johonkanen/ac_psu_zynq_kicad/REUSE_LOG.md

# Changes to the reused DDR3 block

Source: juliancoy/zynqPCB, commit `5cb7c703` (NOTICE). The block is everything inside the `User.1` outline (PLAN.md §4.1).
Any change to its parts or copper goes here, with the reason and how it was checked. **Planned** entries are made
after the import (PLAN.md §4.2). **Done** entries name the commit.

| # | Status | Change | Why | Check |
|---|---|---|---|---|
| E1 | **done 2026-10-29** (`tools/block_e1.py`, run by `build_pcb.sh --rebuild` after the import) | **CK trunk (SoC → U16, In2 `SIGNAL1`):** add a coupled meander to the pair, plus extra length on CK_P only. Targets: **CK_P +4.30 mm (+28.5 ps), CK_N +3.23 mm (+21.4 ps)**, i.e. CK = DQS0 + 25 ps and CK P/N matched. Room: the straight runs at x = 165.2, y 125.6–130.5 (≈ 0.6 mm free per side) and y 117.9–120.4 (≈ 1 mm free per side), in source coordinates | UG933: CK ≥ DQS for every byte (write levelling). On JLC081611-7628 byte 0 is at **CK − DQS0 = 0.0 ps**. CK P/N is 7.1 ps (N leg 1.5 mm longer, which over-compensates the 2.9 ps package difference) | `tools/ddr3_review.py` on both DRAMs: byte 0 CK − DQS ≥ +20 ps, CK P/N ≤ 1 ps; A/C − CK stays inside ±123 ps (expected −24…+7 ps); DRC with our rules |
| E2 | planned, optional | DQS3_N +1.34 mm (+8.9 ps) on In2 | DQS3 P/N 8.9 ps, the largest pair skew in the block | as E1 |
| E3 | done in the schematic (`tools/sheets/01_ddr3.py`, 067ab9f); **copper done at the import** | U8 (TPS51200) EN: the global label `DDR3_VTT_EN` becomes a hierarchical label (sheet port, input), to be driven by our power sequencing (sheet 4). R25 (20 k to 3V3, on juliancoy's DDR3 sheet) stays as the EN pull-up; PS_MIO14 is no longer on the net | keeps bank 500 free and at 1.8 V (the 20 k pull-up to 3V3 would back-drive a 1.8 V MIO) | `tools/check_block_netlist.py`: U8.7 + R25.2 form one net, as in the source minus U20.B6; ERC (the port is undriven until sheet 4 exists) |
| E4 | done in the schematic (`tools/sheets/01_ddr3.py`, 067ab9f) | U15/U16 value MT41K256M16HA-125:E → MT41K256M16TW-107:P (same land); MPN = MT41K256M16TW-107:P, LCSC = C253882; the SnapEDA fields Field4–Field8 (they name HA-125:E) and the Digikey SPN dropped | HA-125 has 0 stock at JLC | footprint unchanged (`DFTcustom:FBGA-96-DDR3-SDRAM`, checked by `tools/check_block_netlist.py`); courtyard for the 8 × 14 mm body still to check at the copper import |
| E5 | done in the schematic (`tools/sheets/05_soc_power.py`, 957524d); copper: H10 cut from +1V8 at the import, **planelet + via planned (phase 4)** | **VCCPLL (U20 H10)** is cut from +1V8 and fed from 1V8 through FB501 (BLM18SG121TN1D, 0603) + C528 10 µF 0603 + C529 0.47 µF 0402: net `VCCPLL`. **FB1** (juliancoy's bead on VCCAUX) stays on its land as a **0 Ω jumper**, so VCCAUX is on 1V8. Copper: isolate the H10 via from the +1V8 pour and run a planelet (≥ 2 mm, < 76 mm) to C528; C529 within 5.1 mm of the H10/GND vias | UG933 Ch. 5: when VCCPLL comes from VCCPAUX it **must** go through a 120 Ω bead + ≥ 10 µF 0603. juliancoy has the bead on VCCAUX and VCCPLL straight on +1V8. With FB1 = 0 Ω the 1V8 caps count for VCCAUX (UG933 Table 3-1); as a bead, VCCAUX would need its own 47/4.7/0.47 µF (user, 2026-10-27) | `tools/check_block_netlist.py`: U20.H10 listed as an expected difference, FB1 pads keep the source nets; ERC (PWR_FLAG on VCCPLL) |
| E6 | done in the schematic (`tools/sheets/05_soc_power.py`, 957524d); **copper done at the import** | **C59 (ball E12, MIO1) and C122 (ball C6, MIO0)**, +3V3 on juliancoy, are on 1V8 | both MIO banks are 1.8 V (decided 2026-10-26); juliancoy runs them at 3.3 V | `tools/check_block_netlist.py`: C59.1 / C122.1 expected differences |
| E7 | done in the schematic (VCCO_MIO: `tools/sheets/06_soc_config.py`; VCCO_34/35: `tools/sheets/11_soc_pl.py`); copper: VCCO_MIO done at the import, **12 VCCO_34/35 balls to connect (phase 4)** | **U20 VCCO balls whose rail changes:** VCCO_MIO0 B3, C6 and VCCO_MIO1 A10, B13, D9, E12 go from +3V3 to **1V8**; VCCO_34 K17, L20, N16, P19, R22, T15 and VCCO_35 A20, C16, D19, E22, F15, G18, H21 go from **GND** (banks unused on juliancoy) to **3V3**. Their fan-out vias must not be imported with the source net; map them by ball | MIO banks at 1.8 V; banks 34/35 carry our PL I/O at 3.3 V. The schematic side comes with the bank units (sheets 6 and 11), which the check then compares | `tools/check_block_netlist.py` expected differences (sheet 6 for VCCO_MIO, sheet 11 for VCCO_34/35); DRC after the import |
| E8 | done in the schematic (`tools/sheets/06_soc_config.py`, 9c5470b); **copper done at the import** | **RSVDGND (U20 G10) left open**: juliancoy ties it to GND. Drop its GND via/connection at the copper import | UG865 v1.9 Table 1-5: "Reserved pins—do not connect" (revised in v1.8) (user, 2026-10-27) | `tools/check_block_netlist.py`: U20.G10 expected difference |
| E9 | done in the schematic (`tools/sheets/11_soc_pl.py`); **copper done at the import** (the J3 balls are routed in phase 4) | **Banks 34/35 I/O balls off GND:** juliancoy ties all 50 I/O balls of each unused bank (34, 35) to GND, with their VCCO. Here bank 34 carries the 32 J3 signals and PUDC_B (K16) goes to VCCO_34 = 3V3; the other bank 34 balls and all of bank 35 (spare) are left open. At the import, drop the GND vias/connections of these 100 balls and map them by ball, as for E7 | UG933 *Unconnected VCCO Pins*: an unused bank's VCCO and I/O balls all on one potential (GND on juliancoy). With VCCO at 3V3 (E7), an I/O ball on GND would be a short as soon as the PL drives it, and K16 must be high (STATUS.md, J3 safe state) | `tools/check_block_netlist.py`: the 100 balls are expected differences (one line per bank); DRC after the import |
| E10 | **copper done at the import** (2026-10-28, `ESCAPES` in `tools/import_block.py`) | **QSPI escapes copied:** for U20 A1 (`qspi_cs_n`), A2 (`qspi_io0`), A3 (`qspi_io3`), A4 (`qspi_sclk`), E4 (`qspi_io2`), F6 (`qspi_io1`), juliancoy's F.Cu fan-out from the ball to its first via (0.102 mm, 0.57–2.91 mm; one 0.48/0.25 via each, inside the block outline) is copied on our net. 8 segments + 6 vias. Phase 4 routes on from the vias | These balls face the DDR (bank 500, row A) and are walled in by byte-0 copper (DM0, DQ0/2/4/6, DQS0, DRST#): the router reports them `boxed_in_static` at every pose. juliancoy uses the same MIO1-6 for his boot flash and escapes them this way | the import asserts each escape is one F.Cu run to exactly one via with no other pad, on the expected net; with the escapes, 3 of the 6 nets route U20 → U801 on a trial board (the rest stop at U801's inner CSP balls, a flash fan-out question) |
| E11 | done in the schematic (`tools/set_lcsc.py`, run by `tools/build_schematic.sh`; 2026-10-29) | **JLC part numbers:** every block part gets an `LCSC` field. juliancoy's Murata/Yageo/Taiyo Yuden passives that JLC has as a basic part of the same value, size and dielectric (voltage at least the source's) are bought as that part: MPN changed, the Digi-Key fields MFR/SPN/SPR/SPURL dropped (CC0402KRX5R5BB474, GRM155R60G475ME47D, GRM188R61A106KE69J, JMK325ABJ107MM-P, GRM155R71H103KA88J, CC0402KRX7R6BB104, RC0402FR-0710KL, RC0402JR-074K7L, RC0402FR-07100KL, RC0402FR-07150RL). The rest keep their MPN (R25 0.1 %, the 40.2/80.6/240 R). FB1 (the E5 0 R) gets 0603WAF0000T5E / C21189: its MPN field still named the bead, so the BOM listed it as BLM18AG121SN1D. U20 = XC7Z020-2CLG484I / C157624 | JLC assembly; basic parts have no extended-part fee | values and footprints unchanged: `tools/check_block_netlist.py` 0 failures, DRC parity 0 |
| E12 | done (2026-10-29): schematic `tools/sheets/05_soc_power.py`, footprint swap `FP_SWAP` in `tools/check_block_netlist.py` (used by `make_board.py` and `import_block.py`) | **C67** (3V3 bulk, B.Cu) 100 µF 1210 → **22 µF 1206** CL31A226KAHNNNE (C12891, 25 V, 1.6 ± 0.2 mm) on the library C_1206 land at juliancoy's position and orientation; his via-in-pad copper unchanged (the 1206 pads sit 0.075 mm further out, the vias stay inside them) | the 1210 (2.7 mm max) over baseboard U17 (SOIC-16W, 2.65 mm) left −0.05 mm of the 5.3 mm gap; every 100 µF and 22 µF 1210 is 2.5 mm nominal. 22 µF is enough (user, 2026-10-29) | `check_heights.py` 0.85 mm left; `check_block_netlist.py` reports the footprint as expected; `import_block.py` pad check within 0.1 mm; both pads connected to their vias (pcbnew connectivity); DRC parity 0 |
| E13 | done (2026-10-30): `tools/block_e13.py`, run by `build_pcb.sh --rebuild` after `block_e1.py` | **C99** (1V35 bulk, 100 µF 1210, F.Cu) moved **2.2 mm north** (towards U15), to (156.9, 72.6) at pose A. Its GND via-in-pad stays at juliancoy's place (156.9, 76.2) and a 0.3 mm F.Cu GND track joins the moved pad 2 to it: under the moved pad the inner layers carry DDR3 copper everywhere (DQS3_N on 3.Sig among others), so no 0.48 mm via fits there. Pad 1 stays on the F.Cu 1V35 pour | its body (2.7 mm max) reached 1.2–1.4 mm inside the heatsink base (24 × 23.5 mm on U20, POWER_BUDGET.md §Heatsink), where nothing may be taller than the package (≈ 1.5 mm); found on the phase 3 renders. The body now ends at y 74.3, 0.7 mm clear of the base | DRC unchanged (0 parity, no clearance or courtyard errors, unconnected count unchanged, so both pads connect); `check_block_copper.py` 0 failures (rails are not compared item by item); a `--rebuild` reproduces the board (tracks and footprints identical) |

**E1 as built (`tools/block_e1.py`, 2026-10-29).** The room named above (source x 165.2, y 125.6–130.5 and 117.9–120.4)
is, in our frame, the trunk's straight runs at U20 + (−0.80/−0.60, −16.4…−11.5) and (−0.80, −24…−21.6), around
juliancoy's own small CK meander:
- a **coupled serpentine** of the pair in the 4.7 mm window y 70.65–75.35: rungs at 0.5 mm pitch, amplitude 0.299 mm,
  45° corner cuts; P and N are the centreline's ±0.102 mm offsets, so the 0.102 mm gap holds. Both legs +3.230 mm;
- a **P-only bump** 0.711 mm west of CK_P at y 63.3–64.9 (the free side; N stays straight): CK_P +1.070 mm.
- Totals: **CK_P +4.300 mm, CK_N +3.230 mm.** Nearest other net 0.208 mm (BA1). The script checks clearance before it
  writes, against In2 copper and every via.
- `tools/ddr3_review.py`, both DRAMs: **byte 0 CK − DQS +27.5 ps** (was +2.6), **CK P/N 0.0 ps (U16) / 0.1 ps (U15)**
  (was 7.1), addr/cmd − CK −24.3…−0.6 ps (U16) and −21.1…+1.8 ps (U15): all PASS at the derated limits. KiCad DRC: no
  new errors. `tools/check_block_copper.py` lists DDR3_CK_P/N as the expected E1 difference. The import makes the copper side of E3 and E5–E9 itself:
it detaches every ball whose net changed, then handles its fan-out (the copper serving only that ball):

| Balls / pads | What the import did |
|---|---|
| E7 VCCO_MIO (B3, C6, A10, B13, D9, E12), E6 (C59.1, C122.1), E7 C16 (VCCO_35) | fan-out kept, moved to the ball's new net (1V8; 3V3 for C16) |
| E3 B6 | the PS_MIO14 branch removed: the F.Cu dog-bone and 21 items of the In6 trace back to R25/U8 (pruned); R25–U8.7 stays |
| E8 G10, B15 (bank 35, now open) | fan-out dropped |
| E5 H10 | its fan-out also served neighbouring +1V8 balls, so the items on H10 were dropped and H10 has no via yet. **Phase 4:** a via and the VCCPLL planelet to C528, as in E5 |
| E9: the 100 bank 34/35 I/O balls (except B15); E7: the other 12 VCCO_34/35 balls; PUDC_B K16 | **no copper of their own in the source** (they reached GND through the F.Cu pour only). The copied pour now clears them. **Phase 4:** connect VCCO_34/35 to 3V3 and route the J3 balls |

Check: `tools/check_block_copper.py`. All 82 signal nets of the block match the source item by item; the only
difference is E3 (23 items). `tools/ddr3_review.py` on both DRAMs gives the source's lengths, layers and vias; the
delays differ by up to 5 ps, because the via barrels are now computed on the real stack-up (the source file has none).

**Bank 0 stays at 1.8 V, as on juliancoy** (user, 2026-10-27): VCCO_0, RSVDVCC1–3, CFGBVS (to GND) and the
PROGRAM_B/INIT_B pull-ups R9/R10 keep the source's nets and copper. So no entry is needed for them.

**SoC decaps in the block** (sheet 5, source refs), from juliancoy's power.sch: C4, C5, C8, C9, C11, C14, C15, C17–C20,
C23, C24, C26, C28–C31, C33, C34 and FB1. The rule is a footprint centre within 4 mm of the U20 body. The 3V3 caps
under U20 that juliancoy drew on other sheets are in the block too: C46, C47, C50, C55, C57, C59, C61, C65, C67, C114,
C116–C119, C121, C122. Not in the block: the bulk caps among juliancoy's regulators (C6, C12, C22, C25, C27, C32,
15–22 mm from the centre).
