johonkanen/ac_psu_zynq_kicad/ZYNQ_PCB_NOTES.md

# XC7Z020-CLG484 PCB design notes

Device rules for the schematic and the layout of the Zynq control card. The board-level decisions (which signal goes
where, part choices) are in `PLAN.md`; the review of the reused DDR3 block is in `DDR3_REVIEW.md`. This file covers
what the Zynq-7000 itself requires.

Written 2026-10-26, from:
- UG933 (PCB design guide) v1.13.1;
- DS187 (data sheet) v1.21;
- UG865 (packaging and pinout) v1.9;
- UG585 (TRM), the HTML edition on docs.amd.com.

The PDFs are not in git; `reference/vendor/README.md` lists them and how to fetch them. Items marked **[verify]**
still need checking against a primary source or the Vivado pin planner.

---

## 1. Package

- **XC7Z020-2CLG484I** (LCSC C157624). User decision 2026-10-29: speed grade −2 or −3, any temperature grade JLC
  stocks; not −1 (was 2026-10-26: −1 or −2). Same balls and package delays.
- CLG484: 19 × 19 mm, 0.8 mm pitch, wire-bond, 22 × 22 array.
- **200 PL SelectIO** (all HR, in banks 13, 33, 34, 35) and **128 PS I/O** (UG865 Table 1-2).
- The -1 and -2 grades share the footprint and pinout; -2 runs the CPUs faster (766 vs 667 MHz).

| Bank | Type | Contents | VCCO on this card |
|---|---|---|---|
| 0 | config | PROGRAM_B, INIT_B, DONE, CFGBVS, JTAG, XADC, DXP/DXN, VCCBATT | **1.8 V**, as on juliancoy (user, 2026-10-27): the block's copper for VCCO_0, RSVDVCC and R9/R10 stays as it is |
| 13, 33, 34, 35 | PL HR (1.2–3.3 V) | user I/O; PUDC_B is ball **K16**, IO_L3P_T0_DQS_PUDC_B_34 | **3.3 V** (J3, J5, ADC, LEDs directly; no translators) |
| 500 | PS MIO0 | MIO[15:0], PS_CLK, PS_POR_B | **1.8 V** (QSPI IS25WP128; decided 2026-10-26) |
| 501 | PS MIO1 | MIO[53:16], PS_MIO_VREF, PS_SRST_B | **1.8 V** (eMMC VCCQ, RGMII) |
| 502 | PS DDR | DDR3L x32 (2 × MT41K256M16TW-107, the juliancoy block), dedicated balls | 1.35 V |

The 7Z020 has no HP banks, so the PL I/O cannot use DCI or anything above 3.3 V.

## 2. Supplies

DS187 Table 2 (recommended operating conditions) and the plan for this card. PS and PL rails may be merged as UG933
allows, as on the source boards.

| Rail on the card | V | Zynq pins | Range (DS187) | Notes |
|---|---|---|---|---|
| `1V0` | 1.00 | VCCPINT, VCCINT, VCCBRAM | 0.95–1.05 | VCCPINT "can be combined with VCCINT" when the PL never powers down alone (UG933 Ch. 5). VCCINT and VCCBRAM must share a supply (DS187 note 5) |
| `1V8` | 1.80 | VCCPAUX, VCCAUX, VCCO_MIO0, VCCO_MIO1, VCCO_0, RSVDVCC[3:1] | 1.71–1.89 | both MIO banks and bank 0 at 1.8 V; VCCAUX through FB1, now a 0 Ω jumper (REUSE_LOG E5) |
| `VCCPLL` | 1.80 | VCCPLL | 1.71–1.89 | from 1V8 through a 120 Ω @ 100 MHz 0603 bead + 10 µF 0603. A 0.47–4.7 µF 0402 cap goes ≤ 5.1 mm of trace from the VCCPLL/GND vias. A planelet ≥ 2 mm wide and < 76 mm long, or a trace ≤ 40 Ω and < 50.8 mm (UG933 Ch. 5; parts BLM18SG121TN1, GRM188R60G106ME47, GRM155R60J474KE19) |
| `1V35` | 1.35 | VCCO_DDR | 1.14–1.89 | DDR3L; also the DRAM VDD/VDDQ |
| `0V675` | VCCO_DDR / 2 | PS_DDR_VREF0/1, DRAM VREFCA/VREFDQ, VTT if used | – | divider or tracking regulator (§6.3) |
| `3V3` | 3.30 | VCCO_13/33/34/35 | 1.14–3.465 (HR VCCO) | |
| `VCCADC` | 1.80 | VCCADC_0 / GNDADC_0 | 1.71–1.89 | XADC unused: VCCADC to VCCAUX through a bead, GNDADC to GND **[verify against UG480]**. The source has VCCADC (K11) straight on +1V8, inside the block copper |
| – | – | VCCBATT_0 | 1.0–1.89 | no bitstream encryption: tie to GND or VCCAUX (DS187 note 10). The source ties it (G9) to GND, and so do we (block copper) |

**Decoupling** (UG933 Tables 3-1 and 3-2, CLG484 Z-7020; capacitor specs in Table 3-3):

| Supply | 330 µF | 100 µF | 47 µF | 4.7 µF | 0.47 µF |
|---|---|---|---|---|---|
| VCCINT | 1 | – | – | 2 | 4 |
| VCCBRAM | – | 1 | – | 1 | 1 |
| VCCAUX | – | – | 1 | 1 | 2 |
| VCCO per HR bank | – | 1 (47 or 100; one per four HR banks, note 3) | | 2 | 4 |
| VCCO_0 | – | – | 1 | – | – |
| VCCPINT | – | 1 | – | 1 | 3 |
| VCCPAUX | – | 1 | – | 1 | 1 |
| VCCO_DDR | – | 1 | – | 1 | 4 |
| VCCO_MIO0 / MIO1 | – | 1 each | – | 1 each | 1 each |
| VCCPLL | 10 µF + 0.47–4.7 µF (above) | | | | |

UG933 allows consolidating bulk capacitors when rails are merged (*Bulk Capacitor Consolidation Rules*, Ch. 3).
Sheet 5 (`tools/sheets/05_soc_power.py`) counts the block's caps per merged rail and adds the rest (C501–C529).
0.47 µF parts go under the BGA on B.Cu, as on the earlier cards.

## 3. Power sequencing and reset (DS187, UG585)

- **PS order (recommended):** VCCPINT → VCCPAUX + VCCPLL → VCCO_MIO0/MIO1 + VCCO_DDR. Reverse it at power-off.
  Supplies with the same voltage may share a regulator and ramp together.
- **PL order (recommended):** VCCINT + VCCBRAM → VCCAUX → VCCO.
- PS and PL are independent: either may come up first.
- **Ramp time:** 0.2–50 ms for every rail (DS187 Table 7).
- **VCCO_MIO / VCCO – VCCAUX/VCCPAUX ≤ 2.625 V,** except for at most T_VCCO2VCCAUX per power cycle: 800 ms at
  Tj 85 °C, 500 ms at 100 °C (DS187 Table 7). A 3.3 V bank rising before 1V8 counts against that time. So bring 1V8
  up no later than 3V3, which the enable chain below does.
- **PS_POR_B:**
  - Low until VCCPINT, VCCPAUX and VCCO_MIO0 are at their minimum, then at least **T_PSPOR = 100 µs** more
    (DS187 Table 22).
  - Do not release it inside the secure lockdown window relative to the last PL supply ramp (DS187 Figure 1).
    DS187 Table 23 gives T_SLW = t(last of VCCINT/VCCBRAM/VCCAUX/VCCO_0 at 250 mV) − t(PS_POR_B release); at 33.33 MHz
    the forbidden ranges are 12…40 ms (default), −16…12 ms (eFUSE CRC), −27…13 ms (PLL bypass) and −746…−705 ms
    (both). Here the last of those supplies is 1V8 (VCCAUX, VCCO_0), and PS_POR_B is released 180–425 ms after it
    (TPS3808 CT = VDD, 300 ms typ.), outside every range. CT open (12–28 ms) would not be.
  - At power-off, before VCCPINT falls below 0.80 V, assert PS_POR_B (or stop PS_CLK, or let VCCPAUX < 0.70 V or
    VCCO_MIO0 < 0.90 V) until VCCPINT < 0.40 V. This protects the eFUSEs.

  → A supervisor on the last rail's power-good, open-drain onto PS_POR_B, delay 300 ms (lockdown window above). It is
  the same scheme as the Ti135 card's TPS3808 into CRESET_N. Its SENSE watches 1V0 (0.895 V) for the power-off rule.
- **PS_SRST_B:**
  - pull up to VCCO_MIO1;
  - must be High to boot;
  - must not be asserted while the BootROM runs, or it locks down until the next POR (UG585 *External Reset Signal
    Pins*);
  - the minimum pulse is 3 PS_CLK cycles. A reset button belongs on PS_SRST_B, not on PS_POR_B (NASR-M ERRATA).
- **Enable chain (drawn, sheets 3–4):** 5V0 → `1V0` → PG → `1V8` (+ VCCPLL, VCCADC) → PG → `3V3` and `1V35` together →
  PG(3V3) & PG(1V35) = `DDR3_VTT_EN` (TPS51200 VTT) and the supervisor's ~MR → 300 ms → PS_POR_B. It meets both
  recommended orders and the VCCO – VCCAUX rule (3V3 starts only after 1V8 is at 95 %). Every TLV62585 ramps in
  0.9 ms (0.2–50 ms).

## 4. PS clock, boot mode and MIO

### 4.1 PS_CLK

- 30–60 MHz, single-ended LVCMOS at the **VCCO_MIO0 level**;
- duty cycle 40–60 %, ≤ ±0.5 % RMS jitter, rise/fall ≤ 6 ns (DS187 Table 20);
- the usual choice is a 33.333 MHz oscillator, as on pinguz97 and the ZedBoard; **here a 1.8 V part**, since bank 500 is
  at 1.8 V.

### 4.2 Boot mode straps (UG585 *Boot Mode Pin Settings*)

MIO[8:2] are sampled at PS_POR_B release. Every one needs **its own 20 kΩ** pull-up (1) or pull-down (0):
- **pull-ups go to VCCO_MIO0 only** (UG933 caution);
- no resistor trees: use one resistor plus a jumper if the strap must be changeable;
- the stub on MIO8 stays < 10 mm (it is also the QSPI feedback clock).

| Pin | Function | Setting on this card |
|---|---|---|
| MIO2 | BOOT_MODE[3]: JTAG chain | 0: cascaded (PS DAP + PL TAP on one JTAG) |
| MIO5 / MIO4 / MIO3 | BOOT_MODE[0] / [2] / [1]: boot device | **1 / 0 / 0 = Quad-SPI**. JTAG 000, NOR 001 (MIO3), NAND 010 (MIO4), SD 110 (MIO5 + MIO4) |
| MIO6 | BOOT_MODE[4]: PLLs | 0: PLLs enabled |
| MIO7 | VMODE[0]: bank 500 | **1 (pull-up) = 1.8 V**; 0 = 2.5/3.3 V. **Must match VCCO_MIO0, or I/O damage is possible** |
| MIO8 | VMODE[1]: bank 501 | **1 (pull-up) = 1.8 V** (the pull-up still goes to VCCO_MIO0, UG933 Table 5-3; both are 1V8 here) |

**The Zynq-7000 BootROM cannot boot from eMMC.** Its boot devices are QSPI, NOR, NAND, SD and JTAG. So:
- QSPI holds the FSBL, the bitstream and U-Boot;
- Linux and the rootfs go on the eMMC;
- JTAG boot is the recovery path, since the card has no SD socket.

### 4.3 MIO allocation (Vivado pin plan, 2026-10-27)

Checked in Vivado 2024.2 by `vivado/pinplan/pinplan.py`. The full table with every strap and pull is
`vivado/pinplan/mio.csv`; the I/O settings Vivado applied are in `vivado/pinplan/ps7_mio.csv`.

| Interface | MIO | Bank | Settings / notes |
|---|---|---|---|
| QSPI0 (single, x4): **ISSI IS25WP128-RHLE** (C1349419, 1.8 V, 128 Mbit, shared with the Agilex/Ti135 cards) | 1 CS#, 2–5 IO0–3, 6 SCLK, **8 feedback clock** | 500 | LVCMOS 1.8 V, fast slew. Ref clock 200 MHz → SCLK ≤ 100 MHz (feedback mode; MIO8 carries only its strap resistor). UG933: IO0–3 and SS matched to SCLK within ±50 ps; minimum trace delay from T_QSPICKD < T_CKO,flash + 2·T_pd |
| GEM0 RGMII → RTL8211F(DI) | 16 TXC, 17–20 TXD0–3, 21 TX_CTL, 22 RXC, 23–26 RXD0–3, 27 RX_CTL | 501 | **HSTL 1.8 V**, no pull-ups, fast slew. Receivers use **PS_MIO_VREF (F8) = 0.9 V**: 10 k/10 k divider + 10 nF. PHY internal delays (`rgmii-id`): DATA/CTL to CLK ≤ ±50 ps including package (UG933) |
| MDIO0 | 52 MDC, 53 MDIO | 501 | pull-up on MDIO to 1V8 |
| SD0 → eMMC (4-bit) | 40 CLK, 41 CMD, 42–45 DAT0–3 | 501 | LVCMOS 1.8 V, fast slew, 50 MHz. **0 Ω (40–60 Ω) series on CLK at the MIO pin**; DAT/CMD to CLK skew 50–200 ps (UG933 *SDIO*). Zynq-7000 SDIO is 4-bit, SD 2.0 high speed ≤ 50 MHz: no HS200/HS400, so DAT4–7 and DS stay unused (pull-ups only). No card detect: `non-removable` in the device tree |
| UART1 (console) | 48 TX, 49 RX | 501 | **decided 2026-10-27:** PS UART on 1.8 V MIO + a translator to the 3.3 V J2 header. TX and RX go opposite ways, so it needs per-bit direction: **not** an SN74LVC2T45 (one DIR for both bits); e.g. an SN74AVC4T774 as on J1, or 2 × SN74LVC1T45. The FSBL and U-Boot can print before the PL is configured, which an EMIO/PL UART could not |
| I2C0 | 50 SCL, 51 SDA | 501 | for an optional MAC-address EEPROM; 4.7 k to 1V8 at the far end; RC glitch filters (UG933 *IIC*) |
| GPIO | 7 `emmc_rst_n` (output-only pin), 9 `eth_rst_n`, 10 `eth_int_n` | 500 | `eth_rst_n` drives the PHY's 3.3 V PHYRSTB through an open-drain buffer (as on the Ti135 card); `eth_int_n` pulled up to 1V8: INTB is open drain, 3.3 V tolerant (RTL8211F Rev. 1.7 Table 4), Vol 0.4 V < MIO VIL 0.63 V (closed 2026-10-27, sheet 9). The `eth_rst_n` pull-down is 1 k to beat the MIO reset pull-up (IRPU ≤ 220 µA) |
| spare | 0, 11–15, 28–39, 46, 47 | | MIO14 was juliancoy's VTT enable (REUSE_LOG E3). 28–39 would be USB0 (unused) |

### 4.4 PL pin plan (Vivado, 2026-10-27)

**Result:** `vivado/pinplan/zynq_pinplan.csv` (signal → ball, bank, pin function), all LVCMOS33.
- **Banks:** bank 34 has the 32 J3 signals (7 user I/O left). Bank 33 has the ADC (6), the LCD/touch (12) and the 2
  LEDs (20 left). Banks 13 and 35 are untouched (40 each).
- **Why bank 34 for J3:** on the CLG484 grid (top view), the DDR (bank 502) is on the left edge and the MIO banks are
  top left. Banks 35/34/33 run down the right edge, and bank 13 is along the bottom. With the DDR side facing away
  from J3, the right edge faces J3, and bank 34 is in the middle of it.
- **Copper:** juliancoy has banks 34/35 unused, with VCCO and every I/O ball on GND. Here they are at 3V3 and their I/O
  balls carry our nets or stay open (REUSE_LOG E7, E9).
- **Kept free inside the banks:** the clock-capable pins (MRCC/SRCC) and the VREF pins, for later clocks.
  **PUDC_B (K16) is never used as I/O.**
- **Ball order:** a first pass from the package edge inwards. Re-order it once the parts are placed (pin swaps inside
  a bank are free, and the flow re-checks them).
- **Vivado check:** PS7 + all PL pins, synthesised and placed: **DRC 0, no critical warnings**. CFGBVS = GND,
  CONFIG_VOLTAGE 1.8 (bank 0 at 1.8 V since 2026-10-27; re-run then).
- **ADC:** the ADS7056 DVDD goes to 3.3 V on this card, so its SPI runs on the 3.3 V bank directly. The Ti135 card had
  DVDD at 1.8 V.

**PS7 DDR settings** (`vivado/pinplan/ps7.tcl`):
- MT41K256M16 RE-125 preset (the closest 4 Gb x16 DDR3L preset to our TW-107), 32-bit, 533.333 MHz, all three
  training steps on.
- Write-levelling start (DQS_TO_CLK) per byte, die to die with REUSE_LOG E1: 0.025 / 0.111 / 0.181 / 0.164 ns.
- Board delay: 0.305 / 0.262 / 0.313 / 0.321 ns.
- These go straight into `ps7_init` (write-levelling initial ratios 0x3 / 0xf / 0x18 / 0x16). Vivado's own
  package-inclusive calculation from the lengths agrees (0.031 / 0.117 / 0.187 / 0.164 ns).

Bank voltages (decided 2026-10-26):
- **Bank 501 at 1.8 V**, fixed by the eMMC VCCQ and the 1.8 V RGMII.
- **Bank 500 at 1.8 V** with the **IS25WP128-RHLE**, the flash part shared with the other cards. PS_CLK is a 1.8 V
  oscillator, and MIO7 is pulled up.

QSPI notes:
- 128 Mbit = 16 MB is the most the BootROM reaches with 3-byte addressing in single-flash mode. It holds BOOT.bin (FSBL +
  bitstream + U-Boot; the 7Z020 bitstream is about 4 MB uncompressed **[verify size]**), with room for a fallback image.
  Linux and the rootfs live on the eMMC.
- RESET# (ball A4): on `ps_por_n` (sheet 8), so the flash resets together with the PS.
- Check that Vivado/Vitis `program_flash` and U-Boot (`spi-nor`) list the IS25WP128 **[verify]**; it has SFDP. Drop-in
  fallback on the same footprint, as on the other cards: Micron MT25QU256ABA8E12-1SIT (1.8 V). Note that above 16 MB
  the BootROM only maps the first 16 MB.

## 5. PL configuration and JTAG (bank 0)

| Pin | Connection | Source |
|---|---|---|
| CFGBVS_0 | **to GND** (VCCO_0 = 1.8 V, as on juliancoy); to VCCO_0 only when VCCO_0 is 2.5/3.3 V. Wrong = damage. Vivado: `CFGBVS GND`, `CONFIG_VOLTAGE 1.8` | UG865 Table 1-5 |
| PROGRAM_B_0 | 4.7 kΩ pull-up to VCCO_0 (not floating); R9 in the block | UG933, UG470 **[verify value]** |
| INIT_B_0 | 4.7 kΩ pull-up to VCCO_0 (open drain); R10 in the block | UG470 **[verify value]** |
| DONE_0 | 330 Ω pull-up to VCCO_0, optional LED (unconnected on juliancoy) | UG470 **[verify value]** |
| PUDC_B (ball K16, IO_L3P_T0_DQS_PUDC_B_34) | **tie to VCCO_34 (High) directly or through ≤ 1 kΩ** → no internal pull-ups during configuration. Never float | UG865 Table 1-5 |
| TCK, TMS, TDI | pull-ups (UG933 *Boot Mode Pins* note); JTAG at VCCO_0 = **1.8 V**; J1 is 3.3 V (FTDI mini-modules, no VREF) through an SN74AVC4T774RSVR shifter, the Agilex 3 card's circuit (sheet 6). One header serves PS and PL (cascaded, MIO2 = 0) | UG933 |
| DXP_0 / DXN_0 | tie to GND when unused | UG865, UG933 |
| VP/VN, VREFP/VREFN | XADC unused: tie to GNDADC; VREFP/VREFN to GND selects the internal reference | UG480 **[verify]** |
| RSVDVCC[3:1] | **tie to VCCO_0** | UG865 Table 1-5 |
| RSVDGND | **do not connect** (UG865 v1.9; juliancoy ties G10 to GND, REUSE_LOG E8) | UG865 Table 1-5 |
| VCCBATT_0 | GND or VCCAUX (no encryption) | DS187 |

**PUDC_B High plus the 10 kΩ pull-downs on every J3 pin** keep the PWM/gate outputs low until the bitstream drives them.
This is the Zynq equivalent of the Ti135 card's gated translator OE (Ti135 `MIGRATION_PLAN.md` §3.2).

## 6. DDR3/DDR3L

### 6.1 Memory types, and why not DDR4

**The Zynq-7000 PS DDR controller supports DDR3, DDR3L, DDR2 and LPDDR2 only** (UG933 Table 5-1, UG585 *DDR Memory
Types*). There is no DDR4 option:
- not in the PS;
- not in the PL either: the 7-series MIG has no DDR4 support, and the 7Z020 has only HR banks anyway.

DDR4 begins with Zynq UltraScale+ (MPSoC). So "DDR4 routing" does not apply to this card; the rules below are the
DDR3/DDR3L ones.

**Controller limits** (UG585 *Connectivity Limitations*):
- 1 GB total;
- 16- or 32-bit data width (ECC only as 16 + 10 bits);
- 1 rank;
- 15 row bits and 3 bank bits: one x16 4 Gb chip (MT41K256M16) is the most a 16-bit bus can hold, so 512 MB;
- **16-bit mode uses PS_DDR_DQ[15:0], i.e. byte lanes 0 and 1** (UG585 *DDR I/O Signals*). Lanes 2/3 are left
  unconnected (UG933 Table 5-5).

Data rate: **DDR3/DDR3L ≤ 1066 Mb/s on every speed grade** (DS187 Table 18). Run 1066, with 800 as the fallback.

### 6.2 Connections (UG933 Ch. 5)

| Item | DDR3/DDR3L value |
|---|---|
| VCCO_DDR | 1.5 V (DDR3) / **1.35 V (DDR3L)** |
| PS_DDR_VREF0/1 | VCCO_DDR / 2: a divider or tracking regulator plus 0.01–0.47 µF. A separate divider and HF cap per IC if dividers are used. Floating when the internal VREF is used, which limits the rate to 800 Mb/s |
| VTT (only with parallel termination) | VCCO_DDR / 2 from a DDR termination regulator (e.g. TPS51200) |
| **PS_DDR_VRP → GND, PS_DDR_VRN → VCCO_DDR** | each through **2 × the trace impedance**: **80 Ω** for 40 Ω traces (UG933 Table 5-2). pinguz97 has these swapped (`DDR3_REVIEW.md` F2) |
| Rterm (addr/cmd/ctrl, to VTT, near the last DRAM) | **40 Ω** |
| Rclk (across CK_P/CK_N at the DRAM) | **80 Ω** |
| DRST_B | not terminated; **4.7 kΩ pull-down** |
| ZQ (DRAM) | **240 Ω 1 %** to GND per DRAM |
| DM | connect (DDR3 data mask) |
| TDQS_P/N (x8 parts) | not supported: leave floating |
| Single-ended DQS | DQS → DQS_P, DQS_N to the DRAM DQS# or a VCCO/2 divider |
| Unused pins (x16, no ECC) | lane 2/3 DQ/DQS/DM unconnected (software pull-ups) |

### 6.3 Routing (UG933 Ch. 5 and Appendix A)

- **Impedance:** 40 Ω single-ended and 80 Ω differential, ±10 %. Every DDR signal except DRST_B is controlled; for
  DDR3, CKE is controlled too.
- **Max length:** 8.55" (217 mm) for data and for addr/cmd.
- **Topology** (Table 5-12):
  - one DRAM: point to point for data, clock and addr/cmd;
  - two DRAMs: data point to point; clock fly-by; addr/cmd fly-by (or balanced T).
  - **Fly-by:** TL0 0–5.3", TL1 between DRAMs 0.35–0.75" (8.9–19 mm), TL2 to Rterm 0–1.0", total ≤ 8.55".
  - **Balanced T:** TL0 ≤ 3", equal branches on one layer, Rterm at the split.
  - Fly-by and point to point are recommended.
- **Delay matching, package delays included** (Table 5-9):
  - DQ/DM to DQS_P/N in the byte ±10 ps;
  - addr/cmd/ctrl to CK_P/N ±10 ps.

  These limits hold only at the SoC's rated speed with memory of the same rating. Appendix A relaxes them:

  | DDR3L, SoC rated 1066 | memory 1866 | memory 1600 | memory 1333 | memory 1066 |
  |---|---|---|---|---|
  | DQ/DM–DQS at 1066 | ±91 ps | ±50 ps | ±45 ps | ±10 ps |
  | addr–CK at 1066 | ±123 ps | ±103 ps | ±83 ps | ±10 ps |
  | both at 800 | ±150 ps | ±150 ps | ±150 ps | ±150 ps |

  (DDR3 at 1.5 V: DQ–DQS 104/91/73/45 ps at 1066; Table A-1.) With MT41K256M16TW-107 (1866) at 1066 MT/s the budget is
  **±91 / ±123 ps**.
- **CK ≥ DQS for every byte.** Write levelling can only delay DQS to meet CK. Read levelling is per byte, so
  bit-to-bit skew inside a byte matters. **Addr/cmd has no training**, only a fixed programmable offset, so keep
  CK–addr skew small.
- **Differential pairs:** match P/N so the crossing falls in the linear part of the edges (a few ps).
- **Swaps:** bit and byte swapping are allowed for DDR3 (Table 5-12 text), but bits stay inside their byte group. On
  a x16 part, "byte swap" means DRAM lower/upper byte ↔ controller lane 0/1, not a move to lanes 2/3.
- Keep each byte (DQ, DM, DQS) on one layer, over a solid GND reference. Change layers only next to a GND return via.
- **Place the DRAM as close as possible** (UG933).
- **Delays in KiCad:**
  - store the Xilinx package delays on the CLG484 pads: pad die length = mean delay / 6 ps/mm, as pinguz97's
    `footprint_add_die_lengths.py` does. KiCad 10 also takes pad-to-die *delays* directly, as the Ti135 repo's
    `tools/pad_to_die.py` writes;
  - measure die to die with `tools/ddr3_review.py` (`--pkg` takes the Vivado package CSV);
  - the per-layer speeds come from `tools/zsolve_cases.py` for the chosen stack-up.

### 6.4 Stack-up: JLC081611-7628 (decided 2026-10-26)

The copied block (juliancoy/zynqPCB) routes every DDR trace at **0.102 mm**, and pairs at 0.102/0.102 mm. Its file has
no stack-up, so the stack-up was chosen to put 0.102 mm on UG933's 40 Ω / 80 Ω.
- **Method:** `tools/stackup_scan.py` field-solved all 49 JLC 8-layer templates (KiCad files generated from JLC's API by
  gsuberland/jlcpcb_autogenerated_stackups), with juliancoy's layer roles: GND on In1/In3/In5, signals on
  F/In2/In4/In6.
- **Full table:** `reference/stackup_scan_0p102mm.txt`.
- **Layer use in the source:** CK and part of addr/cmd on In2 (`SIGNAL1`); all data on In4 (`SIGNAL2`); addr/cmd on
  In6 (`SIGNAL4`); 1 mm fan-out stubs only on F.

| Template | Thickness | Inner Cu | In2/In4 SE / diff | In6 SE / diff (no B plane) | F SE | Note |
|---|---|---|---|---|---|---|
| **JLC081611-7628** | 1.593 mm | 1 oz | **39.5 / 71.4 Ω** | **45.5 / 74.6** (47.4 / 74.9) | 111 Ω | **chosen** |
| JLC081611-2116B | 1.572 | 1 oz | 45.7 / 77.2 | 49.3 / 78.4 (53.3 / 79.2) | 103 | runner-up |
| JLC081211-1080C | 1.222 | 1 oz | 46.2 / 78.7 | 47.9 / 80.4 (63.8 / 88.4) | 78.5 | In6 depends on B |
| JLC081211-1080B | 1.282 | 1 oz | 47.3 / 79.3 | 49.1 / 81.0 | 78.5 | |
| JLC08121H-3313 | 1.193 | 0.5 oz | 51.2 / 86.7 | 47.9 / 83.3 (80.2 / 102.6) | 62.3 | cheapest near 50 Ω; In6 depends on B |
| JLC08081H-1080 | 0.772 | 0.5 oz | 41.1 / 76.2 | 36.1 / 69.1 | 55.5 | too thin for the sockets and the RJ45 |
| JLC08121H-1080A (pinguz97's) | 1.220 | 0.5 oz | 57.3 / 92.9 | 42.7 / 76.8 | 55.5 | |
| JLC08161H-3313 (Agilex/Ti135 cards) | 1.6 | 0.5 oz | > 60 on L5 | | | not suitable |

Build of JLC081611-7628:

```
F 35 um | 7628 prepreg 0.421 er 4.4 | In1 30 um | core 0.075 er 3.99 | In2 | prepreg 0.138 er 3.91 | In3 |
core 0.075 | In4 | prepreg 0.138 | In5 | core 0.075 | In6 | 7628 prepreg 0.421 er 4.4 | B
```

Why it was chosen:
- **1.6 mm**, so J3/J6/J9 stay as on the other cards.
- **In2/In4 (CK, data) are inside UG933's 40 Ω ±10 %.** The pairs are 71.4 Ω, 0.6 Ω under the 72 Ω lower limit:
  accepted.
- **In6 (addr/cmd) is 45.5 Ω and nearly independent of B.Cu** (47.4 Ω with no B plane). B is 0.42 mm away, so bottom-side
  regulators and pours under the block do not change it. On the thin-prepreg templates In6 jumps to 64–80 Ω where B is
  not solid.
- No re-width of the copied block is needed. Termination stays as UG933 has it (40.2 Ω, 80.6 Ω CK, 80.6 Ω VRP/VRN).

**Consequences for the rest of the board:**
- **F.Cu and B.Cu are poor impedance layers:** 0.102 mm is 111 Ω, and 50 Ω would take about 0.8 mm. Use them for
  fan-out, pours, power and slow signals. The exception is the **MDI pairs: 0.35/0.20 mm on F.Cu = 102 Ω**, which also
  follows NASR-M's erratum to keep MDI on an outer layer. The inner layers cannot reach 100 Ω differential at
  practical widths (0.10/0.40 mm gives 79 Ω).
- **Other single-ended nets on the inner layers** (RGMII, eMMC, QSPI): 0.09–0.102 mm gives 41–40 Ω, and 0.07 mm gives
  46 Ω. Fine for these interfaces, which have no impedance requirement in UG933, only skew limits.
- **Propagation for `ddr3_review.py`:** inner 6.63 ps/mm (In2/In4) and 6.80 (In6), outer 5.86. Pass `--ps-inner 6.65`
  (`--ps-outer 5.86`).
- **[verify at quote time]:**
  - JLC's minimum trace/space with 1 oz inner copper (the block needs 0.102/0.102 mm = 4/4 mil);
  - the surcharge for 1 oz inner and the 7628 template;
  - the via sizes against JLC's 8-layer rules.

### 6.5 PS7 configuration (Vivado)

- *DDR Configuration*:
  - memory part MT41K256M16 RE-125 (or the closest), DDR3 (low voltage), **32-bit** (2 × x16, 1 GB), 533.333 MHz,
    no ECC;
  - **Board delay** and **DQS to Clock delay** per byte, computed from `ddr3_review.py --json`: the trace delay of
    each byte's DQS and of CK, in ns;
  - write levelling, read gate and read DQS training: **on**.
- Run the FSBL's DDR init, then the Vitis `zynq_dram_test` (bring-up step 3) before anything else.

## 7. Required resistors at a glance

| Net | Part | Value |
|---|---|---|
| MIO2–MIO8 | one resistor each, to VCCO_MIO0 or GND | 20 kΩ (§4.2) |
| PS_POR_B | supervisor output, open drain, + pull-up to VCCO_MIO0 | 4.7–10 kΩ |
| PS_SRST_B | pull-up to VCCO_MIO1 | 4.7–10 kΩ |
| PS_MIO_VREF | divider VCCO_MIO1/2 + 10 nF | 2 × 10 kΩ (as on pinguz97) |
| CFGBVS_0 | to GND (VCCO_0 = 1.8 V) | direct |
| PUDC_B | to VCCO_34 | ≤ 1 kΩ |
| PROGRAM_B / INIT_B / DONE | pull-ups to VCCO_0 | 4.7 k / 4.7 k / 330 Ω **[verify UG470]** |
| TCK/TMS/TDI | on the 3.3 V side of the JTAG shifter: TCK 1 k down, TMS/TDI 10 k up; TDO 10 k up to 1V8 | 1 k / 10 kΩ |
| PS_DDR_VRP / VRN | to GND / to VCCO_DDR | 2 × Z0 (80 Ω for 40 Ω) |
| DRAM ZQ | to GND | 240 Ω 1 % |
| DDR_DRST_B | to GND | 4.7 kΩ |
| SD0 CLK | series, at the MIO pin | 0 Ω placeholder (40–60 Ω) |
| eMMC CMD / DAT0–3 | pull-ups to VCCQ (1V8) | 10–47 kΩ (KIOXIA: CMD 4.7–100 k, DAT 10–100 k) |
| I2C SCL/SDA | pull-ups at the far end | 4.7 kΩ |

## 8. Open items **[verify]**

- [ ] UG470 values for PROGRAM_B / INIT_B / DONE.
- [ ] XADC tie-off if it stays unused (UG480).
- [x] ~~The PS_POR_B secure-lockdown window~~ (DS187 v1.21 Table 23): closed with a 300 ms supervisor delay (§3, sheet 4).
- [ ] IS25WP128 support in Vivado `program_flash` and U-Boot; the 7Z020 bitstream size (§4.3).
- [x] ~~The full MIO and PL pin plan in Vivado~~ done 2026-10-27 (§4.3, §4.4).
- [x] ~~The UART path~~ PS UART1 on MIO48/49 + translator (§4.3).
- [x] ~~The RTL8211F INTB output level~~ open drain, 3.3 V tolerant: 4k7 to 1V8 is fine (2026-10-27, sheet 9).
- [ ] IS25WP128 reset recovery time after RESET# (on `ps_por_n`, sheet 8) vs the BootROM's first QSPI access.

## Sources

- UG933 *Zynq-7000 SoC PCB Design Guide* v1.13.1 (2019): Ch. 3 (decoupling), Ch. 5 (PS power and signalling, DDR),
  Appendix A (derating).
- DS187 *Zynq-7000 SoC (Z-7007S … Z-7020) Data Sheet: DC and AC Switching Characteristics* v1.21 (2020): Table 2,
  power sequencing, Table 7, Tables 18/20/22, Figure 1.
- UG865 *Zynq-7000 SoC Packaging and Pinout* v1.9 (2021): Tables 1-2 and 1-5.
- UG585 *Zynq-7000 SoC Technical Reference Manual* (docs.amd.com, map `27MqOpdJbAciY4iKGTycVA`): *Boot Mode Pin
  Settings*, *External Reset Signal Pins*, *DDR Memory Types, Densities, and Data Widths*, *DDR I/O Signals*.
- Package delays: `scripts/xc7z020clg484_delays.csv` in pinguz97/Zynq-SoM (a Vivado package file export).
