johonkanen/ac_psu_zynq_kicad/reference/baseboard_j11_pinout.csv

baseboard_pin | signal | direction_from_control_card | ti60_j11_pin(bottom-mounted) | agilex5_j3_pin_old(top-header numbering | before 2026-10-24)
1 | ISOADA3 | analog | 2 | 38
2 | ISOGND | gnd | 1 | 37
3 | ISOADA2 | analog | 4 | 36
4 | ISOADA1 | analog | 3 | 35
5 | ISOGND | gnd | 6 | 34
6 | MDATA_ISO | in | 5 | 33
7 | ADCLK_ISO | out | 8 | 32
8 | GPIO_BYPASS_RLY_ISOLATED | out | 7 | 31
9 | ADASEL2_ISO | out | 10 | 30
10 | ADASEL1_ISO | out | 9 | 29
11 | ADASEL0_ISO | out | 12 | 28
12 | SDATA1_ISO | in | 11 | 27
13 | CS1_ISO | out | 14 | 26
14 | CLK1_ISO | out | 13 | 25
15 | PWM_TRANS1_ISO | out | 16 | 24
16 | PWM_TRANS2_ISO | out | 15 | 23
17 | PWM_TRANS3_ISO | out | 18 | 22
18 | PWM_G4_ISO | out | 17 | 21
19 | PWM_G2_ISO | out | 20 | 20
20 | PWM_G1_ISO | out | 19 | 19
21 | PWM_G3_ISO | out | 22 | 18
22 | DAB_PWM_PRI_HI_ISO | out | 21 | 17
23 | DAB_PWM_PRI_LO_ISO | out | 24 | 16
24 | ADCLK_DAB | out | 23 | 15
25 | PWM_TRANS4 | out | 26 | 14
26 | MDATA_DAB | in | 25 | 13
27 | DAB_PWM_HI_SEC | out | 28 | 12
28 | PWM_TRANS6 | out | 27 | 11
29 | DAB_PWM_LO_SEC | out | 30 | 10
30 | PWM_Q5 | out | 29 | 9
31 | PWM_Q6 | out | 32 | 8
32 | INU_ADCLK | out | 31 | 7
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
