johonkanen/ac_psu_zynq_kicad/kicad/zynq_card.kicad_pcb

## KiCad design kicad/zynq_card.kicad_pcb (2026-10-30)

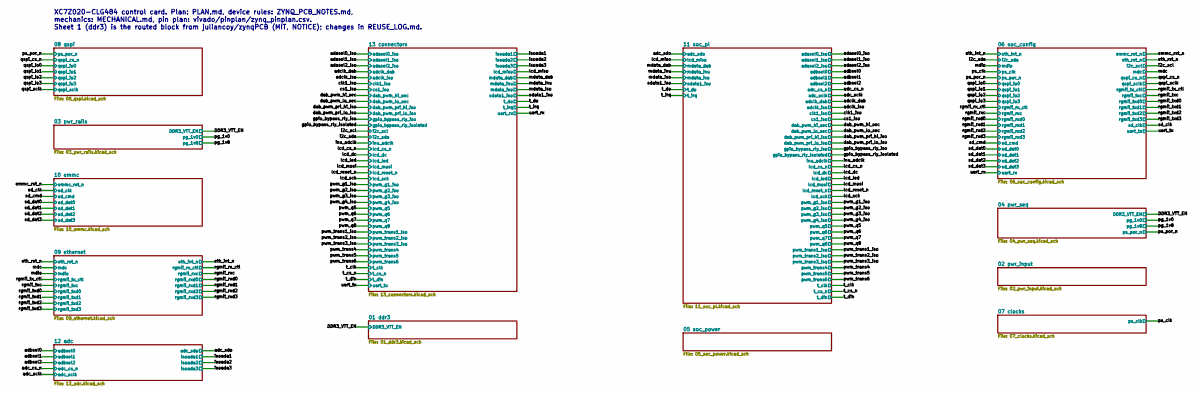
[picture p1: schematic zynq_card.kicad_sch, Zynq-7000 control card]

Notes on the sheet:
XC7Z020-CLG484 control card. Plan: PLAN.md, device rules: ZYNQ_PCB_NOTES.md, mechanics: MECHANICAL.md, pin plan: vivado/pinplan/zynq_pinplan.csv. Sheet 1 (ddr3) is the routed block from juliancoy/zynqPCB (MIT, NOTICE); changes in REUSE_LOG.md.

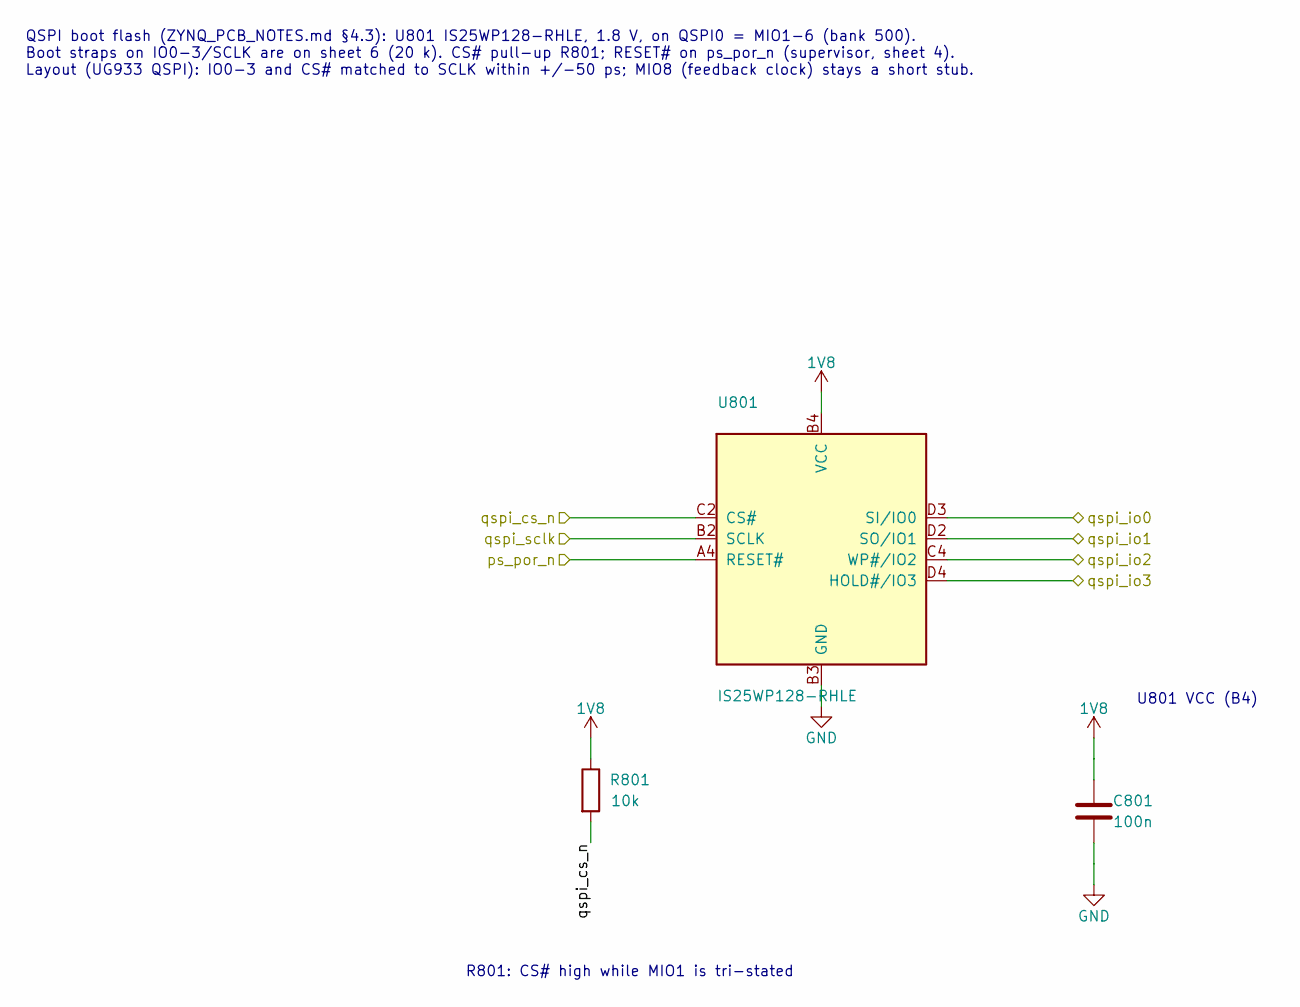
[picture p2: schematic 08_qspi.kicad_sch, Zynq-7000 control card - qspi]

Parts:
C801: 100n; C_0402_1005Metric; LCSC C1525
R801: 10k; R_0402_1005Metric; LCSC C25744
U801: IS25WP128-RHLE; MX25U25645G_CSP24_6x8mm_P1.0mm; LCSC C1349419

Connections:
1V8: C801.1, R801.1, U801.B4 (VCC); also elsewhere on the board
/ps_por_n: U801.A4 (RESET#); also elsewhere on the board
/qspi_cs_n: R801.2, U801.C2 (CS#); also elsewhere on the board
/qspi_io0: U801.D3 (SI/IO0); also elsewhere on the board
/qspi_io1: U801.D2 (SO/IO1); also elsewhere on the board
/qspi_io2: U801.C4 (WP#/IO2); also elsewhere on the board
/qspi_io3: U801.D4 (HOLD#/IO3); also elsewhere on the board
/qspi_sclk: U801.B2 (SCLK); also elsewhere on the board
GND: C801.2, U801.B3 (GND); also elsewhere on the board

Notes on the sheet:
QSPI boot flash (ZYNQ_PCB_NOTES.md §4.3): U801 IS25WP128-RHLE, 1.8 V, on QSPI0 = MIO1-6 (bank 500). Boot straps on IO0-3/SCLK are on sheet 6 (20 k). CS# pull-up R801; RESET# on ps_por_n (supervisor, sheet 4). Layout (UG933 QSPI): IO0-3 and CS# matched to SCLK within +/-50 ps; MIO8 (feedback clock) 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
R801: CS# high while MIO1 is tri-stated
U801 VCC (B4)

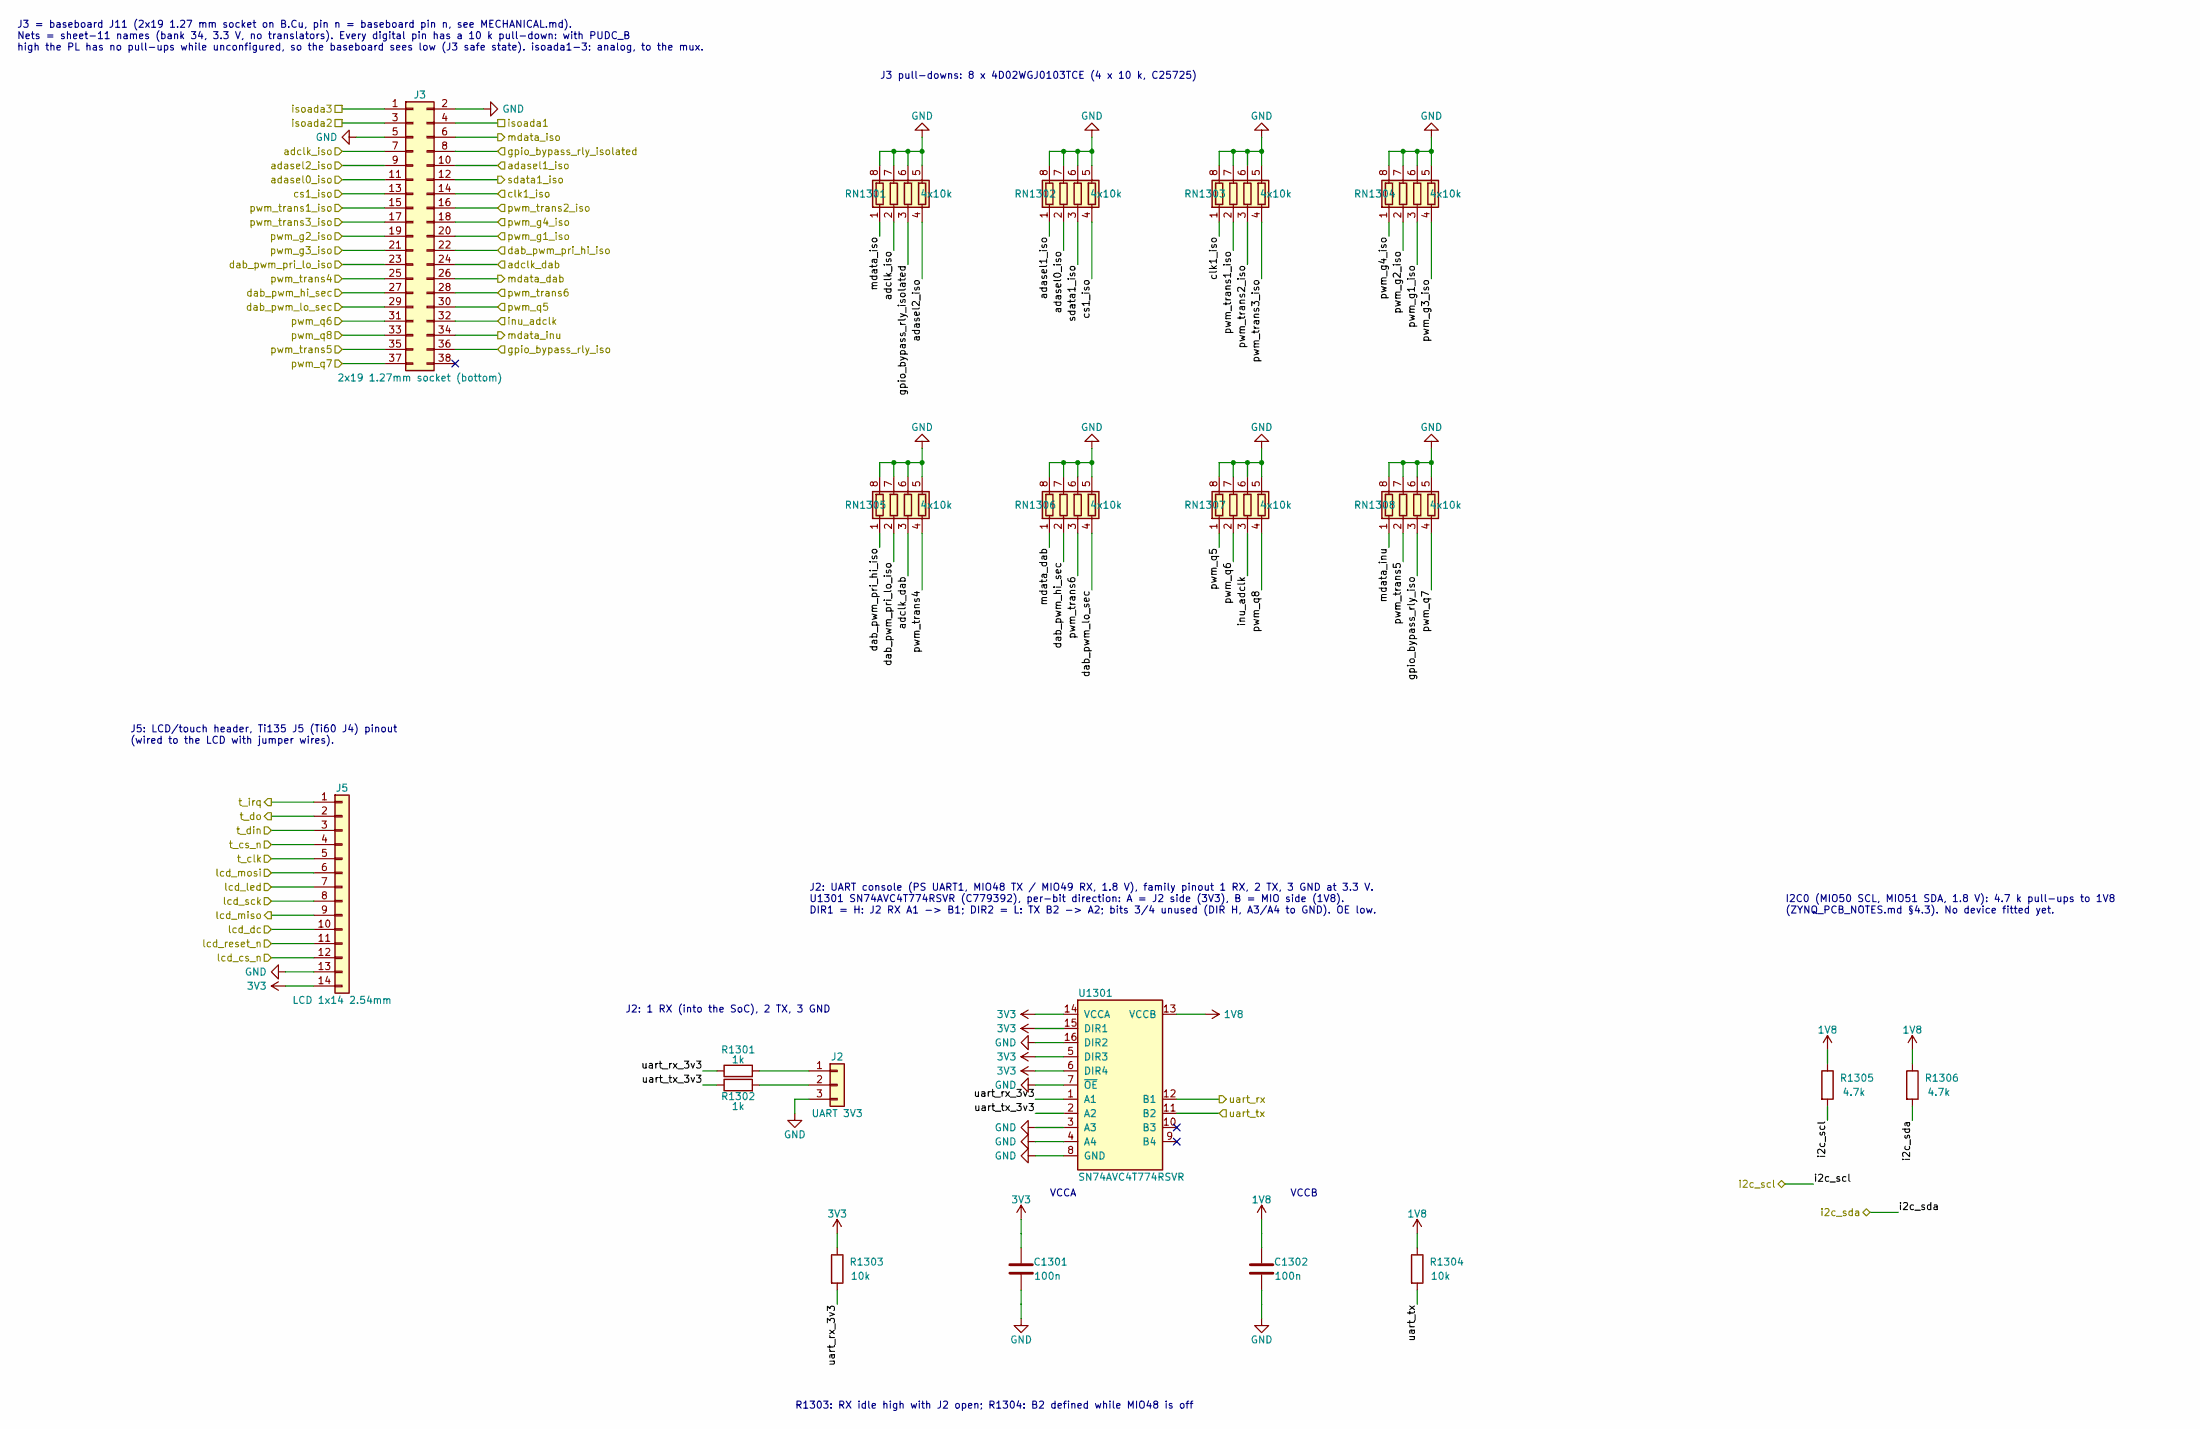
[picture p3: schematic 13_connectors.kicad_sch, Zynq-7000 control card - connectors]

Parts:
C1301, C1302: 100n; C_0402_1005Metric; LCSC C1525
J2: UART 3V3; PinHeader_1x03_P2.54mm_Vertical
J3: 2x19 1.27mm socket (bottom); PinSocket_2x19_P1.27mm_Vertical
J5: LCD 1x14 2.54mm; PinHeader_1x14_P2.54mm_Vertical
R1301, R1302: 1k; R_0402_1005Metric; LCSC C11702
R1303, R1304: 10k; R_0402_1005Metric; LCSC C25744
R1305, R1306: 4.7k; R_0402_1005Metric; LCSC C25900
RN1301, RN1302, RN1303, RN1304, RN1305, RN1306, RN1307, RN1308: 4x10k; R_Array_Convex_4x0402; MPN 4D02WGJ0103TCE; LCSC C25725
U1301: SN74AVC4T774RSVR; UQFN-16_1.8x2.6mm_P0.4mm; MPN SN74AVC4T774RSVR; LCSC C779392

Connections:
1V8: C1302.1, R1304.1, R1305.1, R1306.1, U1301.13 (VCCB); also elsewhere on the board
3V3: C1301.1, J5.14, R1303.1, U1301.5 (DIR3), U1301.6 (DIR4), U1301.14 (VCCA), U1301.15 (DIR1); also elsewhere on the board
/13 connectors/uart_rx_3v3: R1301.1, R1303.2, U1301.1 (A1)
/13 connectors/uart_tx_3v3: R1302.1, U1301.2 (A2)
/adasel0_iso: J3.11, RN1302.2 (R2.1); also elsewhere on the board
/adasel1_iso: J3.10, RN1302.1 (R1.1); also elsewhere on the board
/adasel2_iso: J3.9, RN1301.4 (R4.1); also elsewhere on the board
/adclk_dab: J3.24, RN1305.3 (R3.1); also elsewhere on the board
/adclk_iso: J3.7, RN1301.2 (R2.1); also elsewhere on the board
/clk1_iso: J3.14, RN1303.1 (R1.1); also elsewhere on the board
/cs1_iso: J3.13, RN1302.4 (R4.1); also elsewhere on the board
/dab_pwm_hi_sec: J3.27, RN1306.2 (R2.1); also elsewhere on the board
/dab_pwm_lo_sec: J3.29, RN1306.4 (R4.1); also elsewhere on the board
/dab_pwm_pri_hi_iso: J3.22, RN1305.1 (R1.1); also elsewhere on the board
/dab_pwm_pri_lo_iso: J3.23, RN1305.2 (R2.1); also elsewhere on the board
/gpio_bypass_rly_iso: J3.36, RN1308.3 (R3.1); also elsewhere on the board
/gpio_bypass_rly_isolated: J3.8, RN1301.3 (R3.1); also elsewhere on the board
/i2c_scl: R1305.2; also elsewhere on the board
/i2c_sda: R1306.2; also elsewhere on the board
/inu_adclk: J3.32, RN1307.3 (R3.1); also elsewhere on the board
/isoada1: J3.4; also elsewhere on the board
/isoada2: J3.3; also elsewhere on the board
/isoada3: J3.1; also elsewhere on the board
/lcd_cs_n: J5.12; also elsewhere on the board
/lcd_dc: J5.10; also elsewhere on the board
/lcd_led: J5.7; also elsewhere on the board
/lcd_miso: J5.9; also elsewhere on the board
/lcd_mosi: J5.6; also elsewhere on the board
/lcd_reset_n: J5.11; also elsewhere on the board
/lcd_sck: J5.8; also elsewhere on the board
/mdata_dab: J3.26, RN1306.1 (R1.1); also elsewhere on the board
/mdata_inu: J3.34, RN1308.1 (R1.1); also elsewhere on the board
/mdata_iso: J3.6, RN1301.1 (R1.1); also elsewhere on the board
/pwm_g1_iso: J3.20, RN1304.3 (R3.1); also elsewhere on the board
/pwm_g2_iso: J3.19, RN1304.2 (R2.1); also elsewhere on the board
/pwm_g3_iso: J3.21, RN1304.4 (R4.1); also elsewhere on the board
/pwm_g4_iso: J3.18, RN1304.1 (R1.1); also elsewhere on the board
/pwm_q5: J3.30, RN1307.1 (R1.1); also elsewhere on the board
/pwm_q6: J3.31, RN1307.2 (R2.1); also elsewhere on the board
/pwm_q7: J3.37, RN1308.4 (R4.1); also elsewhere on the board
/pwm_q8: J3.33, RN1307.4 (R4.1); also elsewhere on the board
/pwm_trans1_iso: J3.15, RN1303.2 (R2.1); also elsewhere on the board
/pwm_trans2_iso: J3.16, RN1303.3 (R3.1); also elsewhere on the board
/pwm_trans3_iso: J3.17, RN1303.4 (R4.1); also elsewhere on the board
/pwm_trans4: J3.25, RN1305.4 (R4.1); also elsewhere on the board
/pwm_trans5: J3.35, RN1308.2 (R2.1); also elsewhere on the board
/pwm_trans6: J3.28, RN1306.3 (R3.1); also elsewhere on the board
/sdata1_iso: J3.12, RN1302.3 (R3.1); also elsewhere on the board
/t_clk: J5.5; also elsewhere on the board
/t_cs_n: J5.4; also elsewhere on the board
/t_din: J5.3; also elsewhere on the board
/t_do: J5.2; also elsewhere on the board
/t_irq: J5.1; also elsewhere on the board
/uart_rx: U1301.12 (B1); also elsewhere on the board
/uart_tx: R1304.2, U1301.11 (B2); also elsewhere on the board
GND: C1301.2, C1302.2, J2.3, J3.2, J3.5, J5.13, RN1301.5 (R4.2), RN1301.6 (R3.2), RN1301.7 (R2.2), RN1301.8 (R1.2), RN1302.5 (R4.2), RN1302.6 (R3.2), RN1302.7 (R2.2), RN1302.8 (R1.2), RN1303.5 (R4.2), RN1303.6 (R3.2), RN1303.7 (R2.2), RN1303.8 (R1.2), RN1304.5 (R4.2), RN1304.6 (R3.2), RN1304.7 (R2.2), RN1304.8 (R1.2), RN1305.5 (R4.2), RN1305.6 (R3.2), RN1305.7 (R2.2), RN1305.8 (R1.2), RN1306.5 (R4.2), RN1306.6 (R3.2), RN1306.7 (R2.2), RN1306.8 (R1.2), RN1307.5 (R4.2), RN1307.6 (R3.2), RN1307.7 (R2.2), RN1307.8 (R1.2), RN1308.5 (R4.2), RN1308.6 (R3.2), RN1308.7 (R2.2), RN1308.8 (R1.2), U1301.3 (A3), U1301.4 (A4), U1301.7 (~OE), U1301.8 (GND), U1301.16 (DIR2); also elsewhere on the board
unnamed: J2.1, R1301.2
unnamed: J2.2, R1302.2

Notes on the sheet:
J3 = baseboard J11 (2x19 1.27 mm socket on B.Cu, pin n = baseboard pin n, see MECHANICAL.md). Nets = sheet-11 names (bank 34, 3.3 V, no translators). Every digital pin has a 10 k pull-down: with PUDC_B high the PL has no pull-ups while unconfigured, so the baseboard sees low (J3 safe state). isoada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
J3 pull-downs: 8 x 4D02WGJ0103TCE (4 x 10 k, C25725)
J5: LCD/touch header, Ti135 J5 (Ti60 J4) pinout (wired to the LCD with jumper wires).
J2: UART console (PS UART1, MIO48 TX / MIO49 RX, 1.8 V), family pinout 1 RX, 2 TX, 3 GND at 3.3 V. U1301 SN74AVC4T774RSVR (C779392), per-bit direction: A = J2 side (3V3), B = MIO side (1V8). DIR1 = H: J2 RX A1 -> B1; DIR2 = L: TX B2 -> A2; bits 3/4 unused (DIR H, A3/A4 to GND). OE low.
VCCA
VCCB
J2: 1 RX (into the SoC), 2 TX, 3 GND
R1303: RX idle high with J2 open; R1304: B2 defined while MIO48 is off
I2C0 (MIO50 SCL, MIO51 SDA, 1.8 V): 4.7 k pull-ups to 1V8 (ZYNQ_PCB_NOTES.md §4.3). No device fitted yet.

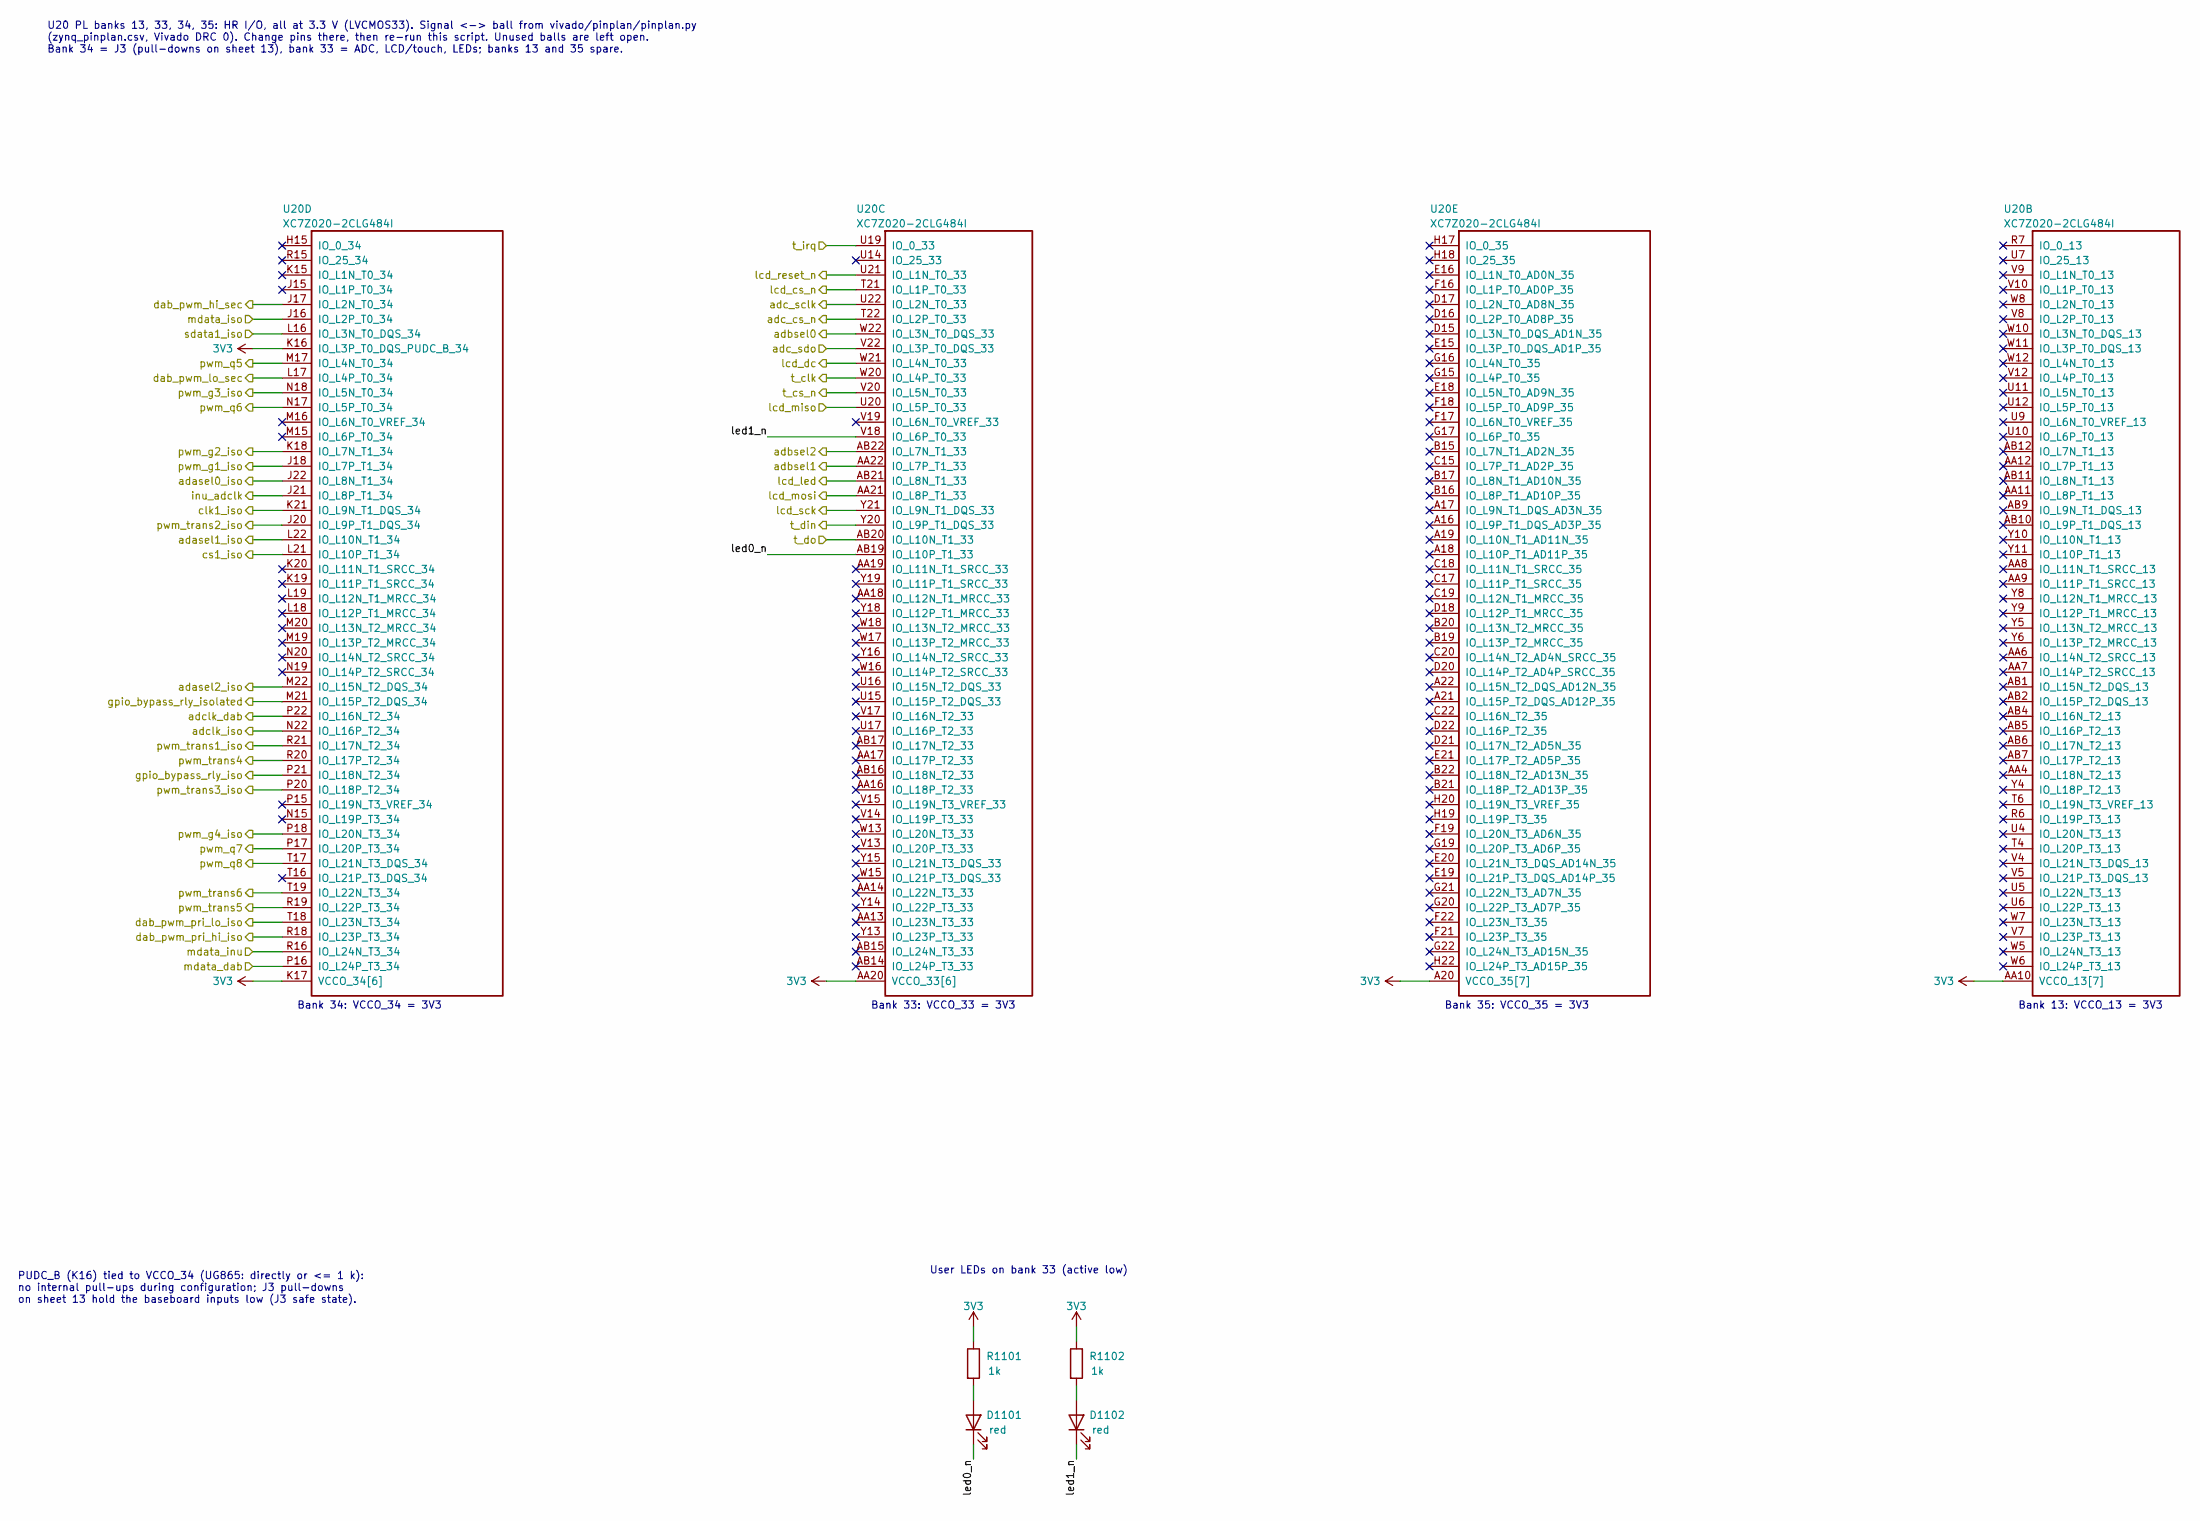
[picture p4: schematic 11_soc_pl.kicad_sch, Zynq-7000 control card - soc_pl]

Parts:
D1101, D1102: red; LED_0603_1608Metric; MPN KT-0603R; LCSC C2286
R1101, R1102: 1k; R_0402_1005Metric; LCSC C11702
U20: XC7Z020-2CLG484I; BGA-484_19.0x19.0mm_Layout22x22_P0.80mm_dia0.40mm; MPN XC7Z020-2CLG484I; LCSC C157624

Connections:
3V3: R1101.1, R1102.1, U20.A20 (VCCO_35[7]), U20.AA10 (VCCO_13[7]), U20.AA20 (VCCO_33[6]), U20.AB3 (VCCO_13[7]), U20.AB13 (VCCO_33[6]), U20.C16 (VCCO_35[7]), U20.D19 (VCCO_35[7]), U20.E22 (VCCO_35[7]), U20.F15 (VCCO_35[7]), U20.G18 (VCCO_35[7]), U20.H21 (VCCO_35[7]), U20.K16 (IO_L3P_T0_DQS_PUDC_B_34), U20.K17 (VCCO_34[6]), U20.L20 (VCCO_34[6]), U20.N16 (VCCO_34[6]), U20.P19 (VCCO_34[6]), U20.R22 (VCCO_34[6]), U20.T5 (VCCO_13[7]), U20.T15 (VCCO_34[6]), U20.U8 (VCCO_13[7]), U20.U18 (VCCO_33[6]), U20.V11 (VCCO_13[7]), U20.V21 (VCCO_33[6]), U20.W4 (VCCO_13[7]), U20.W14 (VCCO_33[6]), U20.Y7 (VCCO_13[7]), U20.Y17 (VCCO_33[6]); also elsewhere on the board
/11 soc_pl/led0_n: D1101.1 (K), U20.AB19 (IO_L10P_T1_33)
/11 soc_pl/led1_n: D1102.1 (K), U20.V18 (IO_L6P_T0_33)
/adasel0_iso: U20.J22 (IO_L8N_T1_34); also elsewhere on the board
/adasel1_iso: U20.L22 (IO_L10N_T1_34); also elsewhere on the board
/adasel2_iso: U20.M22 (IO_L15N_T2_DQS_34); also elsewhere on the board
/adbsel0: U20.W22 (IO_L3N_T0_DQS_33); also elsewhere on the board
/adbsel1: U20.AA22 (IO_L7P_T1_33); also elsewhere on the board
/adbsel2: U20.AB22 (IO_L7N_T1_33); also elsewhere on the board
/adc_cs_n: U20.T22 (IO_L2P_T0_33); also elsewhere on the board
/adc_sclk: U20.U22 (IO_L2N_T0_33); also elsewhere on the board
/adc_sdo: U20.V22 (IO_L3P_T0_DQS_33); also elsewhere on the board
/adclk_dab: U20.P22 (IO_L16N_T2_34); also elsewhere on the board
/adclk_iso: U20.N22 (IO_L16P_T2_34); also elsewhere on the board
/clk1_iso: U20.K21 (IO_L9N_T1_DQS_34); also elsewhere on the board
/cs1_iso: U20.L21 (IO_L10P_T1_34); also elsewhere on the board
/dab_pwm_hi_sec: U20.J17 (IO_L2N_T0_34); also elsewhere on the board
/dab_pwm_lo_sec: U20.L17 (IO_L4P_T0_34); also elsewhere on the board
/dab_pwm_pri_hi_iso: U20.R18 (IO_L23P_T3_34); also elsewhere on the board
/dab_pwm_pri_lo_iso: U20.T18 (IO_L23N_T3_34); also elsewhere on the board
/gpio_bypass_rly_iso: U20.P21 (IO_L18N_T2_34); also elsewhere on the board
/gpio_bypass_rly_isolated: U20.M21 (IO_L15P_T2_DQS_34); also elsewhere on the board
/inu_adclk: U20.J21 (IO_L8P_T1_34); also elsewhere on the board
/lcd_cs_n: U20.T21 (IO_L1P_T0_33); also elsewhere on the board
/lcd_dc: U20.W21 (IO_L4N_T0_33); also elsewhere on the board
/lcd_led: U20.AB21 (IO_L8N_T1_33); also elsewhere on the board
/lcd_miso: U20.U20 (IO_L5P_T0_33); also elsewhere on the board
/lcd_mosi: U20.AA21 (IO_L8P_T1_33); also elsewhere on the board
/lcd_reset_n: U20.U21 (IO_L1N_T0_33); also elsewhere on the board
/lcd_sck: U20.Y21 (IO_L9N_T1_DQS_33); also elsewhere on the board
/mdata_dab: U20.P16 (IO_L24P_T3_34); also elsewhere on the board
/mdata_inu: U20.R16 (IO_L24N_T3_34); also elsewhere on the board
/mdata_iso: U20.J16 (IO_L2P_T0_34); also elsewhere on the board
/pwm_g1_iso: U20.J18 (IO_L7P_T1_34); also elsewhere on the board
/pwm_g2_iso: U20.K18 (IO_L7N_T1_34); also elsewhere on the board
/pwm_g3_iso: U20.N18 (IO_L5N_T0_34); also elsewhere on the board
/pwm_g4_iso: U20.P18 (IO_L20N_T3_34); also elsewhere on the board
/pwm_q5: U20.M17 (IO_L4N_T0_34); also elsewhere on the board
/pwm_q6: U20.N17 (IO_L5P_T0_34); also elsewhere on the board
/pwm_q7: U20.P17 (IO_L20P_T3_34); also elsewhere on the board
/pwm_q8: U20.T17 (IO_L21N_T3_DQS_34); also elsewhere on the board
/pwm_trans1_iso: U20.R21 (IO_L17N_T2_34); also elsewhere on the board
/pwm_trans2_iso: U20.J20 (IO_L9P_T1_DQS_34); also elsewhere on the board
/pwm_trans3_iso: U20.P20 (IO_L18P_T2_34); also elsewhere on the board
/pwm_trans4: U20.R20 (IO_L17P_T2_34); also elsewhere on the board
/pwm_trans5: U20.R19 (IO_L22P_T3_34); also elsewhere on the board
/pwm_trans6: U20.T19 (IO_L22N_T3_34); also elsewhere on the board
/sdata1_iso: U20.L16 (IO_L3N_T0_DQS_34); also elsewhere on the board
/t_clk: U20.W20 (IO_L4P_T0_33); also elsewhere on the board
/t_cs_n: U20.V20 (IO_L5N_T0_33); also elsewhere on the board
/t_din: U20.Y20 (IO_L9P_T1_DQS_33); also elsewhere on the board
/t_do: U20.AB20 (IO_L10N_T1_33); also elsewhere on the board
/t_irq: U20.U19 (IO_0_33); also elsewhere on the board
unnamed: D1101.2 (A), R1101.2
unnamed: D1102.2 (A), R1102.2

Notes on the sheet:
U20 PL banks 13, 33, 34, 35: HR I/O, all at 3.3 V (LVCMOS33). Signal <-> ball from vivado/pinplan/pinplan.py (zynq_pinplan.csv, Vivado DRC 0). Change pins there, then re-run this script. Unused balls are left open. Bank 34 = J3 (pull-downs on sheet 13), bank 33 = ADC, LCD/touch, LEDs; banks 13 and 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
Bank 34: VCCO_34 = 3V3
Bank 33: VCCO_33 = 3V3
Bank 35: VCCO_35 = 3V3
Bank 13: VCCO_13 = 3V3
PUDC_B (K16) tied to VCCO_34 (UG865: directly or <= 1 k): no internal pull-ups during configuration; J3 pull-downs on sheet 13 hold the baseboard inputs low (J3 safe state).
User LEDs on bank 33 (active low)

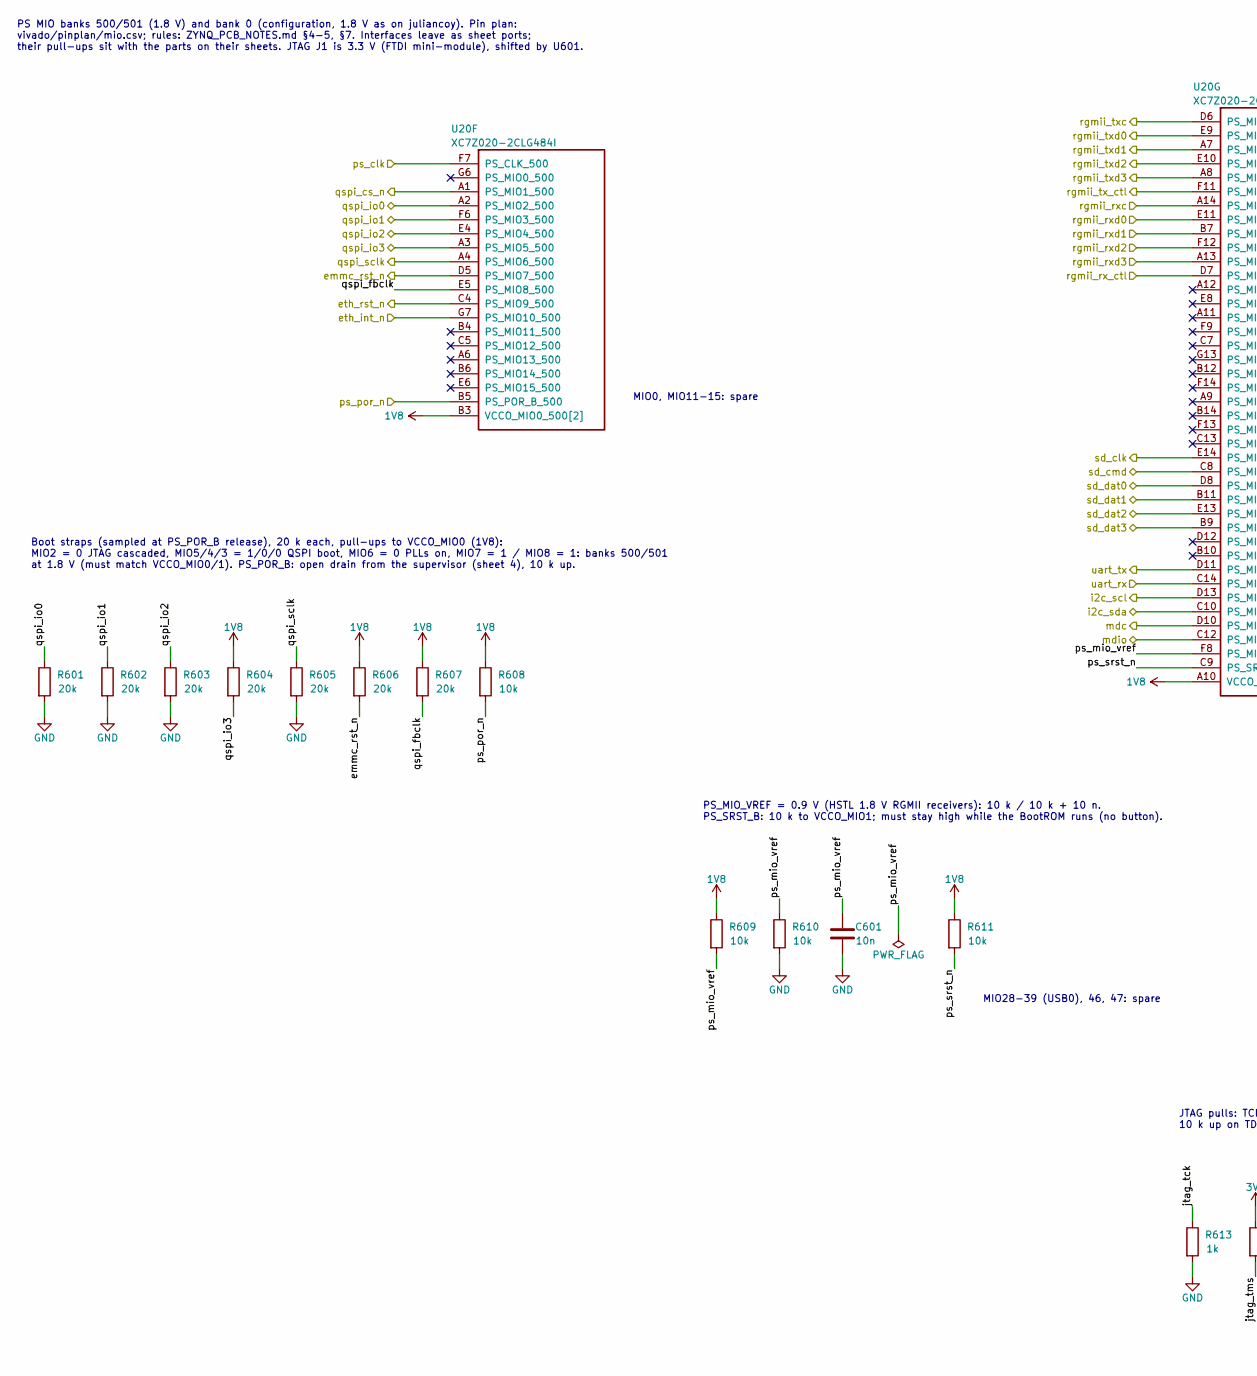
[picture p5: schematic 06_soc_config.kicad_sch, Zynq-7000 control card - soc_config, part in row 1, column 1]

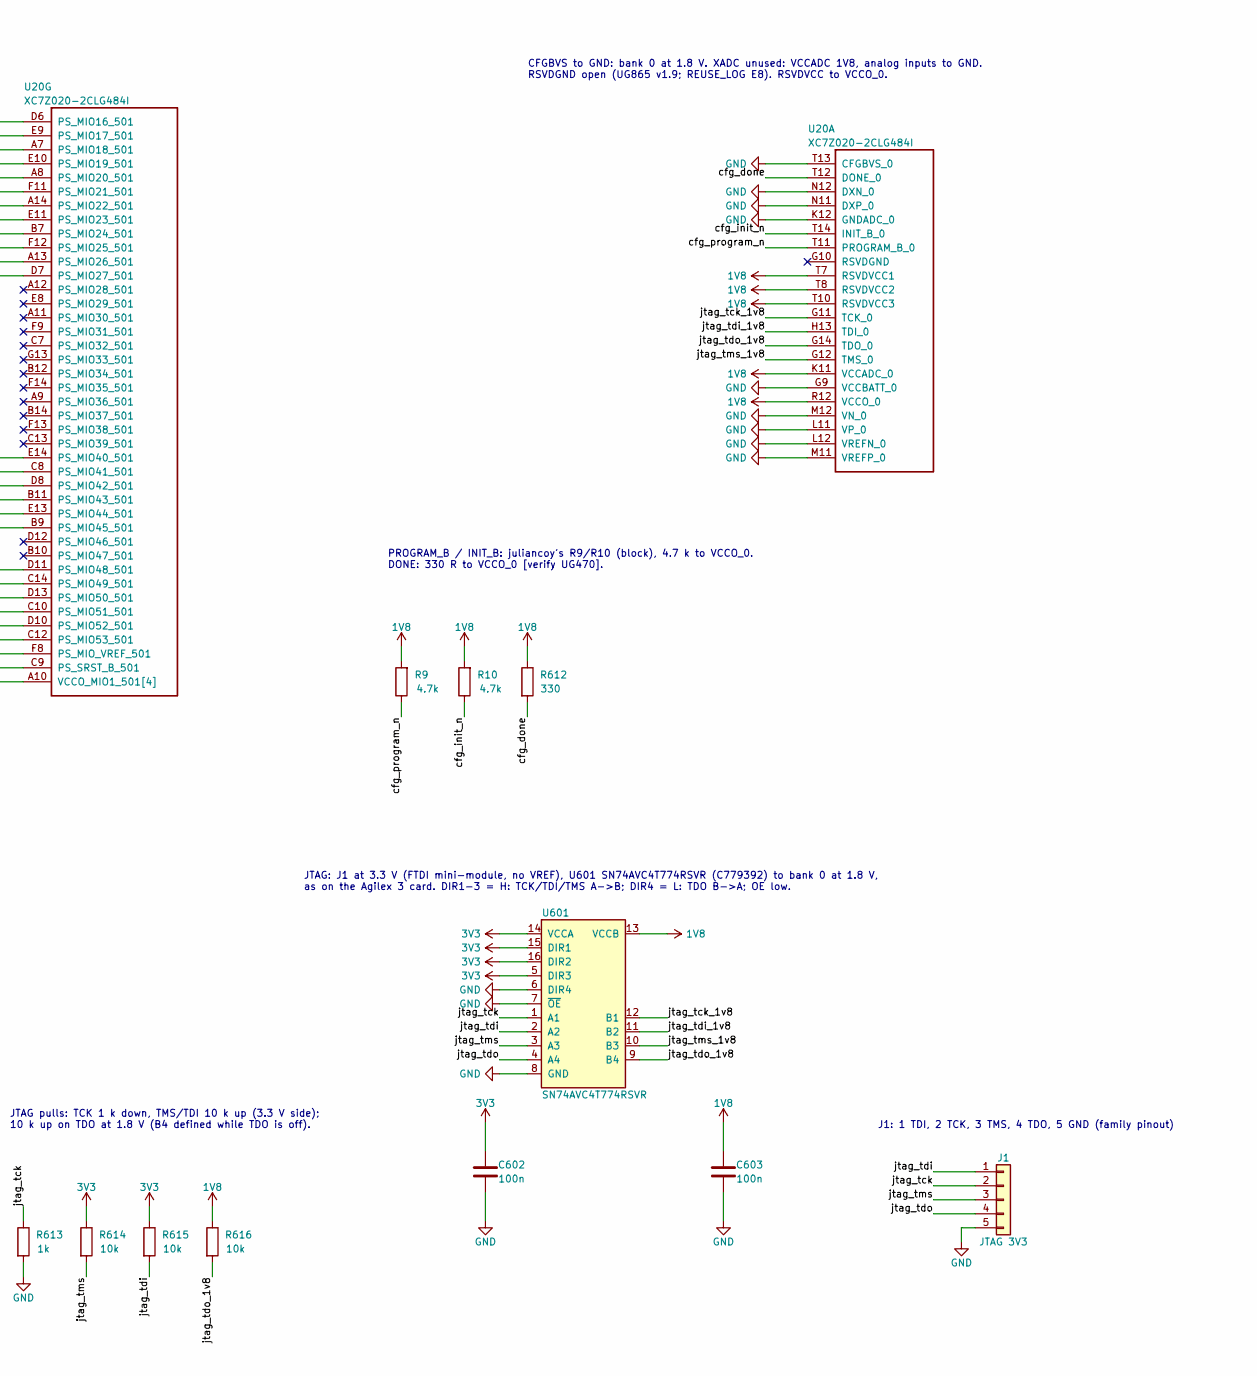
[picture p6: schematic 06_soc_config.kicad_sch, Zynq-7000 control card - soc_config, part in row 1, column 2]

Parts:
C601: 10n; C_0402_1005Metric; LCSC C15195
C602, C603: 100n; C_0402_1005Metric; LCSC C1525
J1: JTAG 3V3; PinHeader_1x05_P2.54mm_Vertical
R9, R10: 4.7k; R_0402_1005Metric; LCSC C25900
R601, R602, R603, R604, R605, R606, R607: 20k; R_0402_1005Metric; LCSC C25765
R608, R609, R610, R611, R614, R615, R616: 10k; R_0402_1005Metric; LCSC C25744
R612: 330; R_0402_1005Metric; LCSC C25104
R613: 1k; R_0402_1005Metric; LCSC C11702
U20: XC7Z020-2CLG484I
U601: SN74AVC4T774RSVR; UQFN-16_1.8x2.6mm_P0.4mm; MPN SN74AVC4T774RSVR; LCSC C779392

Connections:
1V8: C603.1, R9.2, R10.2, R604.1, R606.1, R607.1, R608.1, R609.1, R611.1, R612.1, R616.1, U20.A10 (VCCO_MIO1_501[4]), U20.B3 (VCCO_MIO0_500[2]), U20.B13 (VCCO_MIO1_501[4]), U20.C6 (VCCO_MIO0_500[2]), U20.D9 (VCCO_MIO1_501[4]), U20.E12 (VCCO_MIO1_501[4]), U20.K11 (VCCADC_0), U20.R12 (VCCO_0), U20.T7 (RSVDVCC1), U20.T8 (RSVDVCC2), U20.T10 (RSVDVCC3), U601.13 (VCCB); also elsewhere on the board
3V3: C602.1, R614.1, R615.1, U601.5 (DIR3), U601.14 (VCCA), U601.15 (DIR1), U601.16 (DIR2); also elsewhere on the board
/06 soc_config/cfg_done: R612.2, U20.T12 (DONE_0)
/06 soc_config/cfg_init_n: R10.1, U20.T14 (INIT_B_0)
/06 soc_config/cfg_program_n: R9.1, U20.T11 (PROGRAM_B_0)
/06 soc_config/jtag_tck: J1.2, R613.1, U601.1 (A1)
/06 soc_config/jtag_tck_1v8: U20.G11 (TCK_0), U601.12 (B1)
/06 soc_config/jtag_tdi: J1.1, R615.2, U601.2 (A2)
/06 soc_config/jtag_tdi_1v8: U20.H13 (TDI_0), U601.11 (B2)
/06 soc_config/jtag_tdo: J1.4, U601.4 (A4)
/06 soc_config/jtag_tdo_1v8: R616.2, U20.G14 (TDO_0), U601.9 (B4)
/06 soc_config/jtag_tms: J1.3, R614.2, U601.3 (A3)
/06 soc_config/jtag_tms_1v8: U20.G12 (TMS_0), U601.10 (B3)
/06 soc_config/ps_mio_vref: C601.1, R609.2, R610.1, U20.F8 (PS_MIO_VREF_501)
/06 soc_config/ps_srst_n: R611.2, U20.C9 (PS_SRST_B_501)
/06 soc_config/qspi_fbclk: R607.2, U20.E5 (PS_MIO8_500)
/emmc_rst_n: R606.2, U20.D5 (PS_MIO7_500); also elsewhere on the board
/eth_int_n: U20.G7 (PS_MIO10_500); also elsewhere on the board
/eth_rst_n: U20.C4 (PS_MIO9_500); also elsewhere on the board
/i2c_scl: U20.D13 (PS_MIO50_501); also elsewhere on the board
/i2c_sda: U20.C10 (PS_MIO51_501); also elsewhere on the board
/mdc: U20.D10 (PS_MIO52_501); also elsewhere on the board
/mdio: U20.C12 (PS_MIO53_501); also elsewhere on the board
/ps_clk: U20.F7 (PS_CLK_500); also elsewhere on the board
/ps_por_n: R608.2, U20.B5 (PS_POR_B_500); also elsewhere on the board
/qspi_cs_n: U20.A1 (PS_MIO1_500); also elsewhere on the board
/qspi_io0: R601.1, U20.A2 (PS_MIO2_500); also elsewhere on the board
/qspi_io1: R602.1, U20.F6 (PS_MIO3_500); also elsewhere on the board
/qspi_io2: R603.1, U20.E4 (PS_MIO4_500); also elsewhere on the board
/qspi_io3: R604.2, U20.A3 (PS_MIO5_500); also elsewhere on the board
/qspi_sclk: R605.1, U20.A4 (PS_MIO6_500); also elsewhere on the board
/rgmii_rx_ctl: U20.D7 (PS_MIO27_501); also elsewhere on the board
/rgmii_rxc: U20.A14 (PS_MIO22_501); also elsewhere on the board
/rgmii_rxd0: U20.E11 (PS_MIO23_501); also elsewhere on the board
/rgmii_rxd1: U20.B7 (PS_MIO24_501); also elsewhere on the board
/rgmii_rxd2: U20.F12 (PS_MIO25_501); also elsewhere on the board
/rgmii_rxd3: U20.A13 (PS_MIO26_501); also elsewhere on the board
/rgmii_tx_ctl: U20.F11 (PS_MIO21_501); also elsewhere on the board
/rgmii_txc: U20.D6 (PS_MIO16_501); also elsewhere on the board
/rgmii_txd0: U20.E9 (PS_MIO17_501); also elsewhere on the board
/rgmii_txd1: U20.A7 (PS_MIO18_501); also elsewhere on the board
/rgmii_txd2: U20.E10 (PS_MIO19_501); also elsewhere on the board
/rgmii_txd3: U20.A8 (PS_MIO20_501); also elsewhere on the board
/sd_clk: U20.E14 (PS_MIO40_501); also elsewhere on the board
/sd_cmd: U20.C8 (PS_MIO41_501); also elsewhere on the board
/sd_dat0: U20.D8 (PS_MIO42_501); also elsewhere on the board
/sd_dat1: U20.B11 (PS_MIO43_501); also elsewhere on the board
/sd_dat2: U20.E13 (PS_MIO44_501); also elsewhere on the board
/sd_dat3: U20.B9 (PS_MIO45_501); also elsewhere on the board
/uart_rx: U20.C14 (PS_MIO49_501); also elsewhere on the board
/uart_tx: U20.D11 (PS_MIO48_501); also elsewhere on the board
GND: C601.2, C602.2, C603.2, J1.5, R601.2, R602.2, R603.2, R605.2, R610.2, R613.2, U20.G9 (VCCBATT_0), U20.K12 (GNDADC_0), U20.L11 (VP_0), U20.L12 (VREFN_0), U20.M11 (VREFP_0), U20.M12 (VN_0), U20.N11 (DXP_0), U20.N12 (DXN_0), U20.T13 (CFGBVS_0), U601.6 (DIR4), U601.7 (~OE), U601.8 (GND); also elsewhere on the board

Notes on the sheet:
PS MIO banks 500/501 (1.8 V) and bank 0 (configuration, 1.8 V as on juliancoy). Pin plan: vivado/pinplan/mio.csv; rules: ZYNQ_PCB_NOTES.md §4-5, §7. Interfaces leave as sheet ports; their pull-ups sit with the parts on their sheets. JTAG J1 is 3.3 V (FTDI mini-module), shifted by U601.
MIO0, MIO11-15: spare
Boot straps (sampled at PS_POR_B release), 20 k each, pull-ups to VCCO_MIO0 (1V8): MIO2 = 0 JTAG cascaded, MIO5/4/3 = 1/0/0 QSPI boot, MIO6 = 0 PLLs on, MIO7 = 1 / MIO8 = 1: banks 500/501 at 1.8 V (must match VCCO_MIO0/1). PS_POR_B: open drain from the supervisor (sheet 4), 10 k up.
MIO28-39 (USB0), 46, 47: spare
PS_MIO_VREF = 0.9 V (HSTL 1.8 V RGMII receivers): 10 k / 10 k + 10 n. PS_SRST_B: 10 k to VCCO_MIO1; must stay high while the BootROM runs (no button).
CFGBVS to GND: bank 0 at 1.8 V. XADC unused: VCCADC 1V8, analog inputs to GND. RSVDGND open (UG865 v1.9; REUSE_LOG E8). RSVDVCC to VCCO_0.
PROGRAM_B / INIT_B: juliancoy's R9/R10 (block), 4.7 k to VCCO_0. DONE: 330 R to VCCO_0 [verify UG470].
JTAG: J1 at 3.3 V (FTDI mini-module, no VREF), U601 SN74AVC4T774RSVR (C779392) to bank 0 at 1.8 V, as on the Agilex 3 card. DIR1-3 = H: TCK/TDI/TMS A->B; DIR4 = L: TDO B->A; OE low.
JTAG pulls: TCK 1 k down, TMS/TDI 10 k up (3.3 V side); 10 k up on TDO at 1.8 V (B4 defined while TDO is off).
J1: 1 TDI, 2 TCK, 3 TMS, 4 TDO, 5 GND (family pinout)
