johonkanen/ac_psu_zynq_kicad/kicad/zynq_card.kicad_pcb

## KiCad design kicad/zynq_card.kicad_pcb (continued)

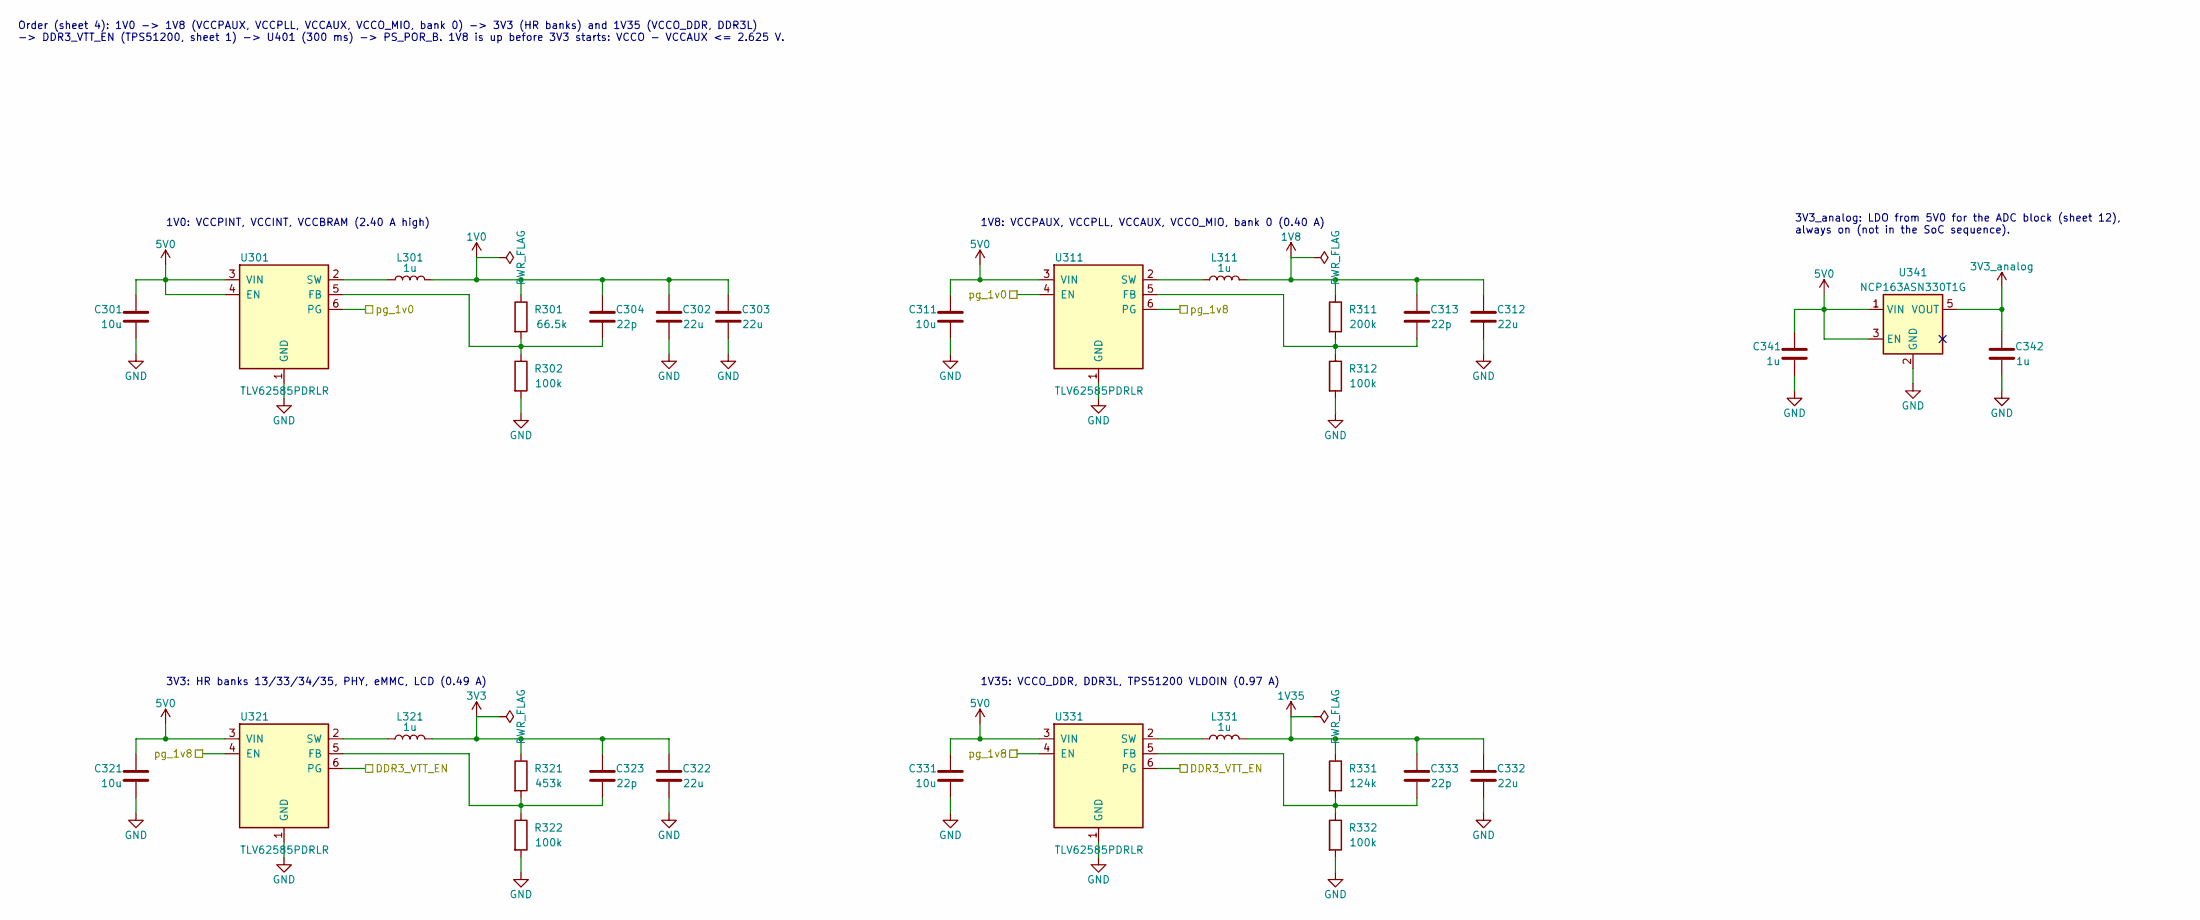
[picture p7: schematic 03_pwr_rails.kicad_sch, Zynq-7000 control card - pwr_rails]

Parts:
C301, C311, C321, C331: 10u; C_0805_2012Metric; LCSC C15850
C302, C303, C312, C322, C332: 22u; C_0805_2012Metric; LCSC C45783
C304, C313, C323, C333: 22p; C_0402_1005Metric; LCSC C1555
C341, C342: 1u; C_0402_1005Metric; LCSC C52923
L301, L311, L321, L331: 1u; L_Coilcraft_XxL4020; MPN WPN4020H1R0MT; LCSC C98359
R301: 66.5k; R_0402_1005Metric; LCSC C2998095
R302, R312, R322, R332: 100k; R_0402_1005Metric; LCSC C25741
R311: 200k; R_0402_1005Metric; LCSC C25764
R321: 453k; R_0402_1005Metric; LCSC C27009
R331: 124k; R_0402_1005Metric; LCSC C2933070
U301, U311, U321, U331: TLV62585PDRLR; SOT-563; LCSC C485118
U341: NCP163ASN330T1G; SOT-23-5; LCSC C603656

Connections:
1V0: C302.1, C303.1, C304.1, L301.2, R301.1; also elsewhere on the board
1V8: C312.1, C313.1, L311.2, R311.1; also elsewhere on the board
1V35: C332.1, C333.1, L331.2, R331.1; also elsewhere on the board
3V3: C322.1, C323.1, L321.2, R321.1; also elsewhere on the board
3V3_analog: C342.1, U341.5 (VOUT); also elsewhere on the board
5V0: C301.1, C311.1, C321.1, C331.1, C341.1, U301.3 (VIN), U301.4 (EN), U311.3 (VIN), U321.3 (VIN), U331.3 (VIN), U341.1 (VIN), U341.3 (EN); also elsewhere on the board
/DDR3_VTT_EN: U321.6 (PG), U331.6 (PG); also elsewhere on the board
/pg_1v0: U301.6 (PG), U311.4 (EN); also elsewhere on the board
/pg_1v8: U311.6 (PG), U321.4 (EN), U331.4 (EN); also elsewhere on the board
GND: C301.2, C302.2, C303.2, C311.2, C312.2, C321.2, C322.2, C331.2, C332.2, C341.2, C342.2, R302.2, R312.2, R322.2, R332.2, U301.1 (GND), U311.1 (GND), U321.1 (GND), U331.1 (GND), U341.2 (GND); also elsewhere on the board
unnamed: C304.2, R301.2, R302.1, U301.5 (FB)
unnamed: L301.1, U301.2 (SW)
unnamed: C313.2, R311.2, R312.1, U311.5 (FB)
unnamed: L311.1, U311.2 (SW)
unnamed: C323.2, R321.2, R322.1, U321.5 (FB)
unnamed: L321.1, U321.2 (SW)
unnamed: C333.2, R331.2, R332.1, U331.5 (FB)
unnamed: L331.1, U331.2 (SW)

Notes on the sheet:
Order (sheet 4): 1V0 -> 1V8 (VCCPAUX, VCCPLL, VCCAUX, VCCO_MIO, bank 0) -> 3V3 (HR banks) and 1V35 (VCCO_DDR, DDR3L) -> DDR3_VTT_EN (TPS51200, sheet 1) -> U401 (300 ms) -> PS_POR_B. 1V8 is up before 3V3 starts: VCCO - VCCAUX <= 2.625 V.
1V0: VCCPINT, VCCINT, VCCBRAM (2.40 A high)
1V8: VCCPAUX, VCCPLL, VCCAUX, VCCO_MIO, bank 0 (0.40 A)
3V3: HR banks 13/33/34/35, PHY, eMMC, LCD (0.49 A)
1V35: VCCO_DDR, DDR3L, TPS51200 VLDOIN (0.97 A)
3V3_analog: LDO from 5V0 for the ADC block (sheet 12), always on (not in the SoC sequence).

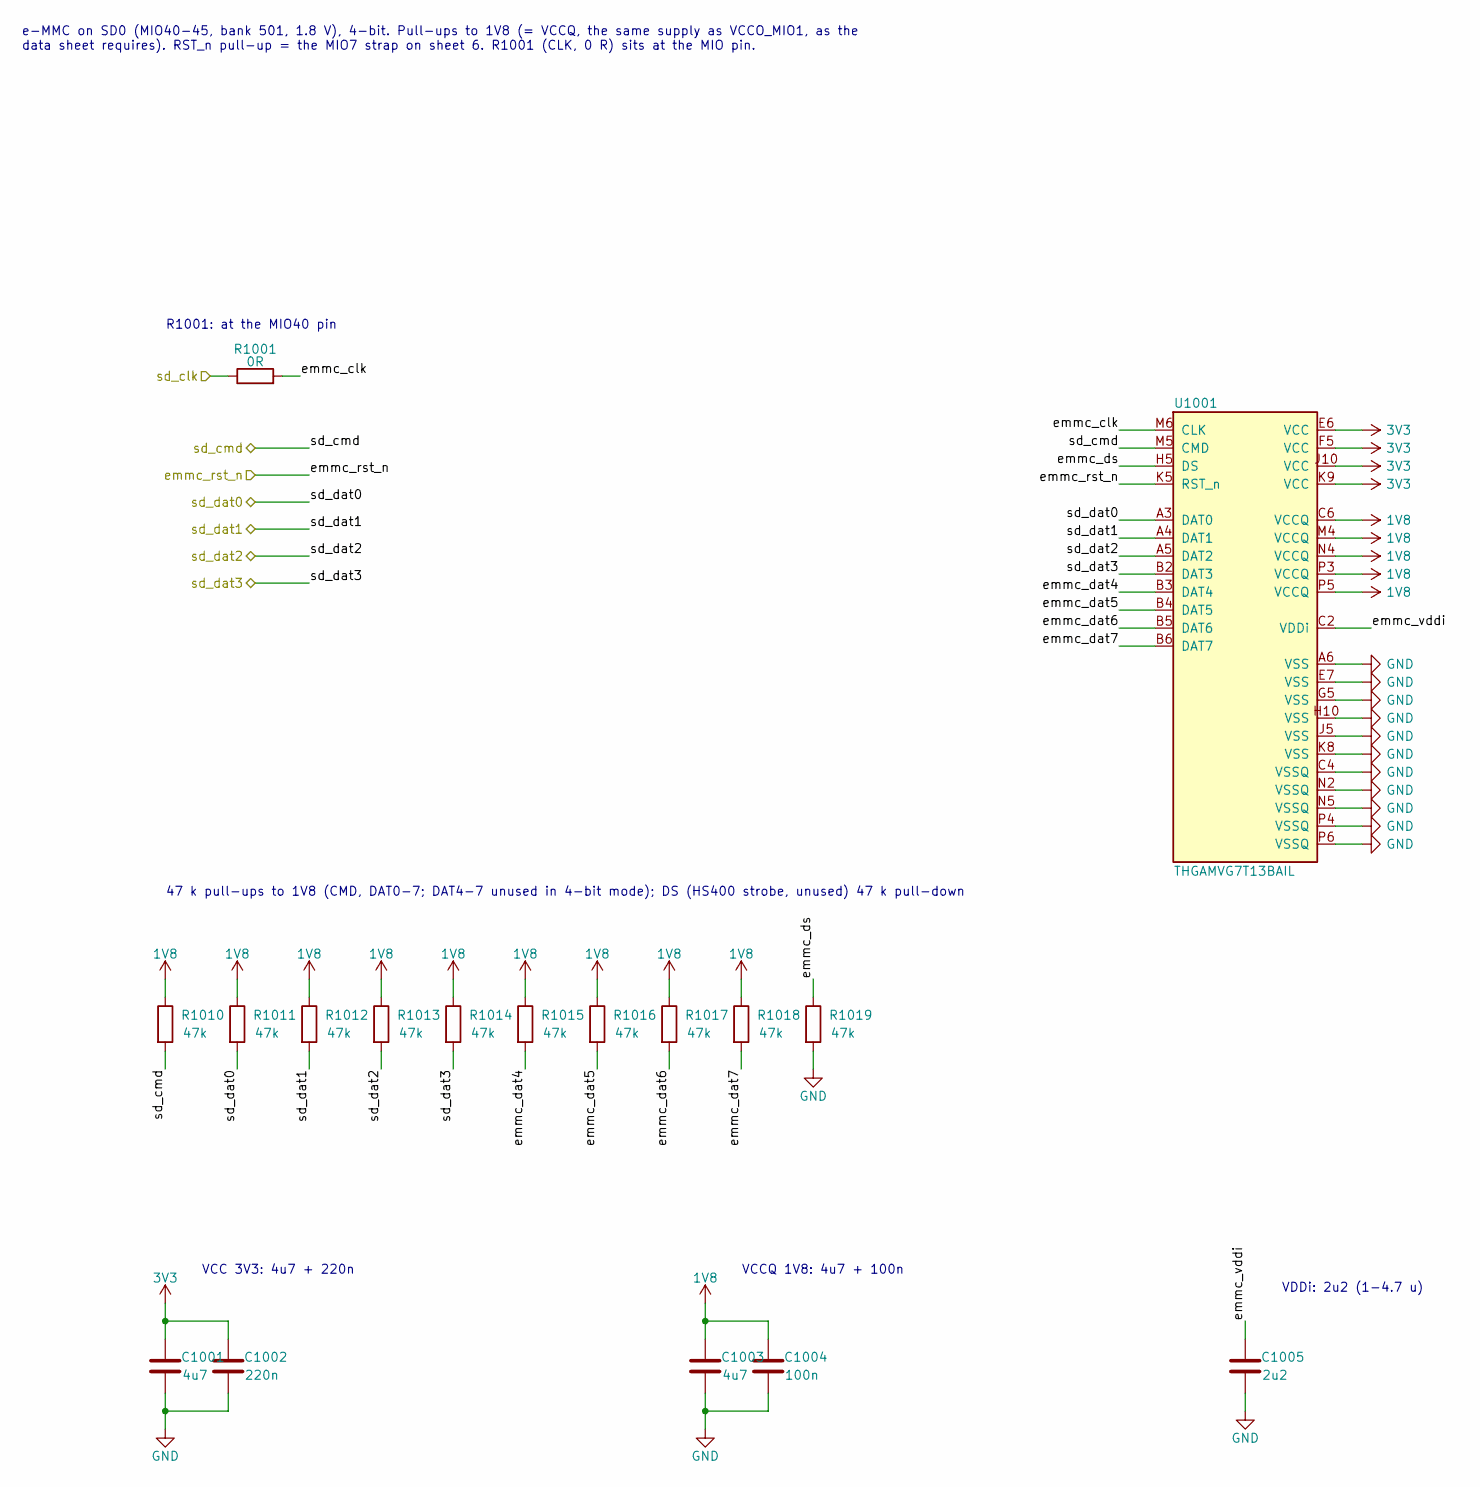
[picture p8: schematic 10_emmc.kicad_sch, Zynq-7000 control card - emmc]

Parts:
C1001, C1003: 4u7; C_0402_1005Metric; LCSC C23733
C1002: 220n; C_0402_1005Metric; LCSC C16772
C1004: 100n; C_0402_1005Metric; LCSC C1525
C1005: 2u2; C_0402_1005Metric; LCSC C12530
R1001: 0R; R_0402_1005Metric; LCSC C17168
R1010, R1011, R1012, R1013, R1014, R1015, R1016, R1017, R1018, R1019: 47k; R_0402_1005Metric; LCSC C25792
U1001: THGAMVG7T13BAIL; LFBGA-153_11.5x13mm_Layout14x14_P0.5mm; LCSC C7599693

Connections:
1V8: C1003.1, C1004.1, R1010.1, R1011.1, R1012.1, R1013.1, R1014.1, R1015.1, R1016.1, R1017.1, R1018.1, U1001.C6 (VCCQ), U1001.M4 (VCCQ), U1001.N4 (VCCQ), U1001.P3 (VCCQ), U1001.P5 (VCCQ); also elsewhere on the board
3V3: C1001.1, C1002.1, U1001.E6 (VCC), U1001.F5 (VCC), U1001.J10 (VCC), U1001.K9 (VCC); also elsewhere on the board
/10 emmc/emmc_clk: R1001.2, U1001.M6 (CLK)
/10 emmc/emmc_dat4: R1015.2, U1001.B3 (DAT4)
/10 emmc/emmc_dat5: R1016.2, U1001.B4 (DAT5)
/10 emmc/emmc_dat6: R1017.2, U1001.B5 (DAT6)
/10 emmc/emmc_dat7: R1018.2, U1001.B6 (DAT7)
/10 emmc/emmc_ds: R1019.1, U1001.H5 (DS)
/10 emmc/emmc_vddi: C1005.1, U1001.C2 (VDDi)
/emmc_rst_n: U1001.K5 (RST_n); also elsewhere on the board
/sd_clk: R1001.1; also elsewhere on the board
/sd_cmd: R1010.2, U1001.M5 (CMD); also elsewhere on the board
/sd_dat0: R1011.2, U1001.A3 (DAT0); also elsewhere on the board
/sd_dat1: R1012.2, U1001.A4 (DAT1); also elsewhere on the board
/sd_dat2: R1013.2, U1001.A5 (DAT2); also elsewhere on the board
/sd_dat3: R1014.2, U1001.B2 (DAT3); also elsewhere on the board
GND: C1001.2, C1002.2, C1003.2, C1004.2, C1005.2, R1019.2, U1001.A6 (VSS), U1001.C4 (VSSQ), U1001.E7 (VSS), U1001.G5 (VSS), U1001.H10 (VSS), U1001.J5 (VSS), U1001.K8 (VSS), U1001.N2 (VSSQ), U1001.N5 (VSSQ), U1001.P4 (VSSQ), U1001.P6 (VSSQ); also elsewhere on the board

Notes on the sheet:
e-MMC on SD0 (MIO40-45, bank 501, 1.8 V), 4-bit. Pull-ups to 1V8 (= VCCQ, the same supply as VCCO_MIO1, as the data sheet requires). RST_n pull-up = the MIO7 strap on sheet 6. R1001 (CLK, 0 R) sits at the MIO pin.
R1001: at the MIO40 pin
47 k pull-ups to 1V8 (CMD, DAT0-7; DAT4-7 unused in 4-bit mode); DS (HS400 strobe, unused) 47 k pull-down
VCC 3V3: 4u7 + 220n
VCCQ 1V8: 4u7 + 100n
VDDi: 2u2 (1-4.7 u)

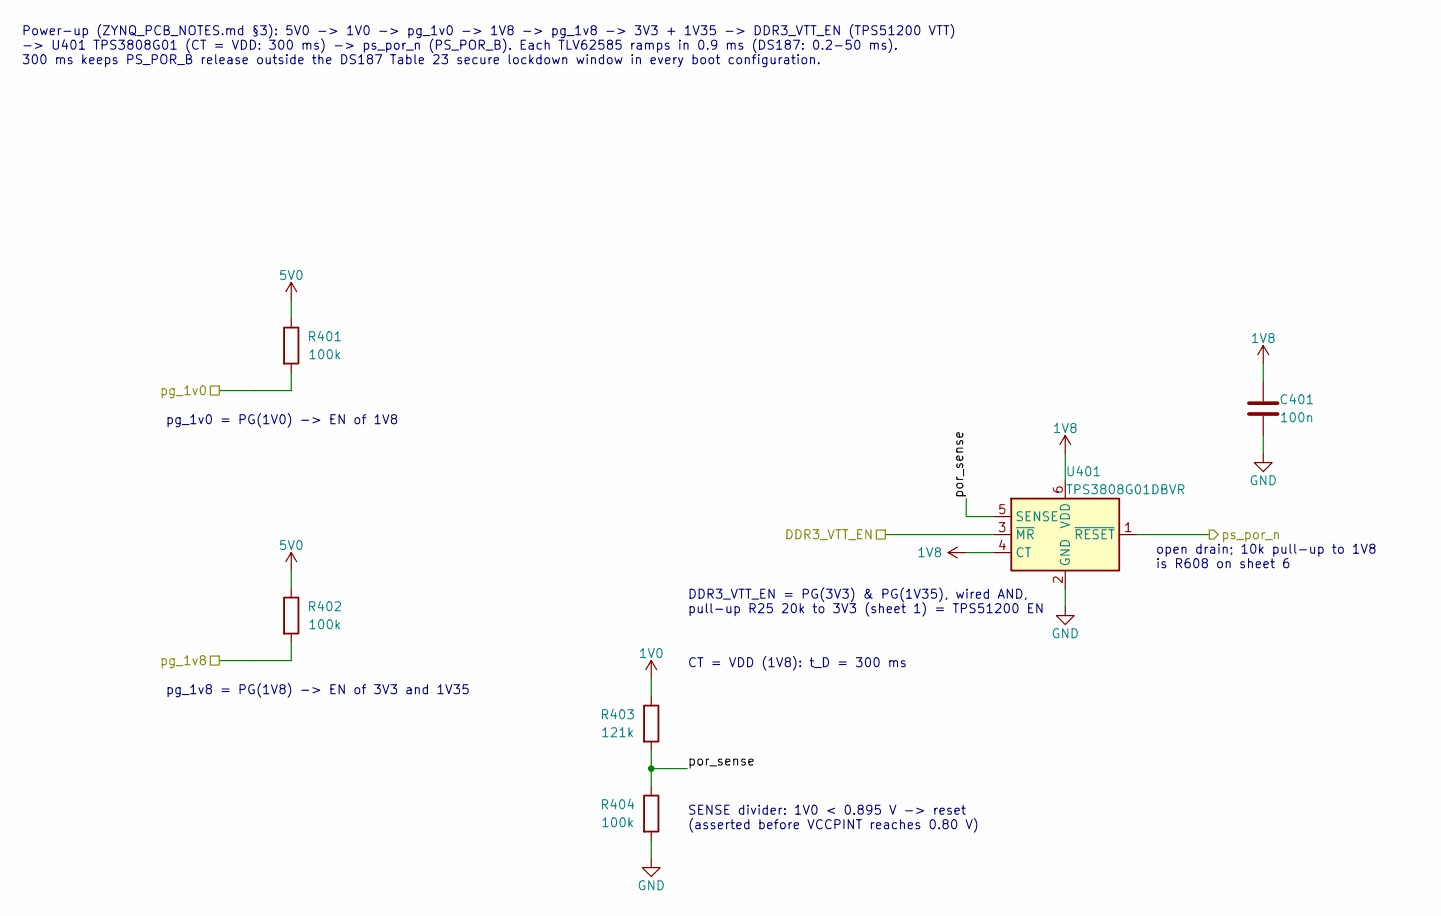
[picture p9: schematic 04_pwr_seq.kicad_sch, Zynq-7000 control card - pwr_seq]

Parts:
C401: 100n; C_0402_1005Metric; LCSC C1525
R401, R402, R404: 100k; R_0402_1005Metric; LCSC C25741
R403: 121k; R_0402_1005Metric; LCSC C11693
U401: TPS3808G01DBVR; SOT-23-6; MPN TPS3808G01DBVR; LCSC C19653

Connections:
1V0: R403.1; also elsewhere on the board
1V8: C401.1, U401.4 (CT), U401.6 (VDD); also elsewhere on the board
5V0: R401.1, R402.1; also elsewhere on the board
/04 pwr_seq/por_sense: R403.2, R404.1, U401.5 (SENSE)
/DDR3_VTT_EN: U401.3 (~MR); also elsewhere on the board
/pg_1v0: R401.2; also elsewhere on the board
/pg_1v8: R402.2; also elsewhere on the board
/ps_por_n: U401.1 (~RESET); also elsewhere on the board
GND: C401.2, R404.2, U401.2 (GND); also elsewhere on the board

Notes on the sheet:
Power-up (ZYNQ_PCB_NOTES.md §3): 5V0 -> 1V0 -> pg_1v0 -> 1V8 -> pg_1v8 -> 3V3 + 1V35 -> DDR3_VTT_EN (TPS51200 VTT) -> U401 TPS3808G01 (CT = VDD: 300 ms) -> ps_por_n (PS_POR_B). Each TLV62585 ramps in 0.9 ms (DS187: 0.2-50 ms). 300 ms keeps PS_POR_B release outside the DS187 Table 23 secure lockdown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
pg_1v0 = PG(1V0) -> EN of 1V8
pg_1v8 = PG(1V8) -> EN of 3V3 and 1V35
DDR3_VTT_EN = PG(3V3) & PG(1V35), wired AND, pull-up R25 20k to 3V3 (sheet 1) = TPS51200 EN
CT = VDD (1V8): t_D = 300 ms
SENSE divider: 1V0 < 0.895 V -> reset (asserted before VCCPINT reaches 0.80 V)
open drain; 10k pull-up to 1V8 is R608 on sheet 6

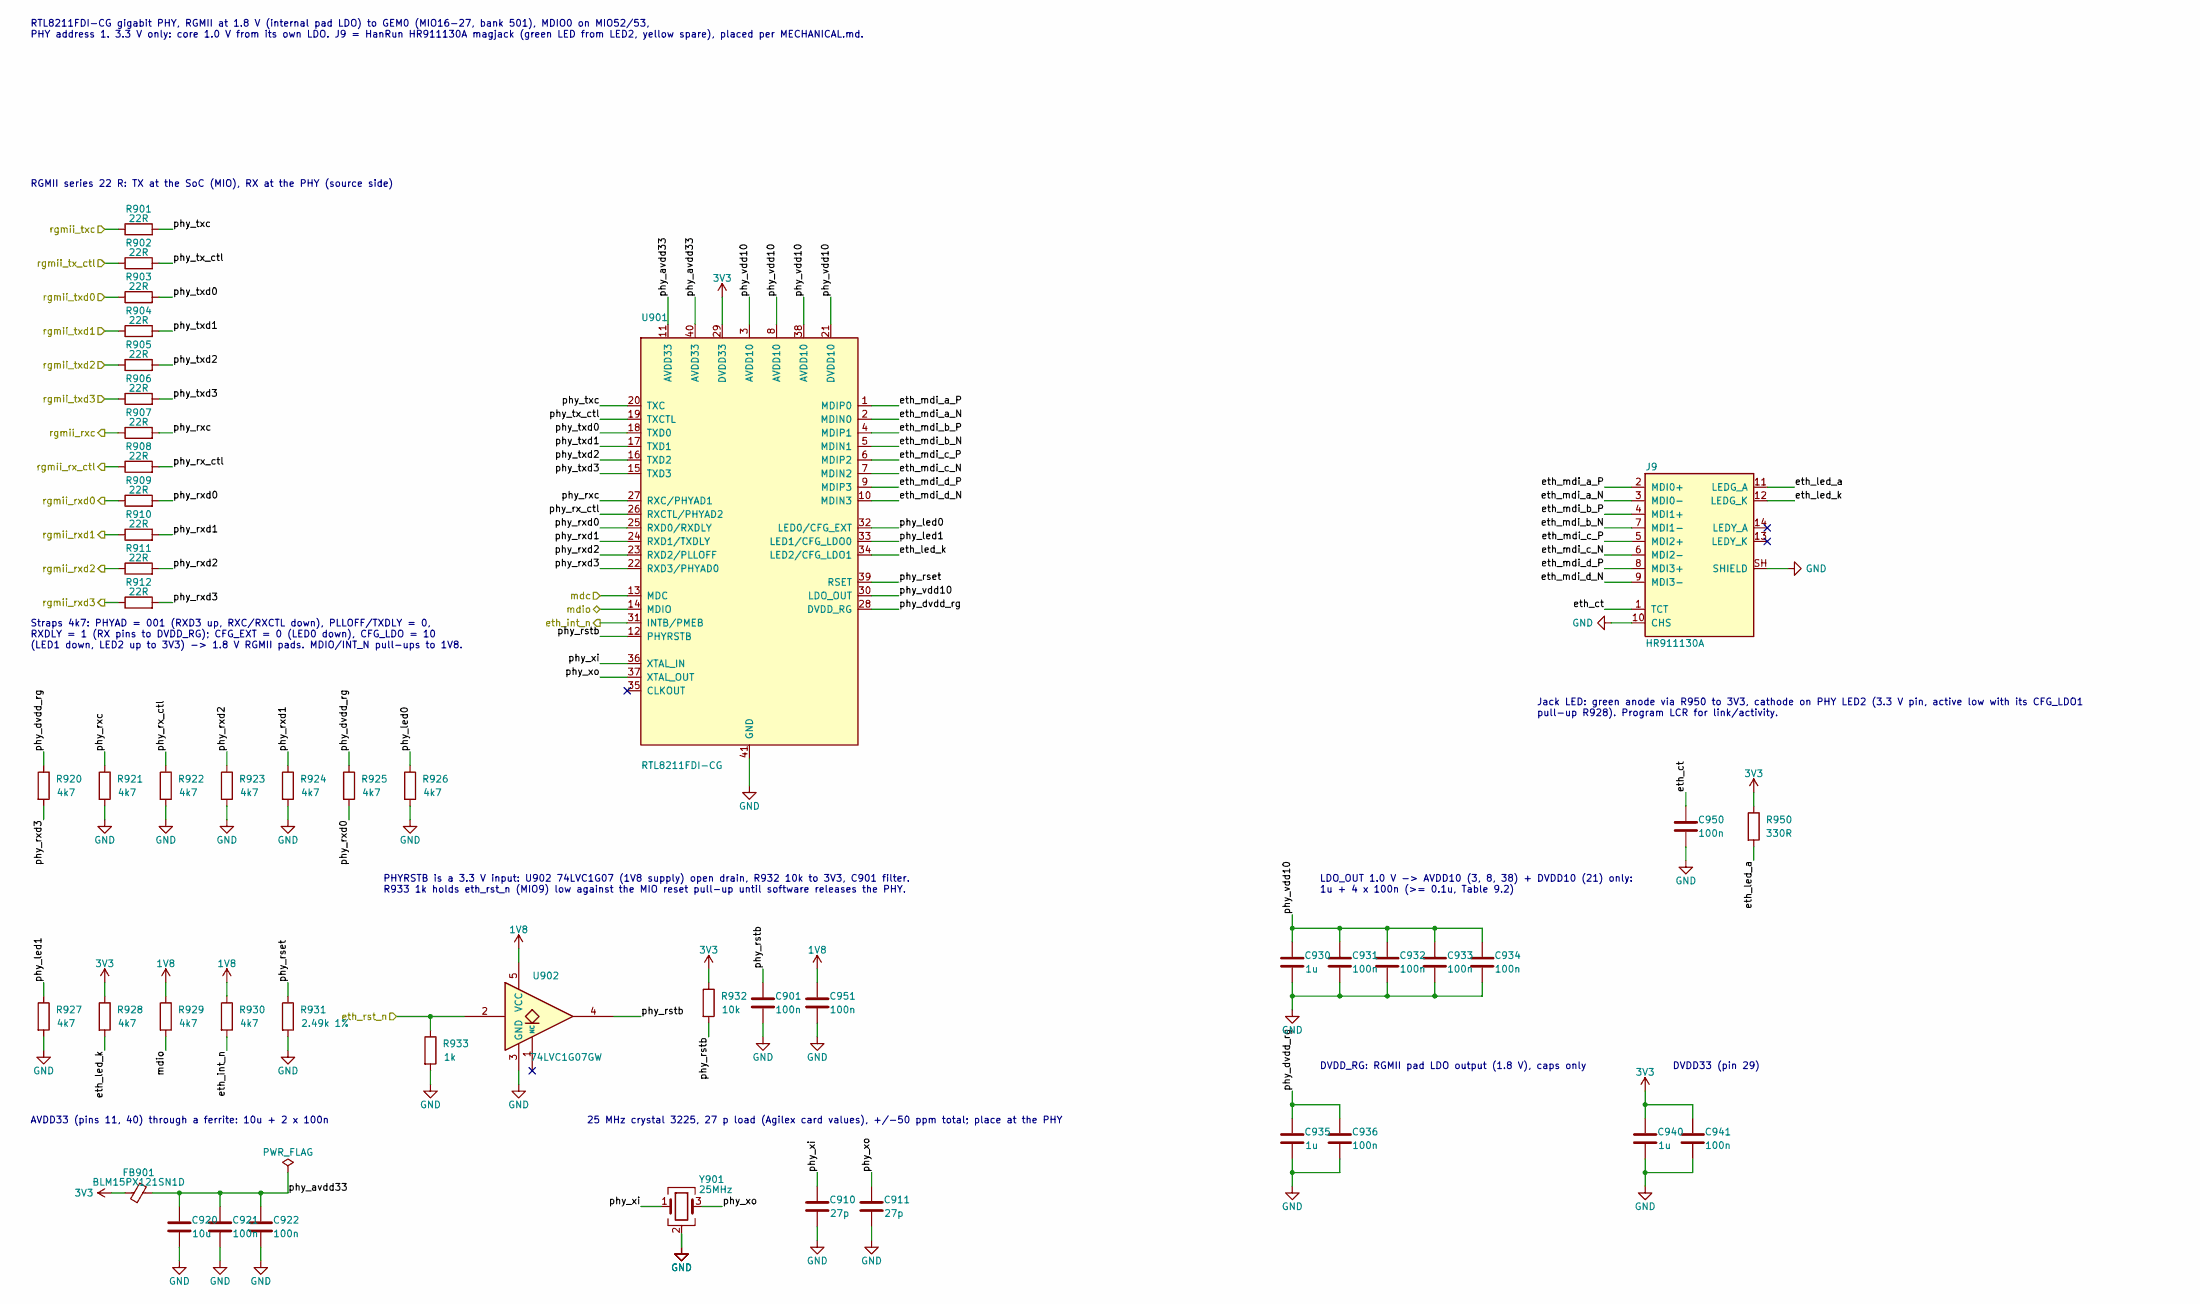
[picture p10: schematic 09_ethernet.kicad_sch, Zynq-7000 control card - ethernet]

Parts:
C901, C921, C922, C931, C932, C933, C934, C936, C941, C950, C951: 100n; C_0402_1005Metric; LCSC C1525
C910, C911: 27p; C_0402_1005Metric; LCSC C107002
C920: 10u; C_0805_2012Metric; LCSC C15850
C930, C935, C940: 1u; C_0402_1005Metric; LCSC C52923
FB901: BLM15PX121SN1D; L_0402_1005Metric; LCSC C88970
J9: HR911130A; RJ45_Hanrun_HR911130A_Horizontal; LCSC C54408
R901, R902, R903, R904, R905, R906, R907, R908, R909, R910, R911, R912: 22R; R_0402_1005Metric; LCSC C25092
R920, R921, R922, R923, R924, R925, R926, R927, R928, R929, R930: 4k7; R_0402_1005Metric; LCSC C25900
R931: 2.49k 1%; R_0402_1005Metric; LCSC C25884
R932: 10k; R_0402_1005Metric; LCSC C25744
R933: 1k; R_0402_1005Metric; LCSC C11702
R950: 330R; R_0402_1005Metric; LCSC C25104
U901: RTL8211FDI-CG; QFN-40-1EP_5x5mm_P0.4mm_EP3.6x3.6mm_ThermalVias; LCSC C692886
U902: 74LVC1G07GW; SOT-353_SC-70-5; LCSC C282345
Y901: 25MHz; Crystal_SMD_3225-4Pin_3.2x2.5mm; MPN X322525MRB4SI; LCSC C70593

Connections:
1V8: C951.1, R929.1, R930.1, U902.5 (VCC); also elsewhere on the board
3V3: C940.1, C941.1, FB901.1, R928.1, R932.1, R950.1, U901.29 (DVDD33); also elsewhere on the board
/09 ethernet/eth_ct: C950.1, J9.1 (TCT)
/09 ethernet/eth_led_a: J9.11 (LEDG_A), R950.2
/09 ethernet/eth_led_k: J9.12 (LEDG_K), R928.2, U901.34 (LED2/CFG_LDO1)
/09 ethernet/eth_mdi_a_N: J9.3 (MDI0-), U901.2 (MDIN0)
/09 ethernet/eth_mdi_a_P: J9.2 (MDI0+), U901.1 (MDIP0)
/09 ethernet/eth_mdi_b_N: J9.7 (MDI1-), U901.5 (MDIN1)
/09 ethernet/eth_mdi_b_P: J9.4 (MDI1+), U901.4 (MDIP1)
/09 ethernet/eth_mdi_c_N: J9.6 (MDI2-), U901.7 (MDIN2)
/09 ethernet/eth_mdi_c_P: J9.5 (MDI2+), U901.6 (MDIP2)
/09 ethernet/eth_mdi_d_N: J9.9 (MDI3-), U901.10 (MDIN3)
/09 ethernet/eth_mdi_d_P: J9.8 (MDI3+), U901.9 (MDIP3)
/09 ethernet/phy_avdd33: C920.1, C921.1, C922.1, FB901.2, U901.11 (AVDD33), U901.40 (AVDD33)
/09 ethernet/phy_dvdd_rg: C935.1, C936.1, R920.1, R925.1, U901.28 (DVDD_RG)
/09 ethernet/phy_led0: R926.1, U901.32 (LED0/CFG_EXT)
/09 ethernet/phy_led1: R927.1, U901.33 (LED1/CFG_LDO0)
/09 ethernet/phy_rset: R931.1, U901.39 (RSET)
/09 ethernet/phy_rstb: C901.1, R932.2, U901.12 (PHYRSTB), U902.4
/09 ethernet/phy_rx_ctl: R908.2, R922.1, U901.26 (RXCTL/PHYAD2)
/09 ethernet/phy_rxc: R907.2, R921.1, U901.27 (RXC/PHYAD1)
/09 ethernet/phy_rxd0: R909.2, R925.2, U901.25 (RXD0/RXDLY)
/09 ethernet/phy_rxd1: R910.2, R924.1, U901.24 (RXD1/TXDLY)
/09 ethernet/phy_rxd2: R911.2, R923.1, U901.23 (RXD2/PLLOFF)
/09 ethernet/phy_rxd3: R912.2, R920.2, U901.22 (RXD3/PHYAD0)
/09 ethernet/phy_tx_ctl: R902.2, U901.19 (TXCTL)
/09 ethernet/phy_txc: R901.2, U901.20 (TXC)
/09 ethernet/phy_txd0: R903.2, U901.18 (TXD0)
/09 ethernet/phy_txd1: R904.2, U901.17 (TXD1)
/09 ethernet/phy_txd2: R905.2, U901.16 (TXD2)
/09 ethernet/phy_txd3: R906.2, U901.15 (TXD3)
/09 ethernet/phy_vdd10: C930.1, C931.1, C932.1, C933.1, C934.1, U901.3 (AVDD10), U901.8 (AVDD10), U901.21 (DVDD10), U901.30 (LDO_OUT), U901.38 (AVDD10)
/09 ethernet/phy_xi: C910.1, U901.36 (XTAL_IN), Y901.1
/09 ethernet/phy_xo: C911.1, U901.37 (XTAL_OUT), Y901.3
/eth_int_n: R930.2, U901.31 (INTB/PMEB); also elsewhere on the board
/eth_rst_n: R933.1, U902.2; also elsewhere on the board
/mdc: U901.13 (MDC); also elsewhere on the board
/mdio: R929.2, U901.14 (MDIO); also elsewhere on the board
/rgmii_rx_ctl: R908.1; also elsewhere on the board
/rgmii_rxc: R907.1; also elsewhere on the board
/rgmii_rxd0: R909.1; also elsewhere on the board
/rgmii_rxd1: R910.1; also elsewhere on the board
/rgmii_rxd2: R911.1; also elsewhere on the board
/rgmii_rxd3: R912.1; also elsewhere on the board
/rgmii_tx_ctl: R902.1; also elsewhere on the board
/rgmii_txc: R901.1; also elsewhere on the board
/rgmii_txd0: R903.1; also elsewhere on the board
/rgmii_txd1: R904.1; also elsewhere on the board
/rgmii_txd2: R905.1; also elsewhere on the board
/rgmii_txd3: R906.1; also elsewhere on the board
GND: C901.2, C910.2, C911.2, C920.2, C921.2, C922.2, C930.2, C931.2, C932.2, C933.2, C934.2, C935.2, C936.2, C940.2, C941.2, C950.2, C951.2, J9.10 (CHS), J9.SH (SHIELD), R921.2, R922.2, R923.2, R924.2, R926.2, R927.2, R931.2, R933.2, U901.41 (GND), U902.3 (GND), Y901.2 (G), Y901.4 (G); also elsewhere on the board

Notes on the sheet:
RTL8211FDI-CG gigabit PHY, RGMII at 1.8 V (internal pad LDO) to GEM0 (MIO16-27, bank 501), MDIO0 on MIO52/53, PHY address 1. 3.3 V only: core 1.0 V from its own LDO. J9 = HanRun HR911130A magjack (green LED from LED2, yellow spare), placed per MECHANICAL.md.
RGMII series 22 R: TX at the SoC (MIO), RX at the PHY (source side)
Straps 4k7: PHYAD = 001 (RXD3 up, RXC/RXCTL down), PLLOFF/TXDLY = 0, RXDLY = 1 (RX pins to DVDD_RG); CFG_EXT = 0 (LED0 down), CFG_LDO = 10 (LED1 down, LED2 up to 3V3) -> 1.8 V RGMII pads. MDIO/INT_N pull-ups to 1V8.
PHYRSTB is a 3.3 V input: U902 74LVC1G07 (1V8 supply) open drain, R932 10k to 3V3, C901 filter. R933 1k holds eth_rst_n (MIO9) low against the MIO reset pull-up until software releases the PHY.
25 MHz crystal 3225, 27 p load (Agilex card values), +/-50 ppm total; place at the PHY
AVDD33 (pins 11, 40) through a ferrite: 10u + 2 x 100n
LDO_OUT 1.0 V -> AVDD10 (3, 8, 38) + DVDD10 (21) only: 1u + 4 x 100n (>= 0.1u, Table 9.2)
DVDD_RG: RGMII pad LDO output (1.8 V), caps only
DVDD33 (pin 29)
Jack LED: green anode via R950 to 3V3, cathode on PHY LED2 (3.3 V pin, active low with its CFG_LDO1 pull-up R928). Program LCR for link/activity.

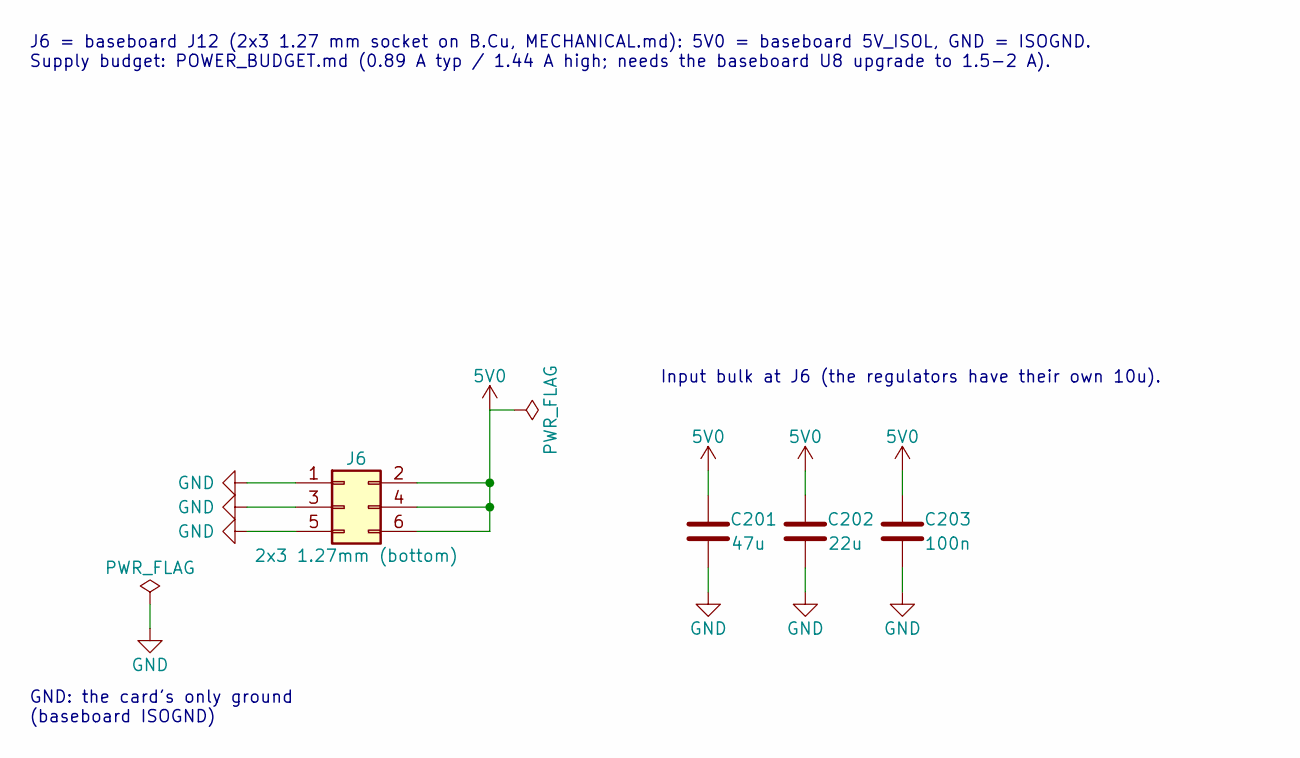
[picture p11: schematic 02_pwr_input.kicad_sch, Zynq-7000 control card - pwr_input]

Parts:
C201: 47u; C_1206_3216Metric; LCSC C96123
C202: 22u; C_0805_2012Metric; LCSC C45783
C203: 100n; C_0402_1005Metric; LCSC C1525
J6: 2x3 1.27mm (bottom); PinSocket_2x03_P1.27mm_Vertical

Connections:
5V0: C201.1, C202.1, C203.1, J6.2, J6.4, J6.6; also elsewhere on the board
GND: C201.2, C202.2, C203.2, J6.1, J6.3, J6.5; also elsewhere on the board

Notes on the sheet:
J6 = baseboard J12 (2x3 1.27 mm socket on B.Cu, MECHANICAL.md): 5V0 = baseboard 5V_ISOL, GND = ISOGND. Supply budget: POWER_BUDGET.md (0.89 A typ / 1.44 A high; needs the baseboard U8 upgrade to 1.5-2 A).
GND: the card's only ground (baseboard ISOGND)
Input bulk at J6 (the regulators have their own 10u).

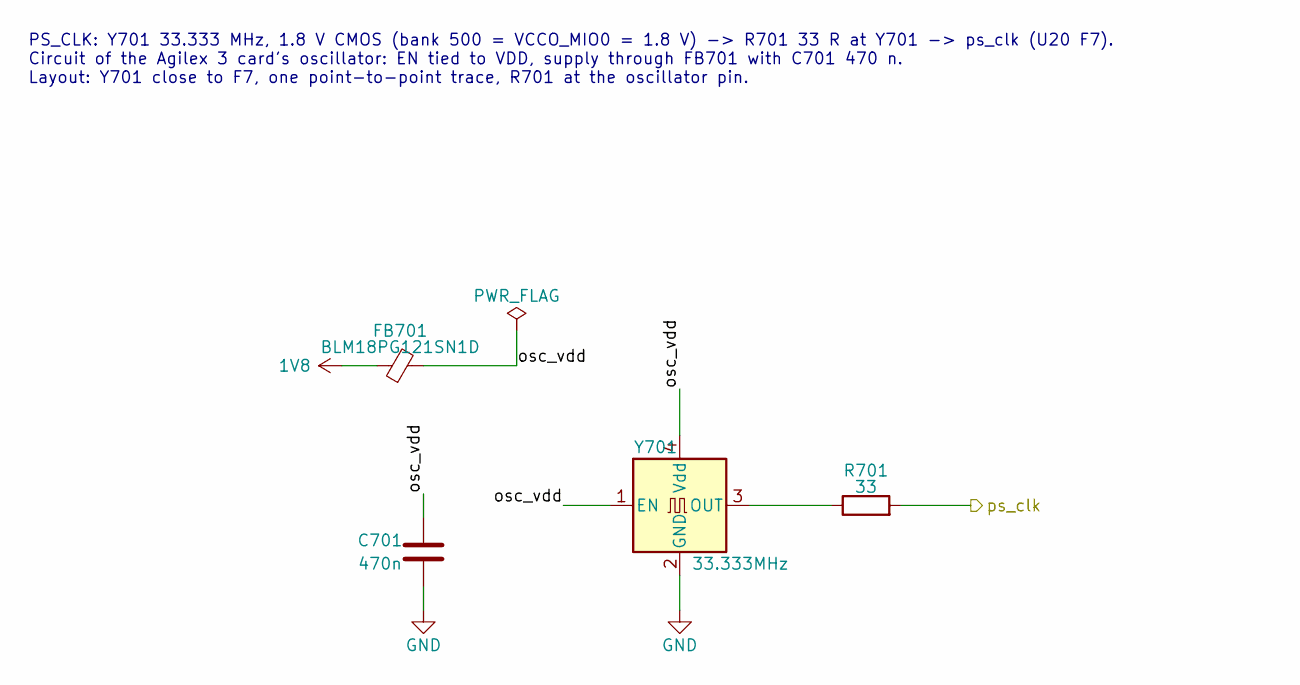
[picture p12: schematic 07_clocks.kicad_sch, Zynq-7000 control card - clocks]

Parts:
C701: 470n; C_0402_1005Metric; LCSC C47339
FB701: BLM18PG121SN1D; L_0603_1608Metric; MPN BLM18PG121SN1D; LCSC C14709
R701: 33; R_0402_1005Metric; LCSC C25105
Y701: 33.333MHz; Oscillator_SMD_Abracon_ASE-4Pin_3.2x2.5mm; MPN OT322533.3333MJBA4SL; LCSC C2831392

Connections:
1V8: FB701.1; also elsewhere on the board
/07 clocks/osc_vdd: C701.1, FB701.2, Y701.1 (EN), Y701.4 (Vdd)
/ps_clk: R701.2; also elsewhere on the board
GND: C701.2, Y701.2 (GND); also elsewhere on the board
unnamed: R701.1, Y701.3 (OUT)

Notes on the sheet:
PS_CLK: Y701 33.333 MHz, 1.8 V CMOS (bank 500 = VCCO_MIO0 = 1.8 V) -> R701 33 R at Y701 -> ps_clk (U20 F7). Circuit of the Agilex 3 card's oscillator: EN tied to VDD, supply through FB701 with C701 470 n. Layout: Y701 close to F7, one point-to-point trace, R701 at the oscillator pin.
