johonkanen/ac_psu_zynq_kicad/kicad/zynq_card.kicad_pcb

## KiCad design kicad/zynq_card.kicad_pcb (continued)

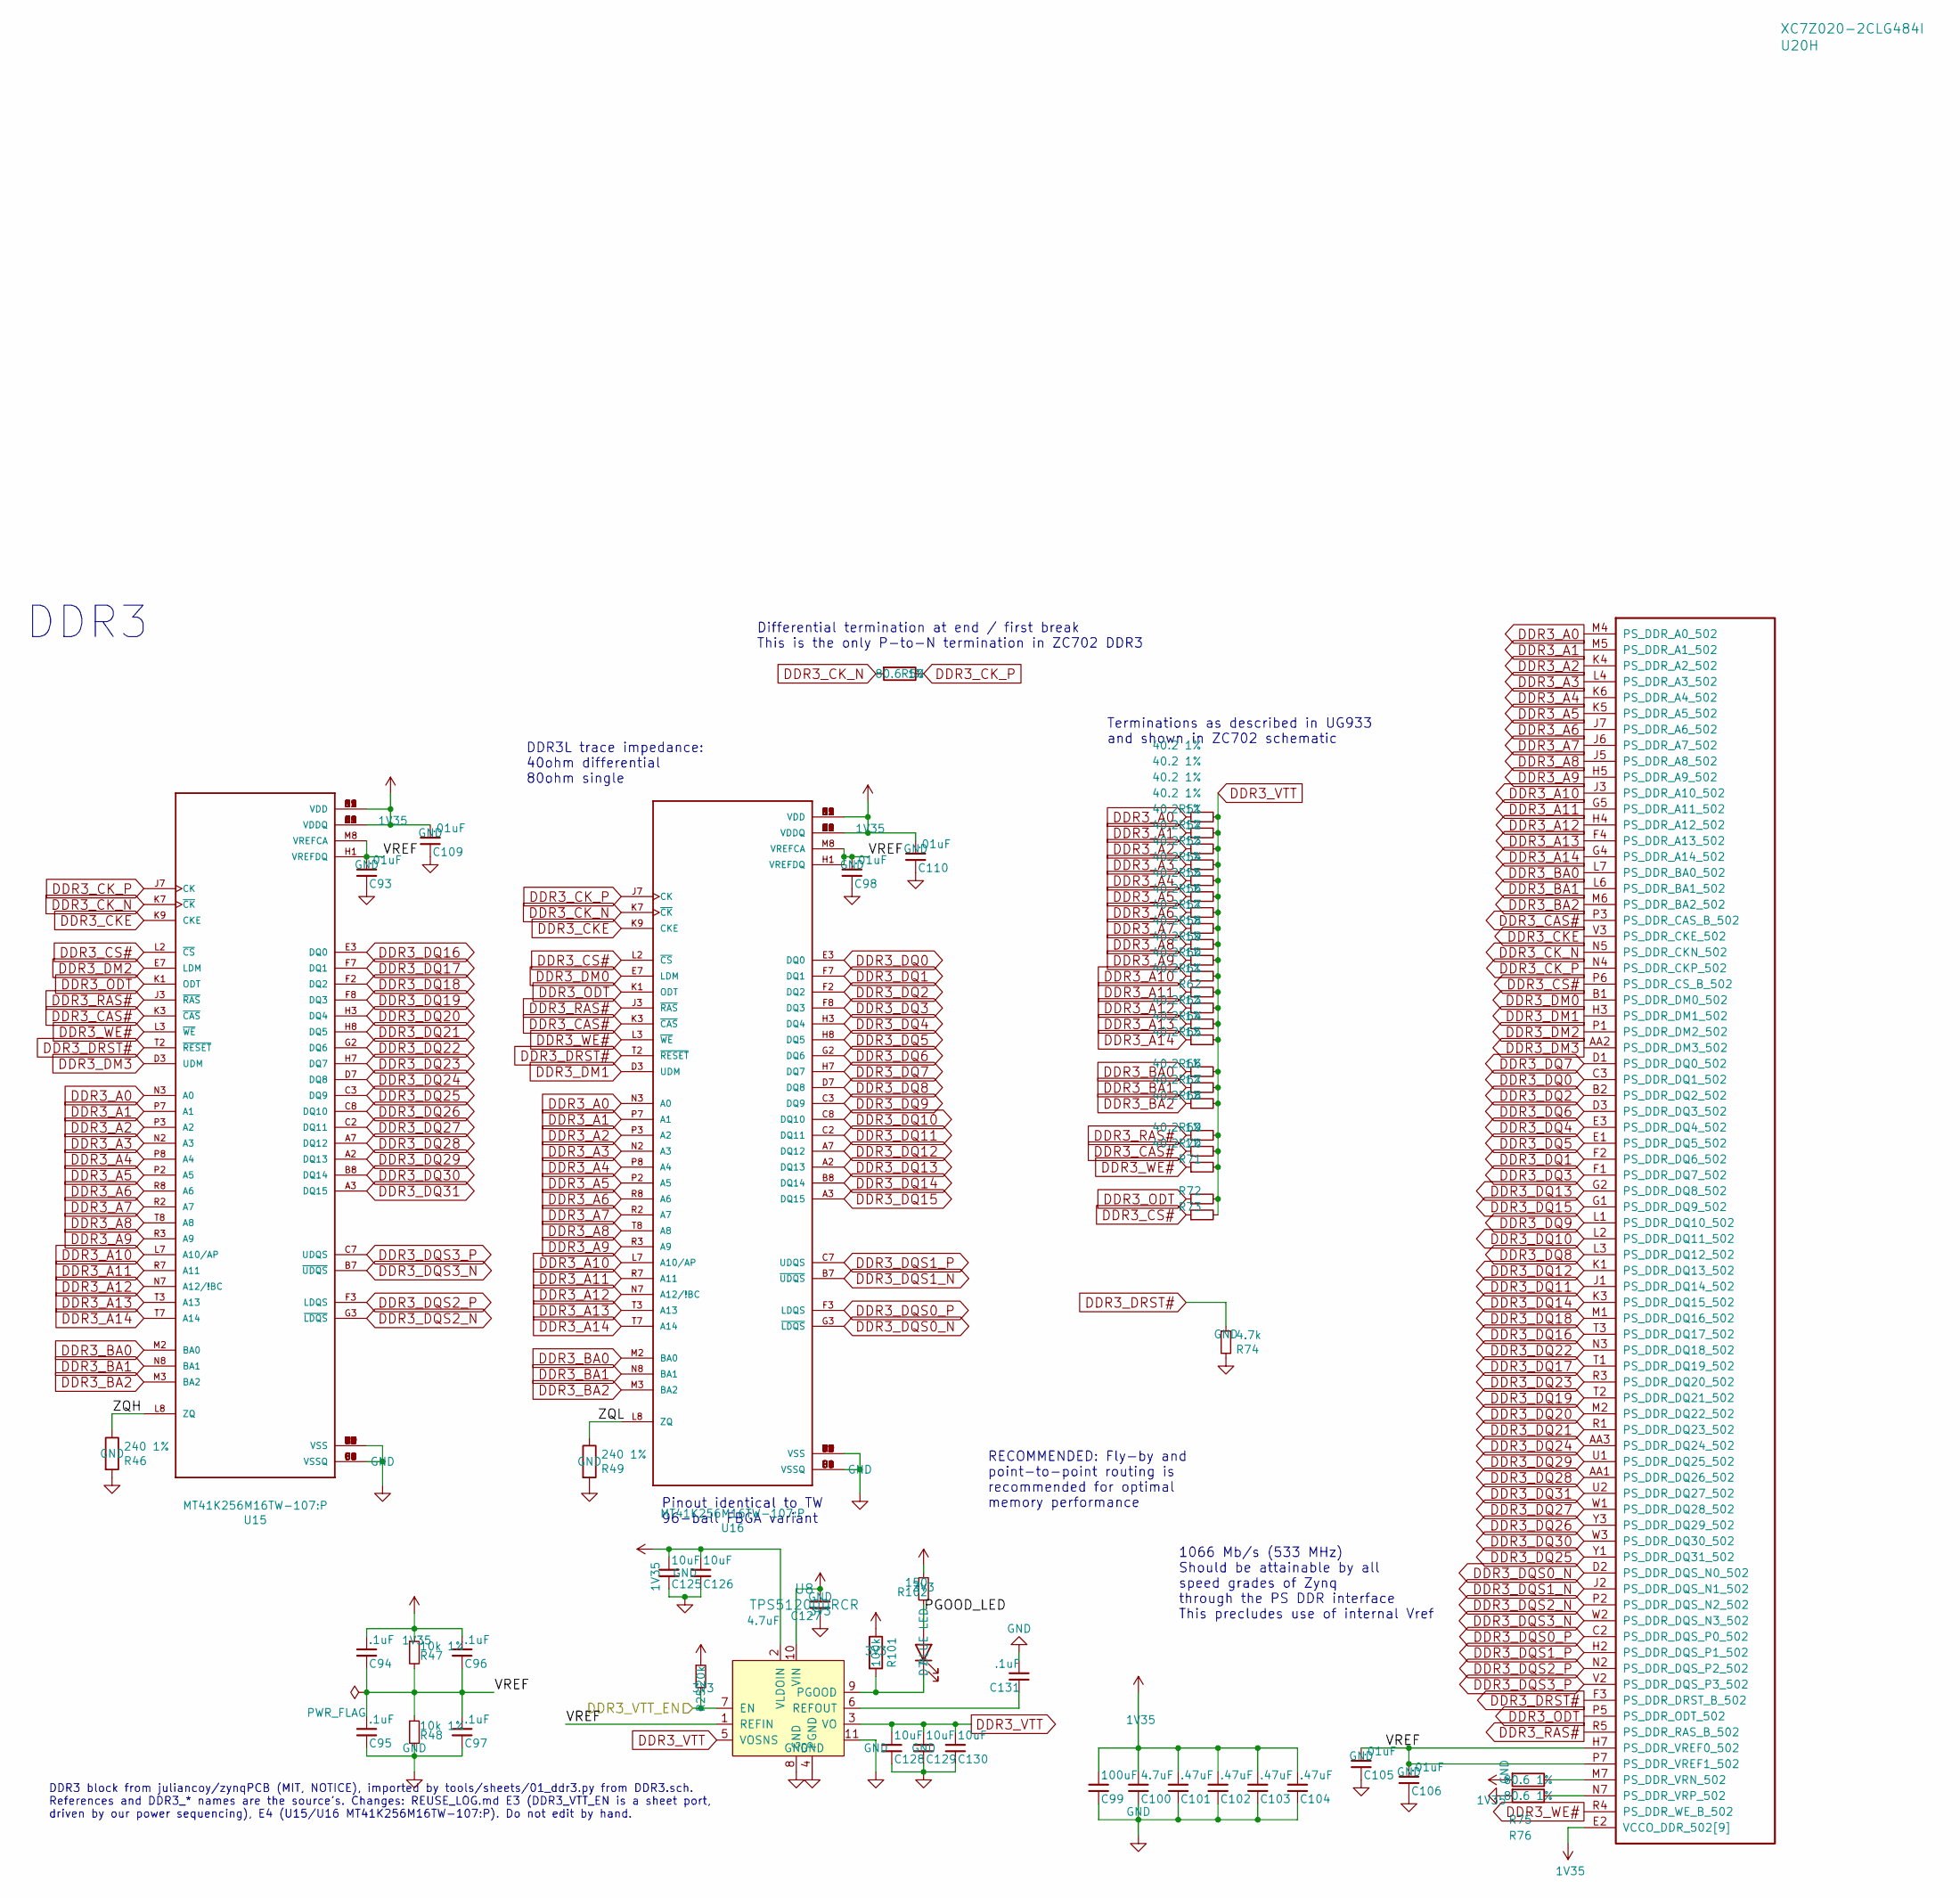
[picture p13: schematic 01_ddr3.kicad_sch, Zynq-7000 control card - ddr3]

Parts:
C93, C98, C105, C106, C109, C110: .01uF; C_0402_1005Metric; MPN CL05B103KB5NNNC; LCSC C15195
C94, C95, C96, C97, C131: .1uF; C_0402_1005Metric; MPN CL05B104KO5NNNC; LCSC C1525
C99: 100uF; C_1210_3225Metric; MPN CL32A107MQVNNNE; LCSC C49066
C100, C127: 4.7uF; C_0402_1005Metric; MPN CL05A475MP5NRNC; LCSC C23733
C101, C102, C103, C104: .47uF; C_0402_1005Metric; MPN CL05A474KP5NNNC; LCSC C47339
C125, C126, C128, C129, C130: 10uF; C_0603_1608Metric; MPN CL10A106KP8NNNC; LCSC C19702
D7: BLUE LED; C_0603_1608Metric; MPN VLMB1300-GS08; LCSC C435849
R25: 20k; R_0402_1005Metric; MPN RT0402BRD0720KL; LCSC C705630
R46, R49: 240 1%; R_0402_1005Metric; MPN RC0402FR-07240RL; LCSC C114755
R47, R48: 10k 1%; R_0402_1005Metric; MPN 0402WGF1002TCE; LCSC C25744
R50, R75, R76: 80.6 1%; R_0402_1005Metric; MPN RC0402FR-0780R6L; LCSC C185392
R51, R52, R53, R54, R55, R56, R57, R58, R59, R60, R61, R62, R63, R64, R65, R66, R67, R68, R69, R70, R71, R72, R73: 40.2 1%; R_0402_1005Metric; MPN RC0402FR-0740R2L; LCSC C274892
R74: 4.7k; R_0402_1005Metric; MPN 0402WGF4701TCE; LCSC C25900
R101: 100k; R_0402_1005Metric; MPN 0402WGF1003TCE; LCSC C25741
R102: 150; R_0402_1005Metric; MPN RC-02K1500FT; LCSC C140202
U8: TPS51200DRCR; VSON-10-1EP_3x3mm_P0.5mm_EP1.65x2.4mm_ThermalVias; MPN TPS51200DRCR; LCSC C34771
U15, U16: MT41K256M16TW-107:P; FBGA-96-DDR3-SDRAM; MPN MT41K256M16TW-107:P; LCSC C253882
U20: XC7Z020-2CLG484I; BGA-484_19.0x19.0mm_Layout22x22_P0.80mm_dia0.40mm; MPN XC7Z020-2CLG484I; LCSC C157624

Connections:
1V35: C94.1, C96.1, C99.1, C100.1, C101.1, C102.1, C103.1, C104.1, C109.1, C110.1, C125.1, C126.1, R47.1, R75.2, U8.2 (VLDOIN), U15.A1 (VDDQ), U15.A8 (VDDQ), U15.B2 (VDD), U15.C1 (VDDQ), U15.C9 (VDDQ), U15.D2 (VDDQ), U15.D9 (VDD), U15.E9 (VDDQ), U15.F1 (VDDQ), U15.G7 (VDD), U15.H2 (VDDQ), U15.H9 (VDDQ), U15.K2 (VDD), U15.K8 (VDD), U15.N1 (VDD), U15.N9 (VDD), U15.R1 (VDD), U15.R9 (VDD), U16.A1 (VDDQ), U16.A8 (VDDQ), U16.B2 (VDD), U16.C1 (VDDQ), U16.C9 (VDDQ), U16.D2 (VDDQ), U16.D9 (VDD), U16.E9 (VDDQ), U16.F1 (VDDQ), U16.G7 (VDD), U16.H2 (VDDQ), U16.H9 (VDDQ), U16.K2 (VDD), U16.K8 (VDD), U16.N1 (VDD), U16.N9 (VDD), U16.R1 (VDD), U16.R9 (VDD), U20.E2 (VCCO_DDR_502[9]), U20.F5 (VCCO_DDR_502[9]), U20.H1 (VCCO_DDR_502[9]), U20.J4 (VCCO_DDR_502[9]), U20.K7 (VCCO_DDR_502[9]), U20.M3 (VCCO_DDR_502[9]), U20.N6 (VCCO_DDR_502[9]), U20.R2 (VCCO_DDR_502[9]), U20.V1 (VCCO_DDR_502[9]); also elsewhere on the board
3V3: C127.2, R25.1, R101.1, R102.2, U8.10 (VIN); also elsewhere on the board
/01 ddr3/PGOOD_LED: D7.2 (A), R102.1
/01 ddr3/VREF: C93.1, C94.2, C95.1, C96.2, C97.1, C98.1, C105.1, C106.1, R47.2, R48.1, U8.1 (REFIN), U15.H1 (VREFDQ), U15.M8 (VREFCA), U16.H1 (VREFDQ), U16.M8 (VREFCA), U20.H7 (PS_DDR_VREF0_502), U20.P7 (PS_DDR_VREF1_502)
/01 ddr3/ZQH: R46.1, U15.L8 (ZQ)
/01 ddr3/ZQL: R49.1, U16.L8 (ZQ)
/DDR3_VTT_EN: R25.2, U8.7 (EN); also elsewhere on the board
DDR3_A0: R51.1, U15.N3 (A0), U16.N3 (A0), U20.M4 (PS_DDR_A0_502)
DDR3_A1: R52.1, U15.P7 (A1), U16.P7 (A1), U20.M5 (PS_DDR_A1_502)
DDR3_A2: R53.1, U15.P3 (A2), U16.P3 (A2), U20.K4 (PS_DDR_A2_502)
DDR3_A3: R54.1, U15.N2 (A3), U16.N2 (A3), U20.L4 (PS_DDR_A3_502)
DDR3_A4: R55.1, U15.P8 (A4), U16.P8 (A4), U20.K6 (PS_DDR_A4_502)
DDR3_A5: R56.1, U15.P2 (A5), U16.P2 (A5), U20.K5 (PS_DDR_A5_502)
DDR3_A6: R57.1, U15.R8 (A6), U16.R8 (A6), U20.J7 (PS_DDR_A6_502)
DDR3_A7: R58.1, U15.R2 (A7), U16.R2 (A7), U20.J6 (PS_DDR_A7_502)
DDR3_A8: R59.1, U15.T8 (A8), U16.T8 (A8), U20.J5 (PS_DDR_A8_502)
DDR3_A9: R60.1, U15.R3 (A9), U16.R3 (A9), U20.H5 (PS_DDR_A9_502)
DDR3_A10: R61.1, U15.L7 (A10/AP), U16.L7 (A10/AP), U20.J3 (PS_DDR_A10_502)
DDR3_A11: R62.1, U15.R7 (A11), U16.R7 (A11), U20.G5 (PS_DDR_A11_502)
DDR3_A12: R63.1, U15.N7 (A12/!BC), U16.N7 (A12/!BC), U20.H4 (PS_DDR_A12_502)
DDR3_A13: R64.1, U15.T3 (A13), U16.T3 (A13), U20.F4 (PS_DDR_A13_502)
DDR3_A14: R65.1, U15.T7 (A14), U16.T7 (A14), U20.G4 (PS_DDR_A14_502)
DDR3_BA0: R66.1, U15.M2 (BA0), U16.M2 (BA0), U20.L7 (PS_DDR_BA0_502)
DDR3_BA1: R67.1, U15.N8 (BA1), U16.N8 (BA1), U20.L6 (PS_DDR_BA1_502)
DDR3_BA2: R68.1, U15.M3 (BA2), U16.M3 (BA2), U20.M6 (PS_DDR_BA2_502)
DDR3_CAS#: R70.1, U15.K3 (~CAS), U16.K3 (~CAS), U20.P3 (PS_DDR_CAS_B_502)
DDR3_CKE: U15.K9 (CKE), U16.K9 (CKE), U20.V3 (PS_DDR_CKE_502)
DDR3_CK_N: R50.2, U15.K7 (~CK), U16.K7 (~CK), U20.N5 (PS_DDR_CKN_502)
DDR3_CK_P: R50.1, U15.J7 (CK), U16.J7 (CK), U20.N4 (PS_DDR_CKP_502)
DDR3_CS#: R73.1, U15.L2 (~CS), U16.L2 (~CS), U20.P6 (PS_DDR_CS_B_502)
DDR3_DM0: U16.E7 (LDM), U20.B1 (PS_DDR_DM0_502)
DDR3_DM1: U16.D3 (UDM), U20.H3 (PS_DDR_DM1_502)
DDR3_DM2: U15.E7 (LDM), U20.P1 (PS_DDR_DM2_502)
DDR3_DM3: U15.D3 (UDM), U20.AA2 (PS_DDR_DM3_502)
DDR3_DQ0: U16.E3 (DQ0), U20.C3 (PS_DDR_DQ1_502)
DDR3_DQ1: U16.F7 (DQ1), U20.F2 (PS_DDR_DQ6_502)
DDR3_DQ2: U16.F2 (DQ2), U20.B2 (PS_DDR_DQ2_502)
DDR3_DQ3: U16.F8 (DQ3), U20.F1 (PS_DDR_DQ7_502)
DDR3_DQ4: U16.H3 (DQ4), U20.E3 (PS_DDR_DQ4_502)
DDR3_DQ5: U16.H8 (DQ5), U20.E1 (PS_DDR_DQ5_502)
DDR3_DQ6: U16.G2 (DQ6), U20.D3 (PS_DDR_DQ3_502)
DDR3_DQ7: U16.H7 (DQ7), U20.D1 (PS_DDR_DQ0_502)
DDR3_DQ8: U16.D7 (DQ8), U20.L3 (PS_DDR_DQ12_502)
DDR3_DQ9: U16.C3 (DQ9), U20.L1 (PS_DDR_DQ10_502)
DDR3_DQ10: U16.C8 (DQ10), U20.L2 (PS_DDR_DQ11_502)
DDR3_DQ11: U16.C2 (DQ11), U20.J1 (PS_DDR_DQ14_502)
DDR3_DQ12: U16.A7 (DQ12), U20.K1 (PS_DDR_DQ13_502)
DDR3_DQ13: U16.A2 (DQ13), U20.G2 (PS_DDR_DQ8_502)
DDR3_DQ14: U16.B8 (DQ14), U20.K3 (PS_DDR_DQ15_502)
DDR3_DQ15: U16.A3 (DQ15), U20.G1 (PS_DDR_DQ9_502)
DDR3_DQ16: U15.E3 (DQ0), U20.T3 (PS_DDR_DQ17_502)
DDR3_DQ17: U15.F7 (DQ1), U20.T1 (PS_DDR_DQ19_502)
DDR3_DQ18: U15.F2 (DQ2), U20.M1 (PS_DDR_DQ16_502)
DDR3_DQ19: U15.F8 (DQ3), U20.T2 (PS_DDR_DQ21_502)
DDR3_DQ20: U15.H3 (DQ4), U20.M2 (PS_DDR_DQ22_502)
DDR3_DQ21: U15.H8 (DQ5), U20.R1 (PS_DDR_DQ23_502)
DDR3_DQ22: U15.G2 (DQ6), U20.N3 (PS_DDR_DQ18_502)
DDR3_DQ23: U15.H7 (DQ7), U20.R3 (PS_DDR_DQ20_502)
DDR3_DQ24: U15.D7 (DQ8), U20.AA3 (PS_DDR_DQ24_502)
DDR3_DQ25: U15.C3 (DQ9), U20.Y1 (PS_DDR_DQ31_502)
DDR3_DQ26: U15.C8 (DQ10), U20.Y3 (PS_DDR_DQ29_502)
DDR3_DQ27: U15.C2 (DQ11), U20.W1 (PS_DDR_DQ28_502)
DDR3_DQ28: U15.A7 (DQ12), U20.AA1 (PS_DDR_DQ26_502)
DDR3_DQ29: U15.A2 (DQ13), U20.U1 (PS_DDR_DQ25_502)
DDR3_DQ30: U15.B8 (DQ14), U20.W3 (PS_DDR_DQ30_502)
DDR3_DQ31: U15.A3 (DQ15), U20.U2 (PS_DDR_DQ27_502)
DDR3_DQS0_N: U16.G3 (~LDQS), U20.D2 (PS_DDR_DQS_N0_502)
DDR3_DQS0_P: U16.F3 (LDQS), U20.C2 (PS_DDR_DQS_P0_502)
DDR3_DQS1_N: U16.B7 (~UDQS), U20.J2 (PS_DDR_DQS_N1_502)
DDR3_DQS1_P: U16.C7 (UDQS), U20.H2 (PS_DDR_DQS_P1_502)
DDR3_DQS2_N: U15.G3 (~LDQS), U20.P2 (PS_DDR_DQS_N2_502)
DDR3_DQS2_P: U15.F3 (LDQS), U20.N2 (PS_DDR_DQS_P2_502)
DDR3_DQS3_N: U15.B7 (~UDQS), U20.W2 (PS_DDR_DQS_N3_502)
DDR3_DQS3_P: U15.C7 (UDQS), U20.V2 (PS_DDR_DQS_P3_502)
DDR3_DRST#: R74.1, U15.T2 (~RESET), U16.T2 (~RESET), U20.F3 (PS_DDR_DRST_B_502)
DDR3_ODT: R72.1, U15.K1 (ODT), U16.K1 (ODT), U20.P5 (PS_DDR_ODT_502)
DDR3_RAS#: R69.1, U15.J3 (~RAS), U16.J3 (~RAS), U20.R5 (PS_DDR_RAS_B_502)
DDR3_VTT: C128.1, C129.1, C130.1, R51.2, R52.2, R53.2, R54.2, R55.2, R56.2, R57.2, R58.2, R59.2, R60.2, R61.2, R62.2, R63.2, R64.2, R65.2, R66.2, R67.2, R68.2, R69.2, R70.2, R71.2, R72.2, R73.2, U8.3 (VO), U8.5 (VOSNS)
DDR3_WE#: R71.1, U15.L3 (~WE), U16.L3 (~WE), U20.R4 (PS_DDR_WE_B_502)
GND: C93.2, C95.2, C97.2, C98.2, C99.2, C100.2, C101.2, C102.2, C103.2, C104.2, C105.2, C106.2, C109.2, C110.2, C125.2, C126.2, C127.1, C128.2, C129.2, C130.2, C131.2, R46.2, R48.2, R49.2, R74.2, R76.2, U8.4 (PGND), U8.8 (GND), U8.11, U15.A9 (VSS), U15.B1 (VSSQ), U15.B3 (VSS), U15.B9 (VSSQ), U15.D1 (VSSQ), U15.D8 (VSSQ), U15.E1 (VSS), U15.E2 (VSSQ), U15.E8 (VSSQ), U15.F9 (VSSQ), U15.G1 (VSSQ), U15.G8 (VSS), U15.G9 (VSSQ), U15.J2 (VSS), U15.J8 (VSS), U15.M1 (VSS), U15.M9 (VSS), U15.P1 (VSS), U15.P9 (VSS), U15.T1 (VSS), U15.T9 (VSS), U16.A9 (VSS), U16.B1 (VSSQ), U16.B3 (VSS), U16.B9 (VSSQ), U16.D1 (VSSQ), U16.D8 (VSSQ), U16.E1 (VSS), U16.E2 (VSSQ), U16.E8 (VSSQ), U16.F9 (VSSQ), U16.G1 (VSSQ), U16.G8 (VSS), U16.G9 (VSSQ), U16.J2 (VSS), U16.J8 (VSS), U16.M1 (VSS), U16.M9 (VSS), U16.P1 (VSS), U16.P9 (VSS), U16.T1 (VSS), U16.T9 (VSS); also elsewhere on the board
unnamed: D7.1 (K), R101.2, U8.9 (PGOOD)
unnamed: C131.1, U8.6 (REFOUT)
unnamed: R75.1, U20.M7 (PS_DDR_VRN_502)
unnamed: R76.1, U20.N7 (PS_DDR_VRP_502)

Notes on the sheet:
Differential termination at end / first break This is the only P-to-N termination in ZC702 DDR3
Terminations as described in UG933 and shown in ZC702 schematic
Pinout identical to TW 96-ball FBGA variant
RECOMMENDED: Fly-by and point-to-point routing is recommended for optimal memory performance
DDR3L trace impedance: 40ohm differential 80ohm single
1066 Mb/s (533 MHz) Should be attainable by all speed grades of Zynq through the PS DDR interface This precludes use of internal Vref
DDR3
DDR3 block from juliancoy/zynqPCB (MIT, NOTICE), imported by tools/sheets/01_ddr3.py from DDR3.sch. References and DDR3_* names are the source's. Changes: REUSE_LOG.md E3 (DDR3_VTT_EN is a sheet port, driven by our power sequencing), E4 (U15/U16 MT41K256M16TW-107:P). Do not edit by hand.

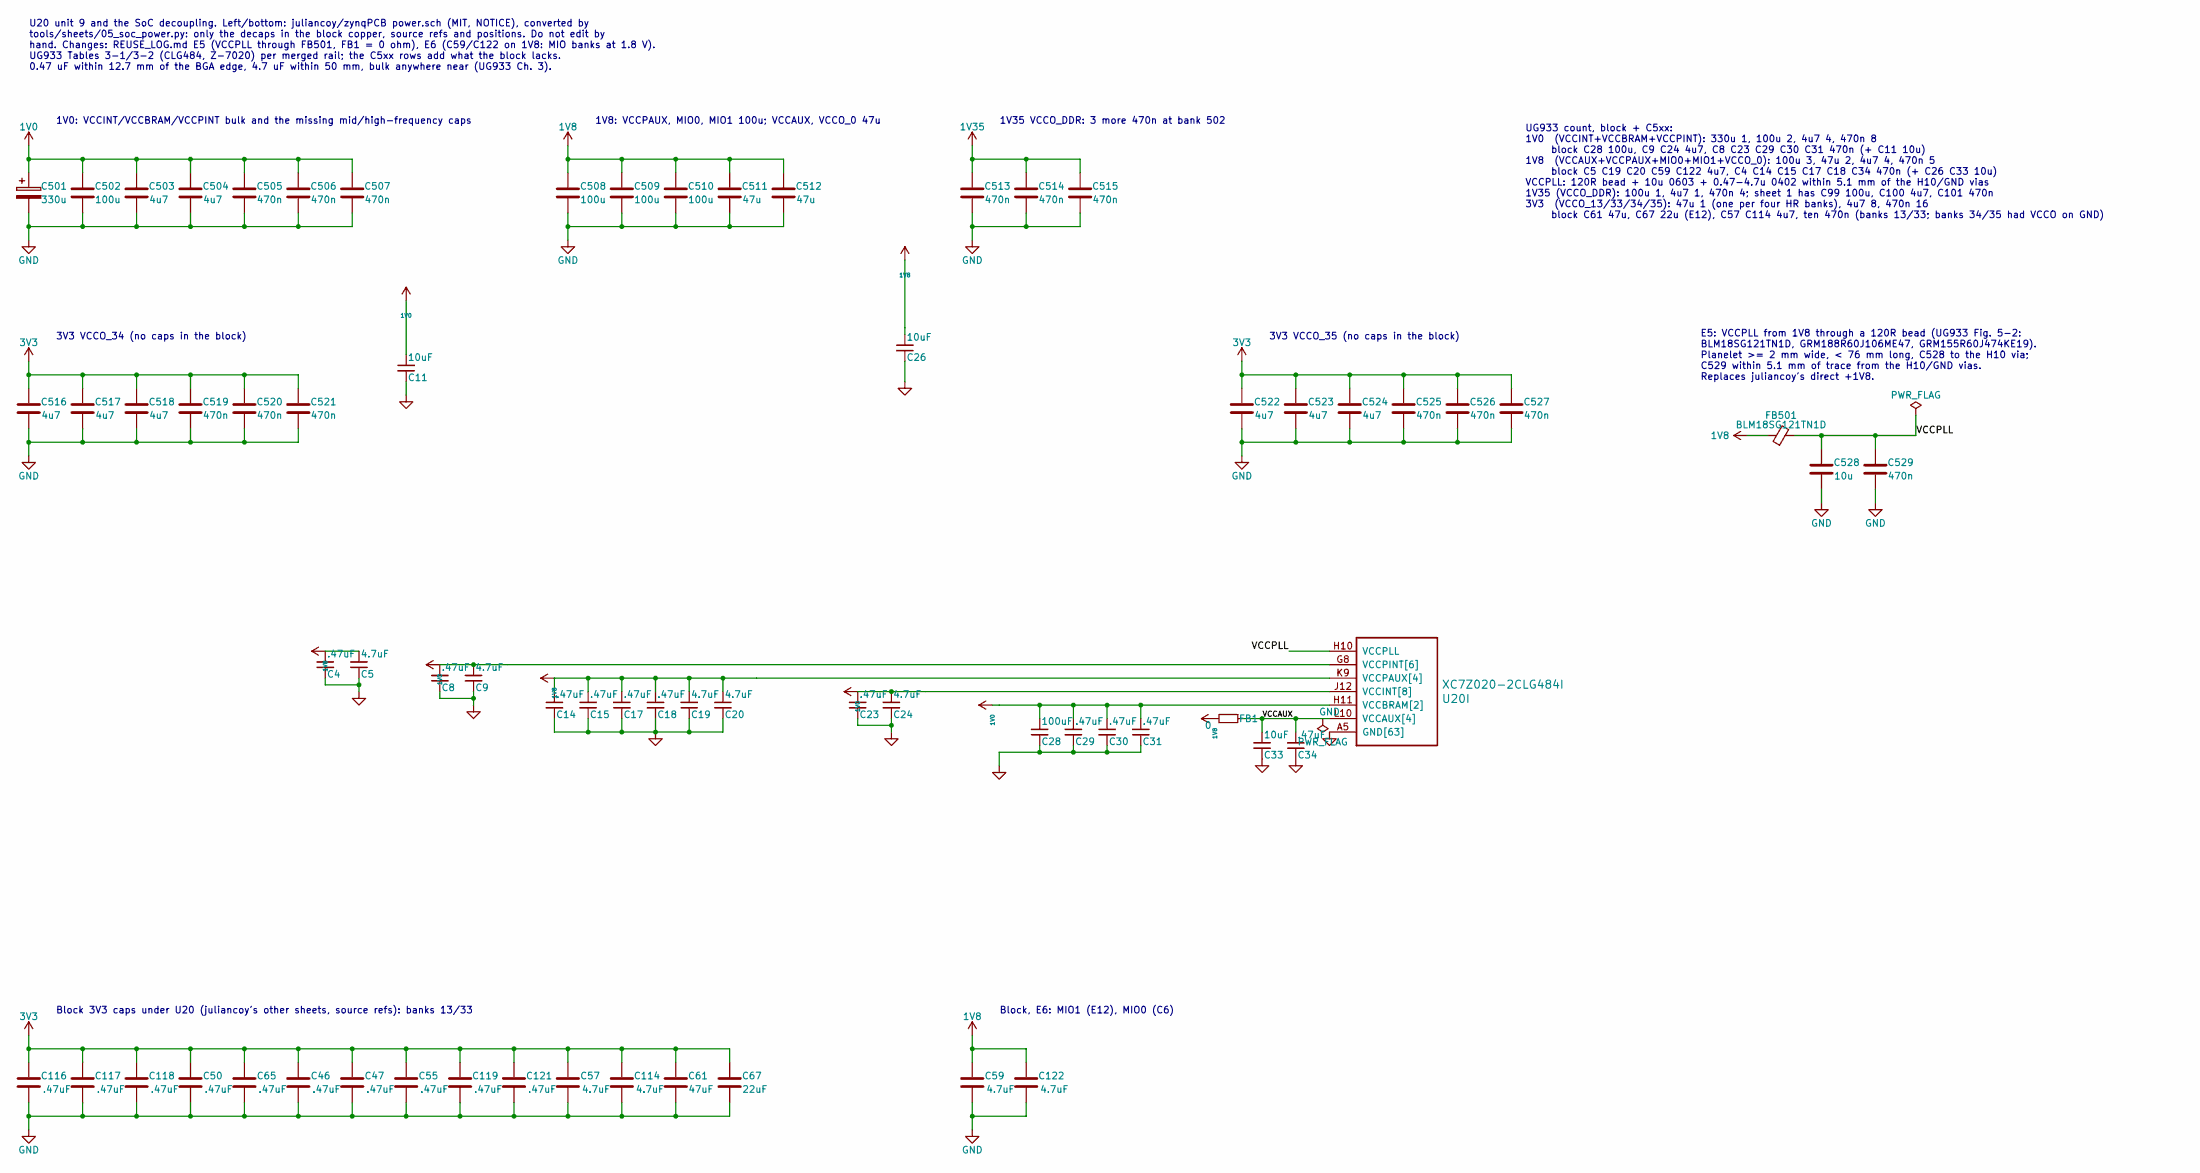
[picture p14: schematic 05_soc_power.kicad_sch, Zynq-7000 control card - soc_power]

Parts:
C4, C8, C14, C15, C17, C18, C23, C29, C30, C31, C34: .47uF; C_0402_1005Metric; MPN CL05A474KP5NNNC; LCSC C47339
C5, C9, C19, C20, C24: 4.7uF; C_0402_1005Metric; MPN CL05A475MP5NRNC; LCSC C23733
C11, C26, C33: 10uF; C_0603_1608Metric; MPN CL10A106KP8NNNC; LCSC C19702
C28: 100uF; C_1210_3225Metric; MPN CL32A107MQVNNNE; LCSC C49066
C46, C47, C50, C55, C65, C116, C117, C118, C119, C121: .47uF; C_0402_1005Metric; LCSC C47339
C57, C59, C114, C122: 4.7uF; C_0402_1005Metric; LCSC C23733
C61: 47uF; C_0805_2012Metric; LCSC C16780
C67: 22uF; C_1206_3216Metric; MPN CL31A226KAHNNNE; LCSC C12891
C501: 330u; CP_EIA-7343-31_Kemet-D; MPN T520D337M006ATE015; LCSC C116744
C502, C508, C509, C510: 100u; C_1210_3225Metric; LCSC C49066
C503, C504, C516, C517, C518, C522, C523, C524: 4u7; C_0402_1005Metric; LCSC C23733
C505, C506, C507, C513, C514, C515, C519, C520, C521, C525, C526, C527, C529: 470n; C_0402_1005Metric; LCSC C47339
C511, C512: 47u; C_1210_3225Metric; LCSC C77101
C528: 10u; C_0603_1608Metric; LCSC C19702
FB1: 0; C_0603_1608Metric; MPN 0603WAF0000T5E; LCSC C21189
FB501: BLM18SG121TN1D; L_0603_1608Metric; LCSC C113030
U20: XC7Z020-2CLG484I; BGA-484_19.0x19.0mm_Layout22x22_P0.80mm_dia0.40mm; MPN XC7Z020-2CLG484I; LCSC C157624

Connections:
1V0: C8.1, C9.1, C11.1, C23.1, C24.1, C28.1, C29.1, C30.1, C31.1, C501.1, C502.1, C503.1, C504.1, C505.1, C506.1, C507.1, U20.G8 (VCCPINT[6]), U20.H9 (VCCPINT[6]), U20.H11 (VCCBRAM[2]), U20.J8 (VCCPINT[6]), U20.J10 (VCCBRAM[2]), U20.J12 (VCCINT[8]), U20.J14 (VCCINT[8]), U20.K13 (VCCINT[8]), U20.L8 (VCCPINT[6]), U20.L14 (VCCINT[8]), U20.M13 (VCCINT[8]), U20.N8 (VCCPINT[6]), U20.N14 (VCCINT[8]), U20.P13 (VCCINT[8]), U20.R8 (VCCPINT[6]), U20.R14 (VCCINT[8]); also elsewhere on the board
1V8: C4.1, C5.1, C14.1, C15.1, C17.1, C18.1, C19.1, C20.1, C26.1, C59.1, C122.1, C508.1, C509.1, C510.1, C511.1, C512.1, FB1.2, FB501.1, U20.K9 (VCCPAUX[4]), U20.M9 (VCCPAUX[4]), U20.P9 (VCCPAUX[4]), U20.T9 (VCCPAUX[4]); also elsewhere on the board
1V35: C513.1, C514.1, C515.1; also elsewhere on the board
3V3: C46.1, C47.1, C50.1, C55.1, C57.1, C61.1, C65.1, C67.1, C114.1, C116.1, C117.1, C118.1, C119.1, C121.1, C516.1, C517.1, C518.1, C519.1, C520.1, C521.1, C522.1, C523.1, C524.1, C525.1, C526.1, C527.1; also elsewhere on the board
/05 soc_power/VCCAUX: C33.1, C34.1, FB1.1, U20.L10 (VCCAUX[4]), U20.N10 (VCCAUX[4]), U20.P11 (VCCAUX[4]), U20.R10 (VCCAUX[4])
/05 soc_power/VCCPLL: C528.1, C529.1, FB501.2, U20.H10 (VCCPLL)
GND: C4.2, C5.2, C8.2, C9.2, C11.2, C14.2, C15.2, C17.2, C18.2, C19.2, C20.2, C23.2, C24.2, C26.2, C28.2, C29.2, C30.2, C31.2, C33.2, C34.2, C46.2, C47.2, C50.2, C55.2, C57.2, C59.2, C61.2, C65.2, C67.2, C114.2, C116.2, C117.2, C118.2, C119.2, C121.2, C122.2, C501.2, C502.2, C503.2, C504.2, C505.2, C506.2, C507.2, C508.2, C509.2, C510.2, C511.2, C512.2, C513.2, C514.2, C515.2, C516.2, C517.2, C518.2, C519.2, C520.2, C521.2, C522.2, C523.2, C524.2, C525.2, C526.2, C527.2, C528.2, C529.2, U20.A5 (GND[63]), U20.A15 (GND[63]), U20.AA5 (GND[63]), U20.AA15 (GND[63]), U20.AB8 (GND[63]), U20.AB18 (GND[63]), U20.B8 (GND[63]), U20.B18 (GND[63]), U20.C1 (GND[63]), U20.C11 (GND[63]), U20.C21 (GND[63]), U20.D4 (GND[63]), U20.D14 (GND[63]), U20.E7 (GND[63]), U20.E17 (GND[63]), U20.F10 (GND[63]), U20.F20 (GND[63]), U20.G3 (GND[63]), U20.H6 (GND[63]), U20.H8 (GND[63]), U20.H12 (GND[63]), U20.H14 (GND[63]), U20.H16 (GND[63]), U20.J9 (GND[63]), U20.J11 (GND[63]), U20.J13 (GND[63]), U20.J19 (GND[63]), U20.K2 (GND[63]), U20.K8 (GND[63]), U20.K10 (GND[63]), U20.K14 (GND[63]), U20.K22 (GND[63]), U20.L5 (GND[63]), U20.L9 (GND[63]), U20.L13 (GND[63]), U20.L15 (GND[63]), U20.M8 (GND[63]), U20.M10 (GND[63]), U20.M14 (GND[63]), U20.M18 (GND[63]), U20.N1 (GND[63]), U20.N9 (GND[63]), U20.N13 (GND[63]), U20.N21 (GND[63]), U20.P4 (GND[63]), U20.P8 (GND[63]), U20.P10 (GND[63]), U20.P12 (GND[63]), U20.P14 (GND[63]), U20.R9 (GND[63]), U20.R11 (GND[63]), U20.R13 (GND[63]), U20.R17 (GND[63]), U20.T20 (GND[63]), U20.U3 (GND[63]), U20.U13 (GND[63]), U20.V6 (GND[63]), U20.V16 (GND[63]), U20.W9 (GND[63]), U20.W19 (GND[63]), U20.Y2 (GND[63]), U20.Y12 (GND[63]), U20.Y22 (GND[63]); also elsewhere on the board

Notes on the sheet:
U20 unit 9 and the SoC decoupling. Left/bottom: juliancoy/zynqPCB power.sch (MIT, NOTICE), converted by tools/sheets/05_soc_power.py: only the decaps in the block copper, source refs and positions. Do not edit by hand. Changes: REUSE_LOG.md E5 (VCCPLL through FB501, FB1 = 0 ohm), E6 (C59/C122 on 1V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
UG933 count, block + C5xx: 1V0 (VCCINT+VCCBRAM+VCCPINT): 330u 1, 100u 2, 4u7 4, 470n 8 block C28 100u, C9 C24 4u7, C8 C23 C29 C30 C31 470n (+ C11 10u) 1V8 (VCCAUX+VCCPAUX+MIO0+MIO1+VCCO_0): 100u 3, 47u 2, 4u7 4, 470n 5 block C5 C19 C20 C59 C122 4u7, C4 C14 C15 C17 C18 C34 470n (+ C26 C33 10u) VCCPL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
1V0: VCCINT/VCCBRAM/VCCPINT bulk and the missing mid/high-frequency caps
1V8: VCCPAUX, MIO0, MIO1 100u; VCCAUX, VCCO_0 47u
1V35 VCCO_DDR: 3 more 470n at bank 502
3V3 VCCO_34 (no caps in the block)
3V3 VCCO_35 (no caps in the block)
Block 3V3 caps under U20 (juliancoy's other sheets, source refs): banks 13/33
Block, E6: MIO1 (E12), MIO0 (C6)
E5: VCCPLL from 1V8 through a 120R bead (UG933 Fig. 5-2: BLM18SG121TN1D, GRM188R60J106ME47, GRM155R60J474KE19). Planelet >= 2 mm wide, < 76 mm long, C528 to the H10 via; C529 within 5.1 mm of trace from the H10/GND vias. Replaces juliancoy's direct +1V8.

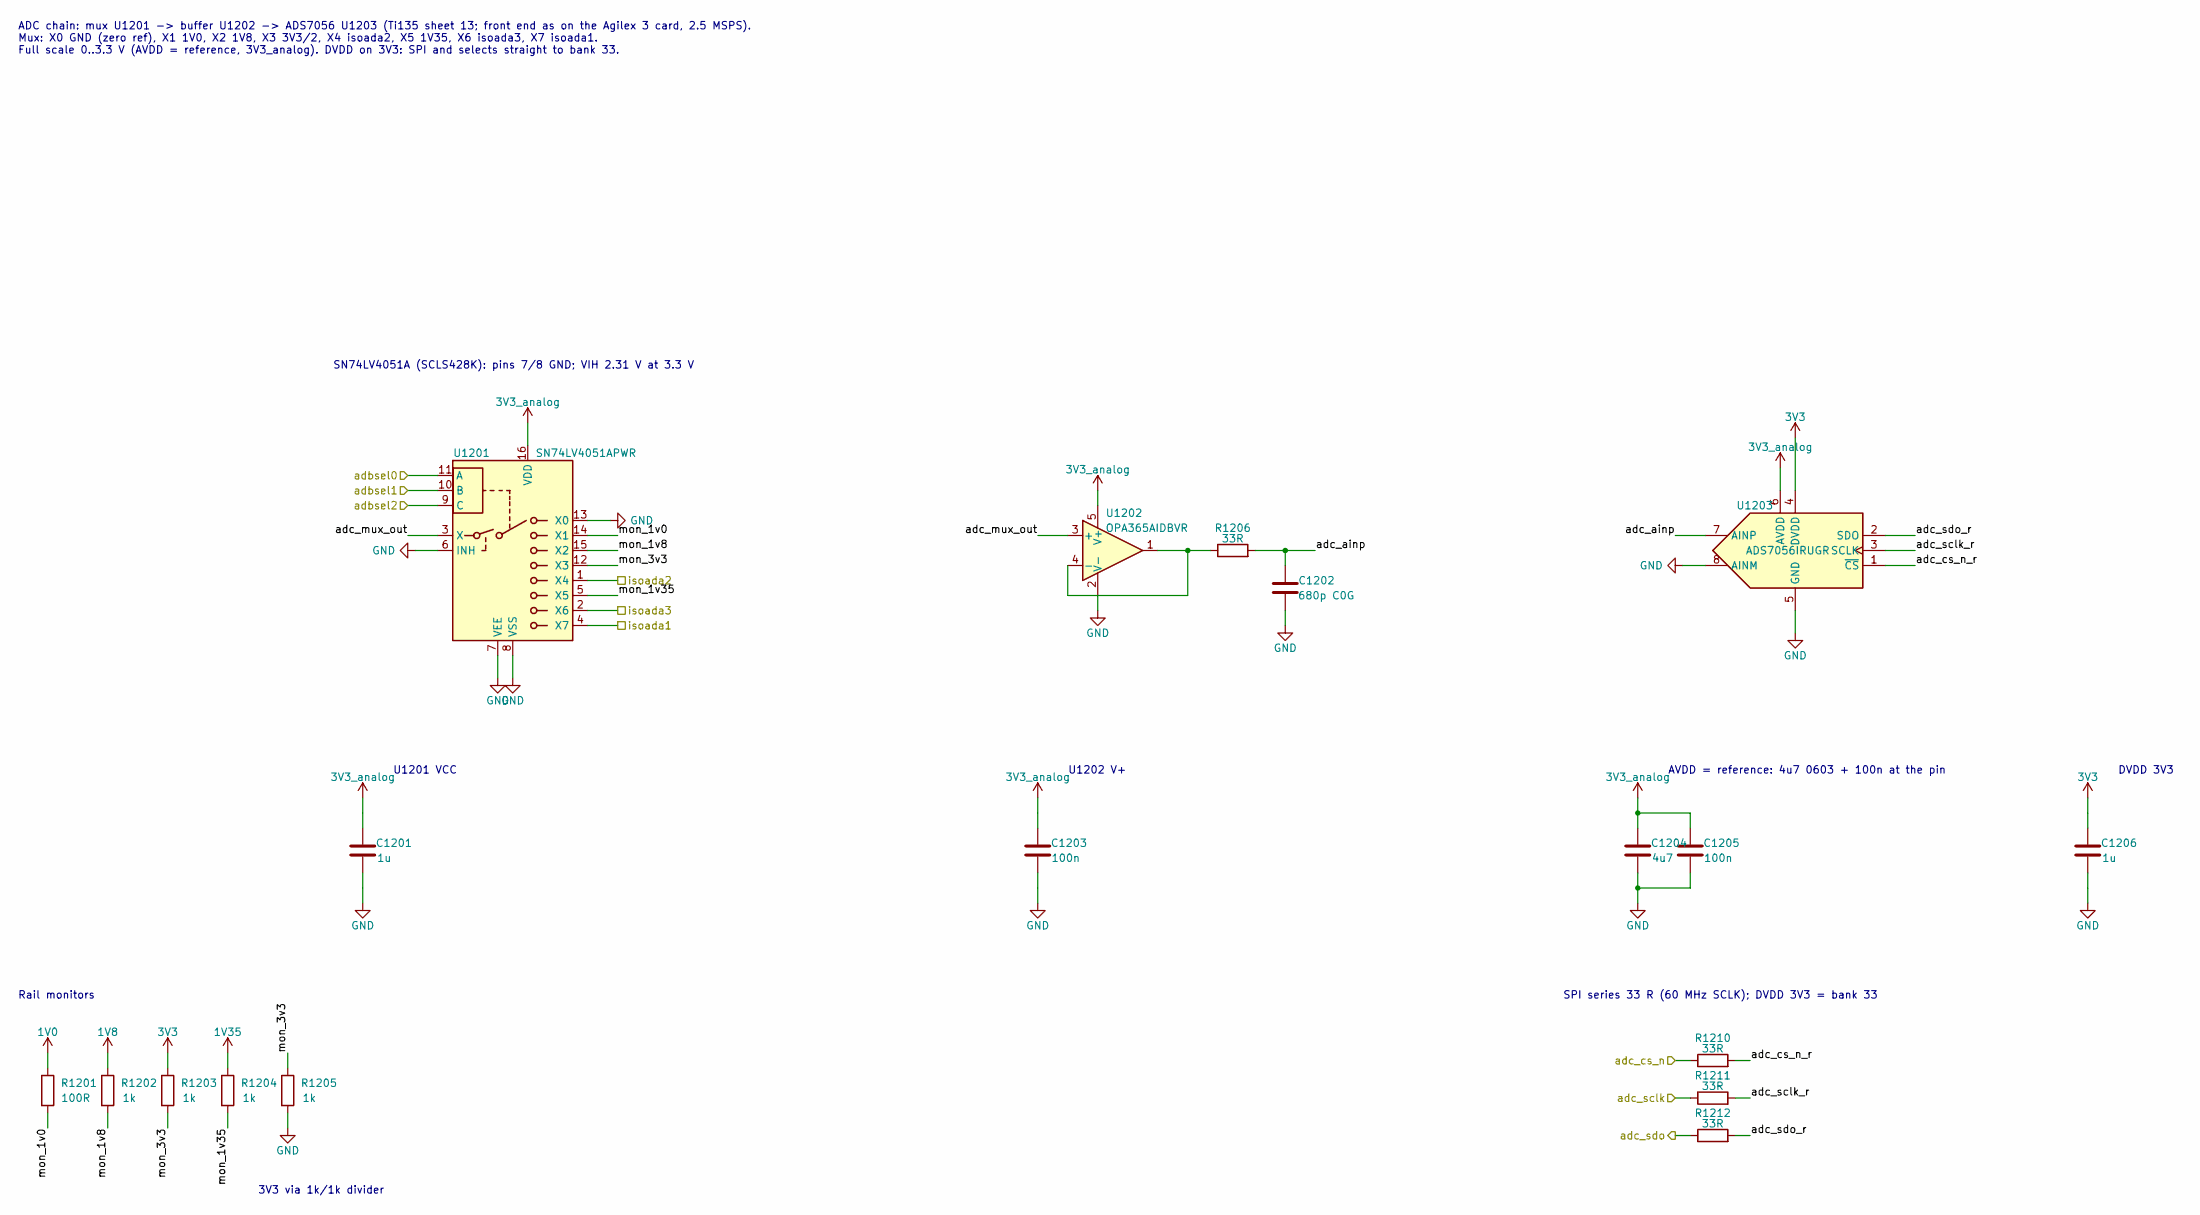
[picture p15: schematic 12_adc.kicad_sch, Zynq-7000 control card - adc]

Parts:
C1201, C1206: 1u; C_0402_1005Metric; LCSC C52923
C1202: 680p C0G; C_0402_1005Metric; LCSC C113781
C1203, C1205: 100n; C_0402_1005Metric; LCSC C1525
C1204: 4u7; C_0603_1608Metric; LCSC C19666
R1201: 100R; R_0402_1005Metric; LCSC C25076
R1202, R1203, R1204, R1205: 1k; R_0402_1005Metric; LCSC C11702
R1206, R1210, R1211, R1212: 33R; R_0402_1005Metric; LCSC C25105
U1201: SN74LV4051APWR; TSSOP-16_4.4x5mm_P0.65mm; LCSC C7793
U1202: OPA365AIDBVR; SOT-23-5; LCSC C96626
U1203: ADS7056IRUGR; ads7056; LCSC C2669798

Connections:
1V0: R1201.1; also elsewhere on the board
1V8: R1202.1; also elsewhere on the board
1V35: R1204.1; also elsewhere on the board
3V3: C1206.1, R1203.1, U1203.4 (DVDD); also elsewhere on the board
3V3_analog: C1201.1, C1203.1, C1204.1, C1205.1, U1201.16 (VDD), U1202.5 (V+), U1203.6 (AVDD); also elsewhere on the board
/12 adc/adc_ainp: C1202.1, R1206.2, U1203.7 (AINP)
/12 adc/adc_cs_n_r: R1210.2, U1203.1 (~CS)
/12 adc/adc_mux_out: U1201.3 (X), U1202.3 (+)
/12 adc/adc_sclk_r: R1211.2, U1203.3 (SCLK)
/12 adc/adc_sdo_r: R1212.2, U1203.2 (SDO)
/12 adc/mon_1v0: R1201.2, U1201.14 (X1)
/12 adc/mon_1v8: R1202.2, U1201.15 (X2)
/12 adc/mon_1v35: R1204.2, U1201.5 (X5)
/12 adc/mon_3v3: R1203.2, R1205.1, U1201.12 (X3)
/adbsel0: U1201.11 (A); also elsewhere on the board
/adbsel1: U1201.10 (B); also elsewhere on the board
/adbsel2: U1201.9 (C); also elsewhere on the board
/adc_cs_n: R1210.1; also elsewhere on the board
/adc_sclk: R1211.1; also elsewhere on the board
/adc_sdo: R1212.1; also elsewhere on the board
/isoada1: U1201.4 (X7); also elsewhere on the board
/isoada2: U1201.1 (X4); also elsewhere on the board
/isoada3: U1201.2 (X6); also elsewhere on the board
GND: C1201.2, C1202.2, C1203.2, C1204.2, C1205.2, C1206.2, R1205.2, U1201.6 (INH), U1201.7 (VEE), U1201.8 (VSS), U1201.13 (X0), U1202.2 (V-), U1203.5 (GND), U1203.8 (AINM); also elsewhere on the board
unnamed: R1206.1, U1202.1, U1202.4 (-)

Notes on the sheet:
ADC chain: mux U1201 -> buffer U1202 -> ADS7056 U1203 (Ti135 sheet 13; front end as on the Agilex 3 card, 2.5 MSPS). Mux: X0 GND (zero ref), X1 1V0, X2 1V8, X3 3V3/2, X4 isoada2, X5 1V35, X6 isoada3, X7 isoada1. Full scale 0..3.3 V (AVDD = reference, 3V3_analog). DVDD on 3V3: SPI and selects straig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
U1201 VCC
SN74LV4051A (SCLS428K): pins 7/8 GND; VIH 2.31 V at 3.3 V
Rail monitors
3V3 via 1k/1k divider
U1202 V+
AVDD = reference: 4u7 0603 + 100n at the pin
DVDD 3V3
SPI series 33 R (60 MHz SCLK); DVDD 3V3 = bank 33

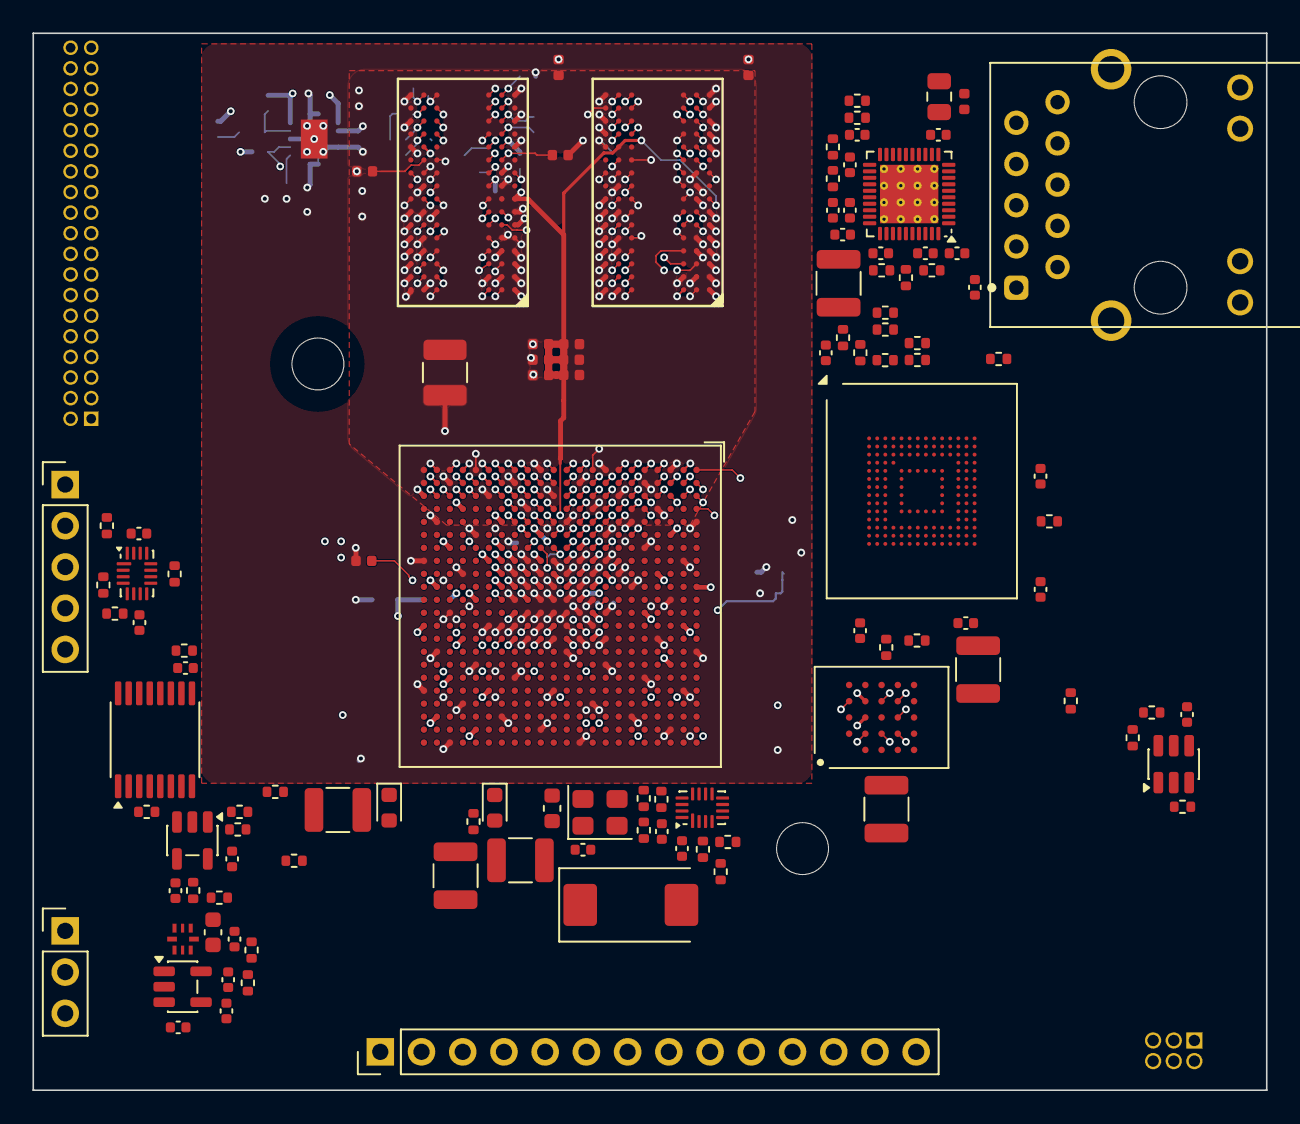
[picture p16: board zynq_card.kicad_pcb from above]

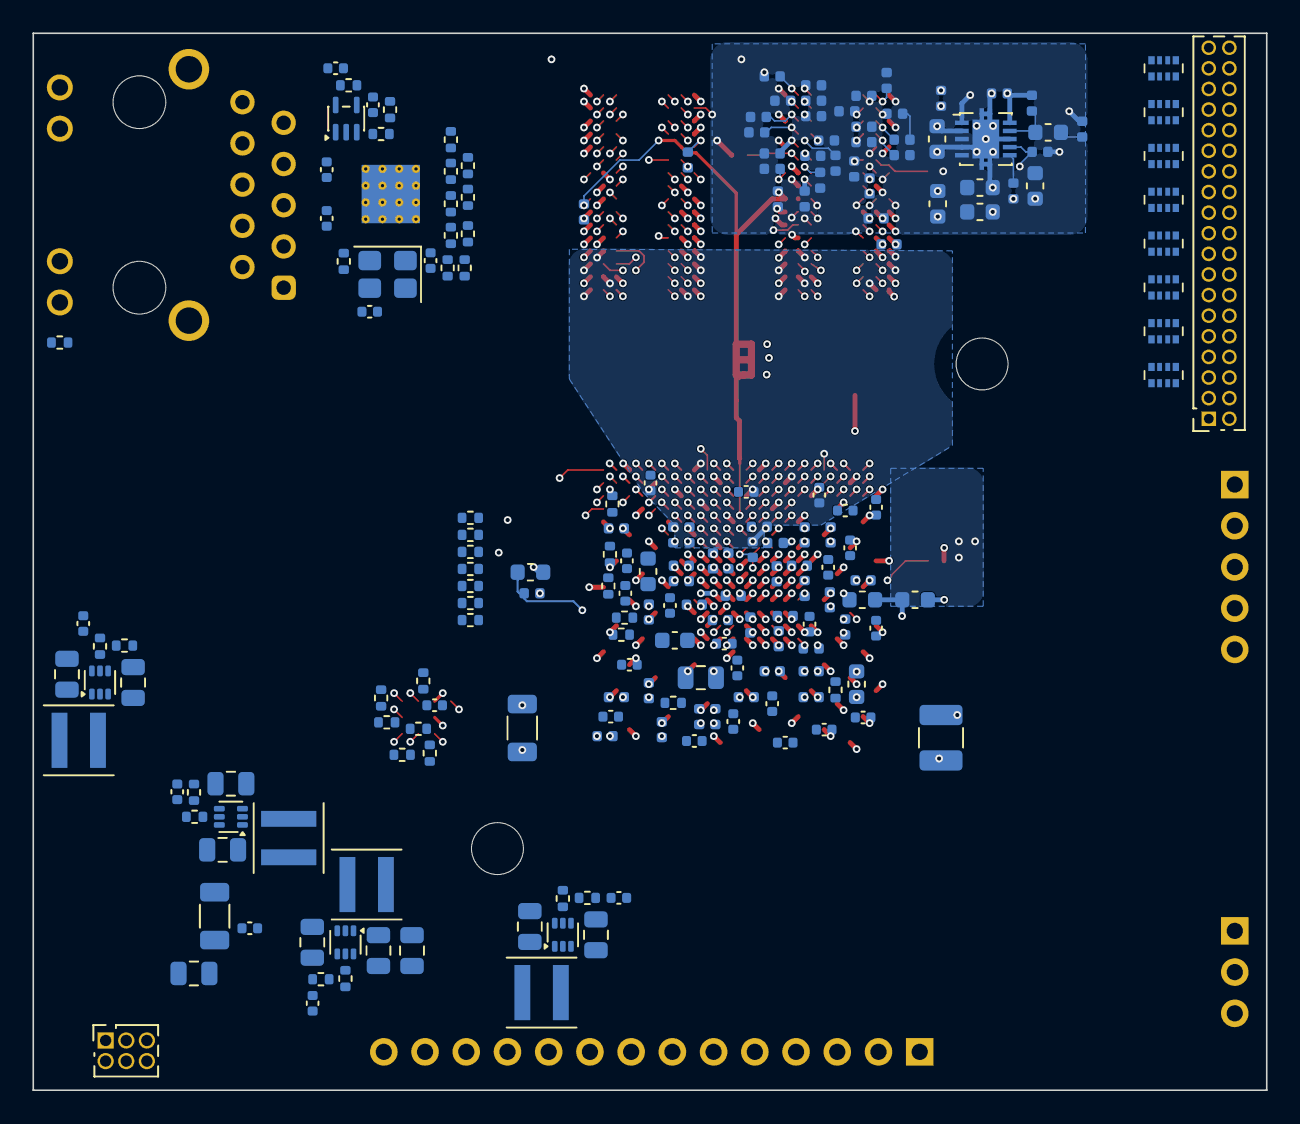
[picture p17: board zynq_card.kicad_pcb from below]

Board: 8 copper layers, 76.0 x 65.1 mm, 311 parts (195 on the bottom side), 262 nets.

Other parts of the board:
H1, H2: MountingHole_3.2mm_M3
