johonkanen/ac_psu_zynq_kicad/tools/make_board.py

#!/usr/bin/env python3
"""Create kicad/zynq_card.kicad_pcb from the schematic (run under KiCad's python: tools/p2k/bin/kipy tools/make_board.py).

Ported from the Ti135 card (efinix_soc_board/tools/make_board.py). Re-runnable start-of-layout tool: it rebuilds the
board from scratch, so only use it until routing outside the block starts (LAYOUT_PLAN.md ground rules).
- one footprint per symbol, with nets, pin functions/types and symbol links (DRC schematic parity);
- **block parts** (refs below 200 that are on juliancoy's board, PLAN.md §4.1) take their footprint from the source
  board, not from the KiCad 10 libraries: the copied copper (tools/import_block.py) must meet the pads it was routed
  to. The source's footprint id must equal the schematic's;
- the outline (76.000 x 65.127 mm) and the aux/grid origin at KiCad (100, 100) = the Ti60 Gerber origin
  (MECHANICAL.md);
- the fixed parts J3, J6 (bottom-side sockets to the baseboard) and J9 (HR911130A magjack). Each is placed by
  trying the orientations and keeping the one that puts its pads/pegs on the MECHANICAL.md coordinates
  (it fails if none does);
- J5 at the Ti60/Agilex position, J1/J2 west below J3 (MECHANICAL.md);
- every other footprint, the block included, staged by sheet in a grid to the right of the board. The block is
  placed by tools/import_block.py;
- 8 copper layers. The stack-up, net classes and DRC rules are added afterwards by tools/board_setup.py.
"""
import os
import sys

TOOLS = os.path.dirname(os.path.abspath(__file__))
ROOT = os.path.dirname(TOOLS)
sys.path.insert(0, os.path.join(TOOLS, "p2k"))
os.environ.setdefault("P2K_BOARD", ROOT)
os.environ.setdefault("P2K_PCB", os.path.join(ROOT, "kicad", "zynq_card.kicad_pcb"))
os.environ.setdefault("P2K_SCHEMATIC", os.path.join(ROOT, "kicad", "zynq_card.kicad_sch"))
os.environ.setdefault("P2K_REPORTS", os.path.join(ROOT, "reports"))

import subprocess  # noqa: E402
import tempfile  # noqa: E402
import xml.etree.ElementTree as ET  # noqa: E402

import pcbnew  # noqa: E402

from p2k import board as p2k_board  # noqa: E402
from p2k import pcb  # noqa: E402
from p2k.build_pcb import load_fp  # noqa: E402
sys.path.insert(0, TOOLS)
from check_block_netlist import FP_SWAP  # noqa: E402

SOURCE = os.path.join(ROOT, "reference", "zynqpcb", "DFTBoard.kicad_pcb")


def mm(v):
    return pcbnew.FromMM(v)


def V(x, y):
    return pcbnew.VECTOR2I(mm(x), mm(y))


OUTLINE = (131.531, 51.694, 207.531, 116.821)          # x0, y0, x1, y1 (KiCad frame, MECHANICAL.md)
ORIGIN = (100.0, 100.0)                                # Ti60 Gerber origin

# fixed parts: reference -> (side, {pad number: (x, y)} the pads must land on, anchor position)
J3_PADS = {"1": (135.102, 75.445), "2": (133.832, 75.445), "37": (135.102, 52.585), "38": (133.832, 52.585)}
J6_PADS = {"1": (203.072, 113.754), "2": (203.072, 115.024), "3": (201.802, 113.754), "6": (200.532, 115.024)}
J9_ORIGIN = (200.992, 61.655)                          # peg midpoint: front face at Ti60 X 111.912, centre Y 38.345
J9_PADS = {"1": (192.102, 67.37), "10": (194.642, 55.94), "11": (205.892, 68.28), "14": (205.892, 55.03)}
FIXED = {
    "J3": ("bottom", J3_PADS, J3_PADS["1"]),
    "J6": ("bottom", J6_PADS, J6_PADS["1"]),
    "J9": ("top", J9_PADS, J9_ORIGIN),
}
# smaller THT pads, so a track fits between them: reference -> (pad diameter, drill) mm. J3 at 1.27 mm pitch: the
# library's 1.0/0.7 leaves 0.27 mm; 0.9/0.6 (as on the Ti135 card) leaves 0.37 mm for a 0.1 mm track with 0.135 mm
# each side, annular ring 0.15 mm. The socket's tails (HC-PM127-4.3H-2x19PZ) fit a 0.6 mm hole
PAD_SIZE = {"J3": (0.9, 0.6)}
# soft positions: reference -> (x, y, orientation, side)
SOFT = {
    "J5": (152.912, 114.454, 90.0, "top"),  # LCD header, Ti60 J4 / Agilex J5 position
    # JTAG / UART headers in line with J3's pin column, south of it (MECHANICAL.md)
    "J1": (133.5, 79.5, 0.0, "top"),
    "J2": (133.5, 107.0, 0.0, "top"),
}


def is_block(ref, source):
    """A block part keeps the source's reference, below 200 (the family connectors J1..J9 are ours)."""
    num = ref.lstrip("ABCDEFGHIJKLMNOPQRSTUVWXYZ")
    return not ref.startswith(("#", "J")) and num.isdigit() and int(num) < 200 and ref in source


def pin_info():
    """{(ref, pin): (pin function, pin type)} from the schematic netlist. p2k's export_netlist drops them; pcbnew's
    "Update from schematic" sets them, and the placement tools read them (power pins, an oscillator's OUT)."""
    with tempfile.TemporaryDirectory() as tmp:
        out = os.path.join(tmp, "netlist.xml")
        subprocess.run([os.path.join(p2k_board.BIN, "kicad-cli"), "sch", "export", "netlist", "--format", "kicadxml",
                        "-o", out, pcb.schematic_file()], check=True, capture_output=True)
        xml = ET.parse(out).getroot()
    return {(nd.get("ref"), nd.get("pin")): (nd.get("pinfunction") or "", nd.get("pintype") or "")
            for n in xml.iter("net") for nd in n.findall("node")}


def from_source(src_fp, fpid):
    """A copy of the source board's footprint, back at the origin, top side, orientation 0, unlocked."""
    if src_fp.GetFPIDAsString() != fpid:
        raise SystemExit(f"make_board: {src_fp.GetReference()} is {src_fp.GetFPIDAsString()} on the source, "
                         f"{fpid} in the schematic")
    fp = pcbnew.FOOTPRINT(src_fp)
    if fp.IsFlipped():
        fp.Flip(fp.GetPosition(), pcbnew.FLIP_DIRECTION_LEFT_RIGHT)
    fp.SetOrientationDegrees(0.0)
    fp.SetPosition(V(0, 0))
    fp.SetLocked(False)
    for f in list(fp.GetFields()):
        if not f.IsMandatory():
            fp.RemoveField(f.GetName())
    # juliancoy's silk text is 0.6/0.1 mm; JLC's minimum is 0.8/0.15 (silk only, the pads are untouched)
    for t in [*fp.GetFields(), *(g for g in fp.GraphicalItems() if isinstance(g, pcbnew.PCB_TEXT))]:
        if t.GetTextHeight() < mm(0.8):
            t.SetTextSize(pcbnew.VECTOR2I(mm(0.8), mm(0.8)))
            t.SetTextThickness(mm(0.15))
    return fp


def hide_designators(fp):
    """No reference-designator silkscreen on this card (user, 2026-10-29; as on the Ti135 card): the Reference field
    and any ${REFERENCE} text on F/B.SilkS are hidden. The F.Fab reference stays (assembly drawings)."""
    silk = (pcbnew.F_SilkS, pcbnew.B_SilkS)
    ref = fp.Reference()
    if ref.GetLayer() in silk:
        ref.SetVisible(False)
    for t in fp.GraphicalItems():
        if isinstance(t, pcbnew.PCB_TEXT) and t.GetLayer() in silk and "${REFERENCE}" in t.GetText():
            t.SetVisible(False)


def place(board, fp, x, y, side, orient):
    board.Add(fp)
    fp.SetPosition(V(x, y))
    if side == "bottom":
        fp.Flip(V(x, y), pcbnew.FLIP_DIRECTION_LEFT_RIGHT)
    fp.SetOrientationDegrees(orient)


def pad_xy(fp, num):
    for p in fp.Pads():
        if p.GetNumber() == num:
            q = p.GetPosition()
            return pcbnew.ToMM(q.x), pcbnew.ToMM(q.y)
    raise KeyError(num)


def fit_fixed(board, make, side, pads, anchor):
    """Try the four orientations (and, for a pad anchor, the matching position) until every listed pad lands on
    its target within 0.01 mm. make() returns a fresh footprint (Flip() on a re-used one would toggle its side)."""
    for orient in (0.0, 90.0, 180.0, 270.0):
        fp = make()
        place(board, fp, *anchor, side, orient)
        # the anchor may be a pad, not the footprint origin: shift so the first listed pad is on target
        first = next(iter(pads))
        if anchor == pads[first]:
            px, py = pad_xy(fp, first)
            pos = fp.GetPosition()
            fp.SetPosition(pcbnew.VECTOR2I(pos.x + mm(anchor[0] - px), pos.y + mm(anchor[1] - py)))
        err = max(max(abs(a - b) for a, b in zip(pad_xy(fp, n), xy)) for n, xy in pads.items())
        if err < 0.01:
            return orient
        board.Remove(fp)
    raise SystemExit(f"make_board: no orientation puts {fp.GetReference()} on its MECHANICAL.md pads")


def add_outline(board):
    x0, y0, x1, y1 = OUTLINE
    for a, b in (((x0, y0), (x1, y0)), ((x1, y0), (x1, y1)), ((x1, y1), (x0, y1)), ((x0, y1), (x0, y0))):
        s = pcbnew.PCB_SHAPE(board)
        s.SetShape(pcbnew.SHAPE_T_SEGMENT)
        s.SetLayer(pcbnew.Edge_Cuts)
        s.SetStart(V(*a))
        s.SetEnd(V(*b))
        s.SetWidth(mm(0.1))
        board.Add(s)


def main():
    pcbnew.KIID.SeedGenerator(4001)
    out = os.environ["P2K_PCB"]
    comps, nets = pcb.export_netlist()
    pin_net = {(r, p): n for n, nodes in nets.items() for r, p in nodes}
    pins = pin_info()
    source = {fp.GetReference(): fp for fp in pcbnew.LoadBoard(SOURCE).GetFootprints()}
    board = pcbnew.NewBoard(out)
    board.SetCopperLayerCount(8)
    ds = board.GetDesignSettings()
    ds.SetBoardThickness(mm(1.6))
    ds.SetAuxOrigin(V(*ORIGIN))
    ds.SetGridOrigin(V(*ORIGIN))
    netinfo = {}
    for name in sorted(nets):
        ni = pcbnew.NETINFO_ITEM(board, name)
        board.Add(ni)
        netinfo[name] = ni

    staged = {}
    report = []
    n_block = 0
    for ref in sorted(comps, key=lambda r: (comps[r]["sheetfile"], r)):
        cm = comps[ref]
        if cm["excluded"]:
            continue
        block = is_block(ref, source)
        n_block += block

        def make(cm=cm, ref=ref, block=block):
            swapped = block and FP_SWAP.get(ref, ("",))[0] == cm["footprint"]      # REUSE_LOG: another land
            fp = from_source(source[ref], cm["footprint"]) if block and not swapped else load_fp(cm["footprint"])
            fp.SetReference(ref)
            fp.SetValue(cm["value"])
            for fname, val in cm["fields"].items():
                if fname in ("Reference", "Value", "Footprint"):
                    continue
                if fname == "Datasheet":
                    fp.GetField(pcbnew.FIELD_T_DATASHEET).SetText(val)
                elif fname == "Description":
                    fp.GetField(pcbnew.FIELD_T_DESCRIPTION).SetText(val)
                else:
                    fp.SetField(fname, val)
                    for f in fp.GetFields():
                        if f.GetName() == fname:
                            f.SetVisible(False)
            fp.SetPath(pcbnew.KIID_PATH(cm["sheet_tstamps"] + cm["tstamps"][0]))
            fp.SetSheetname(cm["sheetname"])
            fp.SetSheetfile(cm["sheetfile"])
            if cm["dnp"]:
                fp.SetDNP(True)
            for pad in fp.Pads():
                if ref in PAD_SIZE:
                    d, drill = PAD_SIZE[ref]
                    pad.SetSize(pcbnew.F_Cu, V(d, d))
                    pad.SetDrillSize(V(drill, drill))
                net = pin_net.get((ref, pad.GetNumber()))
                pad.SetNet(netinfo[net] if net is not None else None)
                fn, typ = pins.get((ref, pad.GetNumber()), ("", ""))
                pad.SetPinFunction(fn)
                pad.SetPinType(typ)
            return fp
        if ref in FIXED:
            side, pads, anchor = FIXED[ref]
            orient = fit_fixed(board, make, side, pads, anchor)
            report.append(f"{ref}: {side}, orientation {orient:g}, pads on MECHANICAL.md positions")
        elif ref in SOFT:
            x, y, o, side = SOFT[ref]
            place(board, make(), x, y, side, o)
        else:
            staged.setdefault(cm["sheetfile"] or "root", []).append(make)
    # stage the rest by sheet: shelf packing on their real courtyard/bounding boxes, right of the board
    y = 45.0
    for sheet in sorted(staged):
        x, row_h = 215.0, 0.0
        for make in staged[sheet]:
            fp = make()
            place(board, fp, 0.0, 0.0, "top", 0.0)
            bb = fp.GetBoundingBox(False, False)
            w, h = pcbnew.ToMM(bb.GetWidth()), pcbnew.ToMM(bb.GetHeight())
            if x + w > 215.0 + 160.0:
                x, y, row_h = 215.0, y + row_h + 1.5, 0.0
            dx, dy = x - pcbnew.ToMM(bb.GetX()), y - pcbnew.ToMM(bb.GetY())
            fp.SetPosition(V(dx, dy))
            x += w + 1.5
            row_h = max(row_h, h)
        y += row_h + 6.0
    add_outline(board)
    for fp in board.GetFootprints():
        hide_designators(fp)
    pcbnew.SaveBoard(out, board)
    for r in report:
        print("make_board: " + r)
    print(f"make_board: {len(comps)} footprints ({n_block} from the source board), {len(nets)} nets "
          f"-> {os.path.relpath(out, ROOT)}")


if __name__ == "__main__":
    main()
