johonkanen/ac_psu_zynq_kicad/(commit log)

2026-10-26 Initial plan: Zynq-7000 card reusing the pinguz97/Zynq-SoM DDR3 block
    - PLAN.md: survey of open Zynq-7000 boards (DDR3, eMMC, Ethernet), choice of
    pinguz97/Zynq-SoM (XC7Z020 CLG484, 512 MB DDR3L, RTL8211F, eMMC) as the
    routed source block, fallbacks, the block import method and the phases.
    - Decisions: 512 MB, CERN-OHL-S-2.0, eMMC and PHY copper in the block,
    speed grade -1 or -2 by stock.
    - LICENSE (CERN-OHL-S-2.0), NOTICE with the source commit.
    - tools/ddr_survey.py: per-net length, layers and vias of DDR nets in a board.
2026-10-26 Plan: block is SoC + DDR3 only, CLG484 package, source review step
    - Only the Zynq and DDR3 are reused; eMMC, Ethernet PHY and QSPI are routed
    here (schematic and routing steps added). NOTICE narrowed to match.
    - Package decided: XC7Z020 CLG484 (JLC stock for -1 and -2). Primary source
    pinguz97/Zynq-SoM, fallback juliancoy/zynqPCB (routed CLG484, 2 x DDR3,
    untested); the proven CLG400/FBG676 boards are kept as references.
    - Survey adds kangyuzhe666/ZYNQ7010-7020_AD9363 (proven, Apache-2.0, CLG400)
    and ciaa/Hardware CIAA-ACC, with measured DDR lengths.
    - New phase 0.1: ask the pinguz97 author and review the route against UG933
    before the import; fix issues inside the block and log t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
2026-10-26 UG933 review of the CLG484 DDR3 sources; Zynq PCB notes
    - DDR3_REVIEW.md: pinguz97/Zynq-SoM fails. Its x16 DRAM is on PS DDR byte
    lanes 2/3 (16-bit mode uses lanes 0/1, UG585), and VRP/VRN are swapped.
    Its delays are tightly matched (DQ-DQS 0-0.5 ps). It is a 50/100 ohm route
    with 22 ohm series termination instead of VTT. juliancoy/zynqPCB passes:
    correct lanes and VRP/VRN, fly-by with 40 ohm VTT, skews within the UG933
    App. A limits; impedance unknown, untested.
    - ZYNQ_PCB_NOTES.md: supplies and decoupling, sequencing and PS_POR_B, boot
    straps (QSPI boot; the BootROM has no eMMC boot), MIO/bank voltages,
    configuration pins (CFGBVS, PUDC_B high), DDR3/DDR3L routing rules (no DD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
    [ddr3_review.py, zsolve.py, zsolve_cases.py]
2026-10-26 Switch DDR3 block to juliancoy/zynqPCB, 1 GB, MIT licence
    - Decisions: block source juliancoy/zynqPCB (commit 5cb7c70) after the UG933
    review rejected pinguz97; both DRAMs fitted (1 GB, 32-bit), using
    MT41K256M16TW-107 on the HA land (HA-125 has no JLC stock); MIT licence.
    - LICENSE is now MIT; NOTICE carries the juliancoy source, commit and MIT
    notice. Nothing from pinguz97 is copied.
    - PLAN.md: block contents and refs (U20, U15/U16, VTT TPS51200, terminations),
    KiCad 5 import, layer-role mapping (GND on L2/L4/L6), stack-up/impedance
    choice for the 0.102 mm traces, phase 0.1 open points, risks, decisions.
    - README, ZYNQ_PCB_NOTES (32-bit PS7 setting), DDR3_REVIEW updated to match.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
2026-10-26 Bank 500 at 1.8 V with the IS25WP128 QSPI flash
    - Both MIO banks at 1.8 V (VCCO_MIO0/1 from 1V8, MIO7/MIO8 pulled up),
    PS_CLK oscillator at 1.8 V.
    - QSPI: IS25WP128-RHLE (C1349419), shared with the Agilex/Ti135 cards; notes
    on BootROM 16 MB addressing, RESET#, program_flash/U-Boot support to verify.
2026-10-26 Stack-up: JLC081611-7628 for the 0.102 mm DDR3 traces
    - tools/stackup_scan.py: field-solves a trace width on every signal layer of
    JLC 8-layer templates (gsuberland/jlcpcb_autogenerated_stackups), with
    juliancoy's layer roles (GND In1/In3/In5). Full results for all 49
    templates in reference/stackup_scan_0p102mm.txt.
    - Chosen JLC081611-7628 (1.593 mm, 1 oz inner): 0.102 mm is 39.5 ohm SE /
    71.4 ohm diff on In2/In4 (CK, data) and 45.5/74.6 ohm on In6 (addr/cmd),
    47.4 ohm even without a B plane. No re-width of the block.
    - Outer layers are 111 ohm at 0.102 mm (0.42 mm prepreg): fan-out and pours
    only; MDI pairs 0.35/0.20 mm on F.Cu = 102 ohm.
    - ddr3_review.py takes per-stack-up prop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
2026-10-27 DDR block checks on JLC081611-7628; planned block edits
    - ddr3_review.py: join track ends that land inside a via pad off its centre
    (the four "untraced" U15 nets were connected); per-layer speeds
    (--ps-layer). All DDR nets now walked on both DRAMs.
    - Results on the chosen stack-up: DQ-DQS, A/C-CK within limits; byte 0
    CK - DQS is 0.0 ps and CK P/N 7.1 ps.
    - REUSE_LOG.md: planned edits E1 (CK_P +4.30 mm, CK_N +3.23 mm in the
    trunk: CK = DQS0 + 25 ps, P/N matched), E2 optional DQS3 match, E3 VTT EN
    off the 3.3 V pull-up, E4 DRAM part swap.
    [ddr3_review.py]
2026-10-27 Vivado pin plan: PS7 MIO/DDR config and PL pins, checked in Vivado
    - vivado/pinplan/pinplan.py: reads signals.csv/groups.csv, assigns PL balls
    (package edge first; MRCC/SRCC, VREF and PUDC_B kept free), builds a
    Vivado 2024.2 project with the PS7 (ps7.tcl) and every PL pin, runs
    synthesis + placement + DRC, and writes zynq_pinplan.csv and ps7_mio.csv.
    - PL: J3 (32) on bank 34, ADC/LCD/LEDs (20) on bank 33; DRC 0, no
    critical warnings.
    - PS7: both MIO banks 1.8 V; QSPI 1-6 + FB clock 8; GEM0 RGMII 16-27 as
    HSTL 1.8 V; MDIO 52/53; SD0 40-45; UART1 48/49 (+ translator); I2C0 50/51;
    DDR3L x32 533 MHz MT41K256M16 RE-125 preset; die-to-die training start
    values (with REUSE_LOG E1), c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
    [groups.csv, mio.csv, ps7_mio.csv, signals.csv, zynq_pinplan.csv]
2026-10-27 Power budget and thermal estimate from Vivado report_power
    - vivado/pinplan/power.tcl: report_power on the pin-plan design (PS7 as
    configured) at fixed Tj for rail sizing and with explicit theta-JA for
    thermal cases; results in vivado/pinplan/power_summary.csv. pinplan.py
    now writes placed.dcp.
    - POWER_BUDGET.md: Zynq rails (1.9 W typ / 3.0 W high on chip) plus a PL
    allowance and the other loads: 5 V input 0.89 A typ / 1.44 A high, so the
    planned 1.5-2 A baseboard U8 is needed. 4 x TLV62585 (1V0 up to 2.4 A,
    1V8, 1V35, 3V3) with E96 dividers; TPS51200 for VTT.
    - Thermal: bare card over Tj 100 C above about 55 C ambient; a small BGA
    heatsink (theta-JA ~10 C/W) keeps worst-case s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
    [power_summary.csv]
2026-10-27 Heatsink: Wakefield 960-23-33-D-AB-0 on U20; thermal at 40 C ambient
    - Ambient 40 C worst case (user). Vivado: worst-case silicon is not stable
    without a heatsink on this card; with theta-JA ~10 C/W (case path
    3.35 + tape + pin-fin, parallel to the board path) Tj is 61 C.
    - Heatsink: Wakefield-Vette 960-23-33-D-AB-0 (DigiKey 345-1804-ND), the
    Agilex card's part. Datasheet: 2 x 3.18 mm holes at +/-14.93 mm on the
    diagonal. Here NPTH 3.2 mm with 6 mm keep-outs, on the block diagonal
    that is free of block copper.
    - Agilex card checked (read only): hole positions match within 0.1 mm, but
    the drills are 3.0 mm, under the 3.18 mm the push pins need.
    - power.tcl: 40 C cases; power_summa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
    [power_summary.csv]
2026-10-27 Phase 1: submodules, mechanical reference, baseboard pinout
    - Submodules: tools/jlc (jlc-tools), tools/p2k (proteus2kicad, KiCad 10
    env), reference/zynqpcb (juliancoy/zynqPCB at 5cb7c70, the DDR3 block
    source).
    - MECHANICAL.md and reference/baseboard_j11_pinout.csv copied from
    efinix_soc_board (53f655b), with an origin note.
    - README: set-up steps; PLAN phase 1 done.
    [baseboard_j11_pinout.csv]
2026-10-27 STATUS.md: handoff for the next session (phase 2, schematic)
    Status, the decisions not to reopen, next steps for phase 2, conventions
    (block refs below 200, ours at sheet x 100 from sheet 2), open items, how to
    run the tools, and the related sessions.
2026-10-27 Phase 2: project skeleton and sheet 1 (DDR3 block import)
    - p2k_config.py (project zynq_card, 13 sheets), kicad/ from make_skeleton,
    fp-lib-table for juliancoy's DFTcustom footprints
    - tools/gen_symbols.py: lib/zynq_card.kicad_sym with juliancoy's XC7Z020
    (9 units), MT41K256M16 and TPS51200 from the upgraded cache lib, plus
    KiCad 10 passives and power symbols
    - tools/sheets/01_ddr3.py: converts juliancoy's KiCad 5 DDR3.sch (kicad-cli
    cannot save legacy schematics) with source refs, coordinates and DDR3_*
    names; pin positions checked against the KiCad 5 symbols; E3 (DDR3_VTT_EN
    is a sheet port) and E4 (MT41K256M16TW-107:P) applied
    - tools/check_block_netlist.py: every pad of sheet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
    [01_ddr3.kicad_sch, 02_pwr_input.kicad_sch, 03_pwr_rails.kicad_sch, 04_pwr_seq.kicad_sch, 05_soc_power.kicad_sch, 06_soc_config.kicad_sch, 07_clocks.kicad_sch, 08_qspi.kicad_sch]
2026-10-27 Phase 2: sheet 5 (SoC power): U20 unit 9 and decoupling
    - tools/sheets/_legacy.py: the KiCad 5 converter, shared by the block
    sheets; keep= takes a subset of a source sheet and prunes what no longer
    reaches a kept pin, cut= drops source wires, mirrored symbols supported.
    01_ddr3.py uses it and regenerates byte-identical
    - tools/sheets/05_soc_power.py: U20 unit 9 and the 21 power.sch decaps in
    the block copper (source refs/positions), the 16 3V3 block caps juliancoy
    drew on other sheets, and C501-C529 + FB501 to meet UG933 Tables 3-1/3-2
    - E5: VCCPLL through its own 120R bead + 10u + 470n; FB1 (juliancoy's
    VCCAUX bead) becomes a 0 ohm jumper. E6: C59/C122 on 1V8 (MIO banks).
    E7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
    [05_soc_power.kicad_sch]
2026-10-27 Phase 2: sheet 6 (SoC config): MIO banks, bank 0, boot straps, JTAG
    - tools/sheets/06_soc_config.py: U20 units 6/7 (MIO banks 500/501, 1.8 V)
    with every used MIO as a sheet port, boot straps R601-R607 (QSPI boot,
    JTAG cascaded, PLLs on, VMODE 1.8/1.8), PS_POR_B/PS_SRST_B pull-ups,
    PS_MIO_VREF divider; unit 1 (bank 0 at 1.8 V) tied off as on juliancoy,
    R9/R10 kept as block parts, DONE 330R, RSVDGND open (E8)
    - J1 (1x5, 3.3 V for FTDI mini-modules) through U601 SN74AVC4T774RSVR,
    the Agilex 3 card's JTAG shifter circuit
    - check_block_netlist.py covers sheet 6: on units 1/6/7 only rail/GND balls
    and balls on block-part nets are compared; E3/E7/E8 expected differences;
    J-refs are ne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
    [06_soc_config.kicad_sch, zynq_card.kicad_sch]
2026-10-27 Phase 2: sheet 7 (clocks): 33.333 MHz PS_CLK oscillator
    - tools/sheets/07_clocks.py: Y701 YXC OT322533.3333MJBA4SL (C2831392,
    1.8 V CMOS, 3225) with the Agilex 3 card's oscillator circuit: EN tied
    to VDD, FB701 BLM18PG121SN1D + C701 470n supply filter, R701 33R
    source-series to the ps_clk port (U20 F7)
    - gen_symbols: Oscillator:ASE-xxxMHz
    - STATUS updated; REUSE_LOG E8 commit ref
    [07_clocks.kicad_sch, zynq_card.kicad_sch]
2026-10-27 Phase 2: sheets 2-4 (power input, rails, sequencing + PS_POR_B supervisor)
    Sheet 2: J6 (baseboard J12) to 5V0/GND with PWR_FLAGs and the Ti135 input bulk.
    Sheet 3: 4 x TLV62585 (1V0, 1V8, 3V3, 1V35) from the Ti135 cell (_power.py) and
    the NCP163 3V3_analog LDO.
    Sheet 4: enable chain 1V0 -> 1V8 -> 3V3 + 1V35 -> DDR3_VTT_EN (wired PG AND)
    and a TPS3808G01 onto ps_por_n: SENSE on 1V0 (0.895 V), CT = VDD (300 ms),
    which keeps PS_POR_B release outside every DS187 Table 23 lockdown window.
    Closes the lockdown-window [verify] item. ERC: rails driven; block check 0 failures.
    [02_pwr_input.kicad_sch, 03_pwr_rails.kicad_sch, 04_pwr_seq.kicad_sch, zynq_card.kicad_sch]
2026-10-27 Phase 2: sheets 8-10 (QSPI flash, RTL8211F Ethernet, eMMC)
    Sheet 8: IS25WP128-RHLE on QSPI0 at 1V8, CS# pull-up, RESET# on ps_por_n.
    Sheet 9: the Ti135 RTL8211FDI-CG + HR911130A sheet on GEM0 RGMII / MDIO0.
    RGMII and MDIO pads at 1.8 V via the PHY's internal LDO; INTB is open drain,
    so its 1V8 pull-up is fine (closes the INTB [verify]). eth_rst_n pull-down
    is 1k to beat the MIO reset pull-up.
    Sheet 10: THGAMVG7T13BAIL on SD0, 4-bit, with the KIOXIA decoupling values.
    Symbols ported from the Ti135 card into gen_symbols.py; its flash and RJ45
    footprints copied into lib/zynq_card.pretty. fill_footprints() in _common.py.
    Every port checked against the U20 MIO balls in the netlist. ERC: only the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
    [08_qspi.kicad_sch, 09_ethernet.kicad_sch, 10_emmc.kicad_sch, zynq_card.kicad_sch]
2026-10-27 Phase 2: sheet 11 (PL banks 13/33/34/35, all VCCO on 3V3)
    U20 units 2-5 with one hierarchical label per pin-plan signal (ball and
    pin function asserted against the symbol); unused balls left open.
    PUDC_B (K16) tied to VCCO_34; user LEDs D1101/D1102 on bank 33.
    New block change E9: juliancoy grounds every I/O ball of banks 34/35;
    here they carry our nets or stay open (copper planned). The block check
    covers sheet 11, with E7/E9 balls generated from the symbol: 0 failures,
    322 U20 balls. All 52 pin-plan signals verified on their balls.
    [11_soc_pl.kicad_sch, zynq_card.kicad_sch]
2026-10-27 Phase 2: sheets 12-13 (ADC, connectors) + pin-plan netlist check
    - Sheet 12: Ti135 ADC chain (SN74LV4051A checked against SCLS428K, OPA365,
    ADS7056 with AVDD on 3V3_analog and DVDD on 3V3), selects/SPI straight to bank 33.
    - Sheet 13: J3 (baseboard J11 numbering, pin-plan notes asserted) with 32 x 10 k
    pull-downs, J5 LCD/touch, J2 console via SN74AVC4T774 (per-bit direction),
    I2C0 4.7 k pull-ups to 1V8 (no EEPROM for now).
    - tools/check_pinplan_netlist.py: every PL and MIO signal on its ball: 0 failures.
    - ERC: 4 expected pin_to_pin ties; block check 0 failures.
    [12_adc.kicad_sch, 13_connectors.kicad_sch, mio.csv, zynq_card.kicad_sch]
2026-10-27 Phase 3 step 1: board, stack-up, rules
    LAYOUT_PLAN.md: the phase 3 plan (board, block import, pose A, placement).
    tools/make_board.py builds the board from the netlist; the 101 block parts
    take juliancoy's own footprints. tools/board_setup.py writes the
    JLC081611-7628 stack-up, net classes and DRC rules. Parity 0.
    [zynq_card.kicad_pcb]
2026-10-27 Phase 3 step 2: block copper import
    tools/import_block.py copies juliancoy's SoC + DDR3 copper at pose A,
    nets by pad, and makes the copper side of REUSE_LOG E3 and E5-E9.
    Board-wide rail pours are clipped to the block; GND planes use the
    source's fill settings. tools/check_block_copper.py: all 82 block
    signal nets identical to the source except E3. ddr3_review.py on
    both DRAMs: same lengths and vias, all PASS derated.
    [zynq_card.kicad_pcb]
2026-10-28 Phase 3 steps 3-4: pose trials, rough placement at pose A0
    - placement/: the KiCadRoutingTools inputs ported from the Ti135 card (groups,
    B.Cu TLV62585 templates, flip_bottom, fix_intent with the block and heatsink
    keep-outs, prep.sh), plus pose_trial.sh / pose_chain.txt for the pose trials.
    - Pose trials: A0 29 open nets, Aw 32, Ae 28, B0 36, B1 36 (A beats B). The
    router was allowed to rip block copper in these runs; pose_trial.sh now sets
    KICAD_RIP_PREEXISTING=0 and the clean rerun is still to do.
    - Rough placement on the board: A0's best seed, then the SoC decaps in a second
    run. DRC parity 0, no courtyard/clearance errors; block copper check 0.
    - QSPI (MIO1-6) cannot route at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
    [zynq_card.kicad_pcb]
2026-10-28 Phase 3 step 4: analog copied from the Ti135 card, KRT re-place with claims; QSPI escapes (E10)
    - tools/place_analog.py (ported from the Ti135 card): the ADC chain and the
    3V3_analog LDO take the Ti135 card's final positions from J3 (its copy of
    the Agilex 5 card, same outline and circuit); the four parts that would sit
    in our block area go to the nearest free spot. The J3 pull-down arrays go
    to B.Cu in a column beside J3. All locked.
    - placement/touchup.py: lock all but a set of parts and give each a proximity
    claim to the chip it serves. KRT re-placed the other 143 parts with claims
    (claim weight 20): median distance to their pins 11.1 -> 4.0 mm, Ethernet
    spread 65 -> 23 mm.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
    [zynq_card.kicad_pcb]
2026-10-28 Phase 3 step 4.4: hand fixes with place_free (decaps under U20, VCCPLL, straps, U801, crystals); pose A0 kept
    - tools/place_free.py (ported from the Ti135 card, now two-sided): nearest
    spot to a target that clears the real copper (vias, tracks, pads,
    courtyards, edge, heatsink rings); nothing of ours on top of the block,
    and on B.Cu only under U20 (not under the DDR).
    - placement/hand_fixes.sh: the step-4.4 list in priority order. Our 0402
    SoC decaps 0-3 mm from their rails' balls under U20; VCCPLL filter at H10;
    PS_MIO_VREF divider, POR/SRST pulls, MIO straps at their balls; U801
    south-east of the block; Y901 on B.Cu by the PHY; Y701 + parts south of
    the block; tall bulk caps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
    [zynq_card.kicad_pcb]
2026-10-29 No reference-designator silkscreen; rebuild refills the zones
    - tools/make_board.py hides every footprint's Reference field and any
    ${REFERENCE} text on F/B.SilkS (the F.Fab reference stays); import_block
    does the same for H1/H2 (user request). The 199 silk overlaps are gone;
    only J9's outline over the edge remains (overhang by design).
    - tools/refill_zones.py, run last by build_pcb.sh --rebuild: the import fills
    the zones before the placement is put back.
    - Board rebuilt: DRC parity 0, no clearance/courtyard errors; block copper
    check 0 failures.
    [zynq_card.kicad_pcb]
2026-10-29 Block edit E1: CK trunk meander (byte 0 CK - DQS +27.5 ps, CK P/N 0.0 ps)
    - tools/block_e1.py, run by build_pcb.sh --rebuild after the import: a
    coupled serpentine of the CK pair in its 4.7 mm straight In2 run (0.5 mm
    rungs, amplitude 0.299 mm, P/N as +-0.102 mm offsets of the centreline)
    and a P-only bump on CK_P's free side: CK_P +4.300 mm, CK_N +3.230 mm.
    Clearance checked before writing (nearest other net 0.208 mm).
    - ddr3_review.py, both DRAMs: byte 0 CK - DQS +27.5 ps (was +2.6), CK P/N
    0.0 / 0.1 ps (was 7.1), addr/cmd - CK -24.3..+1.8 ps; all PASS derated.
    - KiCad DRC: no new errors; check_block_copper lists CK_P/N as E1.
    - REUSE_LOG, STATUS, LAYOUT_PLAN: E1 done.
    Co-Author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
    [zynq_card.kicad_pcb]
2026-10-29 Copper layer user names (1.Top, 2.GND, 3.Sig, ... 8.Bottom); board re-made from the schematic
    board_setup.py writes LAYER_NAMES; items, zones and DRC rules keep the standard names. Scripts that print or
    match layer names use GetStandardLayerName. --rebuild: no change from the schematic, parity 0, block check 0 failures.
    [zynq_card.kicad_pcb]
2026-10-29 LCSC numbers for every BOM part (tools/set_lcsc.py); FB1 as 0 R; U20 = XC7Z020-2CLG484I
    tools/set_lcsc.py (run by build_schematic.sh) writes the LCSC field by BOM line: JLC basic parts where there is one,
    juliancoy's Murata/Yageo passives bought as basic equivalents (REUSE_LOG E11). FB1, the E5 0 R jumper, gets
    0603WAF0000T5E / C21189 (its MPN still named the bead). U20: -2 or -3 speed, any temperature grade (user):
    XC7Z020-2CLG484I, C157624. Connectors J1/J2/J3/J5/J6/J9 hand-soldered (no LCSC, skipped in the JLC files).
    ERC unchanged (4 intended pin_to_pin), block netlist 0 failures, board rebuilt: parity 0, block copper 0 failures.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
    [01_ddr3.kicad_sch, 02_pwr_input.kicad_sch, 03_pwr_rails.kicad_sch, 04_pwr_seq.kicad_sch, 05_soc_power.kicad_sch, 06_soc_config.kicad_sch, 07_clocks.kicad_sch, 08_qspi.kicad_sch]
2026-10-29 J3 pads 0.9 mm / 0.6 mm drill so a 0.1 mm track fits between pins; sheets as saved by eeschema
    make_board.py PAD_SIZE (as on the Ti135 card): 0.37 mm between pads, 0.135 mm clearance each side for a 0.1 mm
    track, annular ring 0.15 mm; checked by DRC with test tracks across and along the rows. Board rebuilt: parity 0,
    block copper 0 failures. The sheets are the user's eeschema save: format and field order only (Value, Footprint,
    MPN and all 309 LCSC fields unchanged). STATUS: the path to the order.
    [01_ddr3.kicad_sch, 02_pwr_input.kicad_sch, 03_pwr_rails.kicad_sch, 04_pwr_seq.kicad_sch, 05_soc_power.kicad_sch, 06_soc_config.kicad_sch, 07_clocks.kicad_sch, 08_qspi.kicad_sch]
2026-10-29 Bottom-side heights checked (tools/check_heights.py), C67 22 uF 1206 (E12); RGMII TX series R at the SoC end
    - tools/check_heights.py: the baseboard mapped through J11/J12, every card B.Cu part over a baseboard part within
    the 5.3 mm gap less 0.3 mm. C67 (100 uF 1210, 2.7 mm) over U17 (SOIC-16W) failed: now 22 uF 1206 CL31A226KAHNNNE
    (REUSE_LOG E12, user), 0.85 mm left; all pass. FP_SWAP in check_block_netlist.py, used by make_board/import_block.
    H1 push-pin barb over U17 fits (user).
    - PHY area: TX series 22 R (R901-R906) moved from the PHY to B.Cu east of the block (sheet 9: TX at the SoC);
    R606 out of the eMMC ball field (placement/hand_fixes.sh).
    - tools/sheets/_common.py: eesche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
    [01_ddr3.kicad_sch, 02_pwr_input.kicad_sch, 03_pwr_rails.kicad_sch, 04_pwr_seq.kicad_sch, 05_soc_power.kicad_sch, 06_soc_config.kicad_sch, 07_clocks.kicad_sch, 08_qspi.kicad_sch]
2026-10-29 U801 fan-out (vias between the balls), straps beside the via field; board plots workflow
    - tools/fanout_u801.py (run by build_pcb.sh --rebuild): 9 standard 0.48/0.25 mm vias between U801's 1.0 mm-pitch
    balls, F.Cu stubs from each used ball. The Agilex 5 card's via-in-pad 0.3/0.15 is below this card's minimums.
    - R601-R605, R801, C801 on B.Cu beside the via field (place_free.py --clear-vias: no via in a courtyard).
    - .github/workflows/board-plots.yml (johonkanen/kicad-board-plots) and the README board section; README status.
    DRC: no clearance errors, parity 0; block copper and heights 0 failures.
    [zynq_card.kicad_pcb]
2026-10-29 README: update board plot table
2026-10-29 PHY in front of the magjack (zynq_mini arrangement): MDI 4.3-7.2 mm to J9
    U901 at J9's pin side, 180 deg (MDI toward the jack, RX west to the SoC, TX north); decaps, FB901, RSET and the RX
    series 22 R on F.Cu around it, crystal, straps, pull-ups and the reset buffer under it on B.Cu (placement/hand_fixes.sh,
    last section). MDI was 11.6-19.1 mm. check_heights.py: SC-70-5 (U902 now on B.Cu). DRC parity 0, block copper and
    heights 0 failures; zone fills unchanged.
    [zynq_card.kicad_pcb]
2026-10-30 E13: C99 out from under the heatsink base; phase 3 layer renders done
    C99 (1V35 bulk, 100 uF 1210, 2.7 mm) sat 1.2-1.4 mm inside the heatsink
    base, where nothing may be taller than the package. tools/block_e13.py
    (run by build_pcb.sh --rebuild after block_e1.py) moves it 2.2 mm north;
    its GND via stays (DDR3 copper on every inner layer under the moved pad)
    and a 0.3 mm F.Cu track joins pad 2 to it. DRC unchanged, block copper
    check 0 failures, a --rebuild reproduces the board.
    [zynq_card.kicad_pcb]
2026-10-30 Net class colours: pl_io (new, from the pin plan) lime green, mio_fast cyan
    board_setup.py adds a pl_io class (Default geometry) for the 52 PL I/O
    signals of vivado/pinplan/zynq_pinplan.csv and writes a PCB colour for
    pl_io and mio_fast (COLORS), to pick them out of the BGA while routing
    (pcbnew Appearance > Nets > Net colors: All). DRC unchanged.
2026-10-30 PHY area tightened after the Avaota A1: MDI corridor and TX exit clear; phy_pwr class, MDI breakout rule
    Open boards with the RTL8211F surveyed; Avaota A1 (U12 + HR911130A, CERN-OHL-S) used as a reference only. The MDI
    corridor between U901 and J9 and the TX/MDC/MDIO exit north of U901 are free of F.Cu parts (place_free.py
    --keepout): C933/C934 (VDD10, pins 3/8) on B.Cu just outside those pins, FB901/C920 north-east, R909/R911/C930 to the
    north-west corner, R933 beside U902, R950 at J9's LED pin (placement/hand_fixes.sh, last section).
    Net classes: the PHY rails are phy_pwr (0.2 mm, fits the 0.4 mm-pitch QFN pads); rule mdi_breakout allows the MDI
    pairs 0.2/0.2 mm (min 0.1) inside U901's co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
    [zynq_card.kicad_pcb]
2026-10-31 Board plots: kicad-board-plots v1.1 with 3D top and bottom renders
